prj3grp7/prj3_projekt_dokumentation/Softwaredesign/Demoer/BeerPongTable_LED_Demo/Design01.cydsn/Design01_timing.html

# Static Timing Analysis

Project : | Design01
Build Time : | 10/25/18 20:57:47
Device : | CY8C5888LTI-LP097
Temperature : | -40C - 85/125C
VDDA : | 5.00
VDDABUF : | 5.00
VDDD : | 5.00
VDDIO0 : | 5.00
VDDIO1 : | 5.00
VDDIO2 : | 5.00
VDDIO3 : | 5.00
VUSB : | 5.00
Voltage : | 5.0

Expand All | Collapse All | Show All Paths | Hide All Paths

+ Timing Violation Section

No Timing Violations

+ Clock Summary Section

Clock | Domain | Nominal Frequency | Required Frequency | Maximum Frequency | Violation
ClockBlock/dclk_glb_ff_3 | ClockBlock/dclk_glb_ff_3 | UNKNOWN | UNKNOWN | N/A
CyILO | CyILO | 1.000 kHz | 1.000 kHz | N/A
CyIMO | CyIMO | 3.000 MHz | 3.000 MHz | N/A
CyMASTER_CLK | CyMASTER_CLK | 24.000 MHz | 24.000 MHz | N/A
CyBUS_CLK | CyMASTER_CLK | 24.000 MHz | 24.000 MHz | 60.580 MHz
Clock_SPI | CyMASTER_CLK | 24.000 MHz | 24.000 MHz | 62.089 MHz
Clock_PWM | CyMASTER_CLK | 24.000 MHz | 24.000 MHz | 74.113 MHz
UART_1_IntClock | CyMASTER_CLK | 76.677 kHz | 76.677 kHz | 56.763 MHz
Clock_LedUpdate | CyMASTER_CLK | 366.211 Hz | 366.211 Hz | N/A
CyPLL_OUT | CyPLL_OUT | 24.000 MHz | 24.000 MHz | N/A

+ Register to Register Section

+ Setup Subsection

+ Source Clock : Clock_PWM : Positive edge(Required Frequency 24 MHz)

+ Destination Clock : Clock_PWM : Positive edge(Required Frequency 24 MHz)

Path Delay Requirement : 41.6667ns(24 MHz)

Source | Destination | FMax | Delay (ns) | Slack (ns) | Violation
\PWM_GREEN:PWMUDB:sP8:pwmdp:u0\/z0_comb | \PWM_GREEN:PWMUDB:genblk8:stsreg\/status_2 | 74.113 MHz | 13.493 | 28.174

Type | Location | Fanout | Instance/Net | Source | Dest | Delay (ns)
datapathcell3 | U(0,3) | 1 | \PWM_GREEN:PWMUDB:sP8:pwmdp:u0\ | \PWM_GREEN:PWMUDB:sP8:pwmdp:u0\/clock | \PWM_GREEN:PWMUDB:sP8:pwmdp:u0\/z0_comb | 2.290
Route | | 1 | \PWM_GREEN:PWMUDB:tc_i\ | \PWM_GREEN:PWMUDB:sP8:pwmdp:u0\/z0_comb | \PWM_GREEN:PWMUDB:status_2\/main_1 | 3.672
macrocell3 | U(0,1) | 1 | \PWM_GREEN:PWMUDB:status_2\ | \PWM_GREEN:PWMUDB:status_2\/main_1 | \PWM_GREEN:PWMUDB:status_2\/q | 3.350
Route | | 1 | \PWM_GREEN:PWMUDB:status_2\ | \PWM_GREEN:PWMUDB:status_2\/q | \PWM_GREEN:PWMUDB:genblk8:stsreg\/status_2 | 3.681
statusicell3 | U(0,3) | 1 | \PWM_GREEN:PWMUDB:genblk8:stsreg\ | | SETUP | 0.500
Clock | | | | | Skew | 0.000
\PWM_GREEN:PWMUDB:runmode_enable\/q | \PWM_GREEN:PWMUDB:genblk8:stsreg\/status_2 | 83.084 MHz | 12.036 | 29.631

Type | Location | Fanout | Instance/Net | Source | Dest | Delay (ns)
macrocell25 | U(1,2) | 1 | \PWM_GREEN:PWMUDB:runmode_enable\ | \PWM_GREEN:PWMUDB:runmode_enable\/clock_0 | \PWM_GREEN:PWMUDB:runmode_enable\/q | 1.250
Route | | 1 | \PWM_GREEN:PWMUDB:runmode_enable\ | \PWM_GREEN:PWMUDB:runmode_enable\/q | \PWM_GREEN:PWMUDB:status_2\/main_0 | 3.255
macrocell3 | U(0,1) | 1 | \PWM_GREEN:PWMUDB:status_2\ | \PWM_GREEN:PWMUDB:status_2\/main_0 | \PWM_GREEN:PWMUDB:status_2\/q | 3.350
Route | | 1 | \PWM_GREEN:PWMUDB:status_2\ | \PWM_GREEN:PWMUDB:status_2\/q | \PWM_GREEN:PWMUDB:genblk8:stsreg\/status_2 | 3.681
statusicell3 | U(0,3) | 1 | \PWM_GREEN:PWMUDB:genblk8:stsreg\ | | SETUP | 0.500
Clock | | | | | Skew | 0.000
\PWM_BLUE:PWMUDB:sP8:pwmdp:u0\/z0_comb | \PWM_BLUE:PWMUDB:genblk8:stsreg\/status_2 | 84.324 MHz | 11.859 | 29.808

Type | Location | Fanout | Instance/Net | Source | Dest | Delay (ns)
datapathcell2 | U(1,2) | 1 | \PWM_BLUE:PWMUDB:sP8:pwmdp:u0\ | \PWM_BLUE:PWMUDB:sP8:pwmdp:u0\/clock | \PWM_BLUE:PWMUDB:sP8:pwmdp:u0\/z0_comb | 2.290
Route | | 1 | \PWM_BLUE:PWMUDB:tc_i\ | \PWM_BLUE:PWMUDB:sP8:pwmdp:u0\/z0_comb | \PWM_BLUE:PWMUDB:status_2\/main_1 | 3.404
macrocell2 | U(1,1) | 1 | \PWM_BLUE:PWMUDB:status_2\ | \PWM_BLUE:PWMUDB:status_2\/main_1 | \PWM_BLUE:PWMUDB:status_2\/q | 3.350
Route | | 1 | \PWM_BLUE:PWMUDB:status_2\ | \PWM_BLUE:PWMUDB:status_2\/q | \PWM_BLUE:PWMUDB:genblk8:stsreg\/status_2 | 2.315
statusicell2 | U(1,1) | 1 | \PWM_BLUE:PWMUDB:genblk8:stsreg\ | | SETUP | 0.500
Clock | | | | | Skew | 0.000
\PWM_BLUE:PWMUDB:runmode_enable\/q | \PWM_BLUE:PWMUDB:genblk8:stsreg\/status_2 | 87.642 MHz | 11.410 | 30.257

Type | Location | Fanout | Instance/Net | Source | Dest | Delay (ns)
macrocell21 | U(0,3) | 1 | \PWM_BLUE:PWMUDB:runmode_enable\ | \PWM_BLUE:PWMUDB:runmode_enable\/clock_0 | \PWM_BLUE:PWMUDB:runmode_enable\/q | 1.250
Route | | 1 | \PWM_BLUE:PWMUDB:runmode_enable\ | \PWM_BLUE:PWMUDB:runmode_enable\/q | \PWM_BLUE:PWMUDB:status_2\/main_0 | 3.995
macrocell2 | U(1,1) | 1 | \PWM_BLUE:PWMUDB:status_2\ | \PWM_BLUE:PWMUDB:status_2\/main_0 | \PWM_BLUE:PWMUDB:status_2\/q | 3.350
Route | | 1 | \PWM_BLUE:PWMUDB:status_2\ | \PWM_BLUE:PWMUDB:status_2\/q | \PWM_BLUE:PWMUDB:genblk8:stsreg\/status_2 | 2.315
statusicell2 | U(1,1) | 1 | \PWM_BLUE:PWMUDB:genblk8:stsreg\ | | SETUP | 0.500
Clock | | | | | Skew | 0.000
\PWM_BLUE:PWMUDB:sP8:pwmdp:u0\/z0_comb | \PWM_BLUE:PWMUDB:sP8:pwmdp:u0\/cs_addr_2 | 91.191 MHz | 10.966 | 30.701

Type | Location | Fanout | Instance/Net | Source | Dest | Delay (ns)
datapathcell2 | U(1,2) | 1 | \PWM_BLUE:PWMUDB:sP8:pwmdp:u0\ | \PWM_BLUE:PWMUDB:sP8:pwmdp:u0\/clock | \PWM_BLUE:PWMUDB:sP8:pwmdp:u0\/z0_comb | 2.290
datapathcell2 | U(1,2) | 1 | \PWM_BLUE:PWMUDB:sP8:pwmdp:u0\ | \PWM_BLUE:PWMUDB:sP8:pwmdp:u0\/z0_comb | \PWM_BLUE:PWMUDB:sP8:pwmdp:u0\/cs_addr_2 | 2.616
datapathcell2 | U(1,2) | 1 | \PWM_BLUE:PWMUDB:sP8:pwmdp:u0\ | | SETUP | 6.060
Clock | | | | | Skew | 0.000
\PWM_RED:PWMUDB:sP8:pwmdp:u0\/z0_comb | \PWM_RED:PWMUDB:genblk8:stsreg\/status_2 | 91.500 MHz | 10.929 | 30.738

Type | Location | Fanout | Instance/Net | Source | Dest | Delay (ns)
datapathcell1 | U(1,0) | 1 | \PWM_RED:PWMUDB:sP8:pwmdp:u0\ | \PWM_RED:PWMUDB:sP8:pwmdp:u0\/clock | \PWM_RED:PWMUDB:sP8:pwmdp:u0\/z0_comb | 2.290
Route | | 1 | \PWM_RED:PWMUDB:tc_i\ | \PWM_RED:PWMUDB:sP8:pwmdp:u0\/z0_comb | \PWM_RED:PWMUDB:status_2\/main_1 | 2.538
macrocell1 | U(1,0) | 1 | \PWM_RED:PWMUDB:status_2\ | \PWM_RED:PWMUDB:status_2\/main_1 | \PWM_RED:PWMUDB:status_2\/q | 3.350
Route | | 1 | \PWM_RED:PWMUDB:status_2\ | \PWM_RED:PWMUDB:status_2\/q | \PWM_RED:PWMUDB:genblk8:stsreg\/status_2 | 2.251
statusicell1 | U(1,0) | 1 | \PWM_RED:PWMUDB:genblk8:stsreg\ | | SETUP | 0.500
Clock | | | | | Skew | 0.000
\PWM_RED:PWMUDB:sP8:pwmdp:u0\/z0_comb | \PWM_RED:PWMUDB:sP8:pwmdp:u0\/cs_addr_2 | 91.962 MHz | 10.874 | 30.793

Type | Location | Fanout | Instance/Net | Source | Dest | Delay (ns)
datapathcell1 | U(1,0) | 1 | \PWM_RED:PWMUDB:sP8:pwmdp:u0\ | \PWM_RED:PWMUDB:sP8:pwmdp:u0\/clock | \PWM_RED:PWMUDB:sP8:pwmdp:u0\/z0_comb | 2.290
datapathcell1 | U(1,0) | 1 | \PWM_RED:PWMUDB:sP8:pwmdp:u0\ | \PWM_RED:PWMUDB:sP8:pwmdp:u0\/z0_comb | \PWM_RED:PWMUDB:sP8:pwmdp:u0\/cs_addr_2 | 2.524
datapathcell1 | U(1,0) | 1 | \PWM_RED:PWMUDB:sP8:pwmdp:u0\ | | SETUP | 6.060
Clock | | | | | Skew | 0.000
\PWM_GREEN:PWMUDB:runmode_enable\/q | \PWM_GREEN:PWMUDB:sP8:pwmdp:u0\/cs_addr_1 | 93.197 MHz | 10.730 | 30.937

Type | Location | Fanout | Instance/Net | Source | Dest | Delay (ns)
macrocell25 | U(1,2) | 1 | \PWM_GREEN:PWMUDB:runmode_enable\ | \PWM_GREEN:PWMUDB:runmode_enable\/clock_0 | \PWM_GREEN:PWMUDB:runmode_enable\/q | 1.250
Route | | 1 | \PWM_GREEN:PWMUDB:runmode_enable\ | \PWM_GREEN:PWMUDB:runmode_enable\/q | \PWM_GREEN:PWMUDB:sP8:pwmdp:u0\/cs_addr_1 | 3.420
datapathcell3 | U(0,3) | 1 | \PWM_GREEN:PWMUDB:sP8:pwmdp:u0\ | | SETUP | 6.060
Clock | | | | | Skew | 0.000
\PWM_GREEN:PWMUDB:sP8:pwmdp:u0\/z0_comb | \PWM_GREEN:PWMUDB:sP8:pwmdp:u0\/cs_addr_2 | 94.020 MHz | 10.636 | 31.031

Type | Location | Fanout | Instance/Net | Source | Dest | Delay (ns)
datapathcell3 | U(0,3) | 1 | \PWM_GREEN:PWMUDB:sP8:pwmdp:u0\ | \PWM_GREEN:PWMUDB:sP8:pwmdp:u0\/clock | \PWM_GREEN:PWMUDB:sP8:pwmdp:u0\/z0_comb | 2.290
datapathcell3 | U(0,3) | 1 | \PWM_GREEN:PWMUDB:sP8:pwmdp:u0\ | \PWM_GREEN:PWMUDB:sP8:pwmdp:u0\/z0_comb | \PWM_GREEN:PWMUDB:sP8:pwmdp:u0\/cs_addr_2 | 2.286
datapathcell3 | U(0,3) | 1 | \PWM_GREEN:PWMUDB:sP8:pwmdp:u0\ | | SETUP | 6.060
Clock | | | | | Skew | 0.000
\PWM_BLUE:PWMUDB:runmode_enable\/q | \PWM_BLUE:PWMUDB:sP8:pwmdp:u0\/cs_addr_1 | 94.778 MHz | 10.551 | 31.116

Type | Location | Fanout | Instance/Net | Source | Dest | Delay (ns)
macrocell21 | U(0,3) | 1 | \PWM_BLUE:PWMUDB:runmode_enable\ | \PWM_BLUE:PWMUDB:runmode_enable\/clock_0 | \PWM_BLUE:PWMUDB:runmode_enable\/q | 1.250
Route | | 1 | \PWM_BLUE:PWMUDB:runmode_enable\ | \PWM_BLUE:PWMUDB:runmode_enable\/q | \PWM_BLUE:PWMUDB:sP8:pwmdp:u0\/cs_addr_1 | 3.241
datapathcell2 | U(1,2) | 1 | \PWM_BLUE:PWMUDB:sP8:pwmdp:u0\ | | SETUP | 6.060
Clock | | | | | Skew | 0.000

+ Source Clock : Clock_SPI : Positive edge(Required Frequency 24 MHz)

+ Destination Clock : Clock_SPI : Positive edge(Required Frequency 24 MHz)

Path Delay Requirement : 41.6667ns(24 MHz)

Source | Destination | FMax | Delay (ns) | Slack (ns) | Violation
\SPIM_led_control:BSPIM:sR8:Dp:u0\/f1_blk_stat_comb | \SPIM_led_control:BSPIM:RxStsReg\/status_6 | 62.089 MHz | 16.106 | 25.561

Type | Location | Fanout | Instance/Net | Source | Dest | Delay (ns)
datapathcell7 | U(1,4) | 1 | \SPIM_led_control:BSPIM:sR8:Dp:u0\ | \SPIM_led_control:BSPIM:sR8:Dp:u0\/clock | \SPIM_led_control:BSPIM:sR8:Dp:u0\/f1_blk_stat_comb | 3.580
Route | | 1 | \SPIM_led_control:BSPIM:rx_status_4\ | \SPIM_led_control:BSPIM:sR8:Dp:u0\/f1_blk_stat_comb | \SPIM_led_control:BSPIM:rx_status_6\/main_5 | 5.774
macrocell15 | U(1,3) | 1 | \SPIM_led_control:BSPIM:rx_status_6\ | \SPIM_led_control:BSPIM:rx_status_6\/main_5 | \SPIM_led_control:BSPIM:rx_status_6\/q | 3.350
Route | | 1 | \SPIM_led_control:BSPIM:rx_status_6\ | \SPIM_led_control:BSPIM:rx_status_6\/q | \SPIM_led_control:BSPIM:RxStsReg\/status_6 | 2.902
statusicell7 | U(1,2) | 1 | \SPIM_led_control:BSPIM:RxStsReg\ | | SETUP | 0.500
Clock | | | | | Skew | 0.000
\SPIM_led_control:BSPIM:BitCounter\/count_4 | \SPIM_led_control:BSPIM:sR8:Dp:u0\/f1_load | 66.375 MHz | 15.066 | 26.601

Type | Location | Fanout | Instance/Net | Source | Dest | Delay (ns)
count7cell | U(1,4) | 1 | \SPIM_led_control:BSPIM:BitCounter\ | \SPIM_led_control:BSPIM:BitCounter\/clock | \SPIM_led_control:BSPIM:BitCounter\/count_4 | 1.940
Route | | 1 | \SPIM_led_control:BSPIM:count_4\ | \SPIM_led_control:BSPIM:BitCounter\/count_4 | \SPIM_led_control:BSPIM:load_rx_data\/main_0 | 2.820
macrocell12 | U(1,4) | 1 | \SPIM_led_control:BSPIM:load_rx_data\ | \SPIM_led_control:BSPIM:load_rx_data\/main_0 | \SPIM_led_control:BSPIM:load_rx_data\/q | 3.350
Route | | 1 | \SPIM_led_control:BSPIM:load_rx_data\ | \SPIM_led_control:BSPIM:load_rx_data\/q | \SPIM_led_control:BSPIM:sR8:Dp:u0\/f1_load | 4.106
datapathcell7 | U(1,4) | 1 | \SPIM_led_control:BSPIM:sR8:Dp:u0\ | | SETUP | 2.850
Clock | | | | | Skew | 0.000
\SPIM_led_control:BSPIM:BitCounter\/count_1 | \SPIM_led_control:BSPIM:sR8:Dp:u0\/f1_load | 66.485 MHz | 15.041 | 26.626

Type | Location | Fanout | Instance/Net | Source | Dest | Delay (ns)
count7cell | U(1,4) | 1 | \SPIM_led_control:BSPIM:BitCounter\ | \SPIM_led_control:BSPIM:BitCounter\/clock | \SPIM_led_control:BSPIM:BitCounter\/count_1 | 1.940
Route | | 1 | \SPIM_led_control:BSPIM:count_1\ | \SPIM_led_control:BSPIM:BitCounter\/count_1 | \SPIM_led_control:BSPIM:load_rx_data\/main_3 | 2.795
macrocell12 | U(1,4) | 1 | \SPIM_led_control:BSPIM:load_rx_data\ | \SPIM_led_control:BSPIM:load_rx_data\/main_3 | \SPIM_led_control:BSPIM:load_rx_data\/q | 3.350
Route | | 1 | \SPIM_led_control:BSPIM:load_rx_data\ | \SPIM_led_control:BSPIM:load_rx_data\/q | \SPIM_led_control:BSPIM:sR8:Dp:u0\/f1_load | 4.106
datapathcell7 | U(1,4) | 1 | \SPIM_led_control:BSPIM:sR8:Dp:u0\ | | SETUP | 2.850
Clock | | | | | Skew | 0.000
\SPIM_led_control:BSPIM:BitCounter\/count_2 | \SPIM_led_control:BSPIM:sR8:Dp:u0\/f1_load | 66.498 MHz | 15.038 | 26.629

Type | Location | Fanout | Instance/Net | Source | Dest | Delay (ns)
count7cell | U(1,4) | 1 | \SPIM_led_control:BSPIM:BitCounter\ | \SPIM_led_control:BSPIM:BitCounter\/clock | \SPIM_led_control:BSPIM:BitCounter\/count_2 | 1.940
Route | | 1 | \SPIM_led_control:BSPIM:count_2\ | \SPIM_led_control:BSPIM:BitCounter\/count_2 | \SPIM_led_control:BSPIM:load_rx_data\/main_2 | 2.792
macrocell12 | U(1,4) | 1 | \SPIM_led_control:BSPIM:load_rx_data\ | \SPIM_led_control:BSPIM:load_rx_data\/main_2 | \SPIM_led_control:BSPIM:load_rx_data\/q | 3.350
Route | | 1 | \SPIM_led_control:BSPIM:load_rx_data\ | \SPIM_led_control:BSPIM:load_rx_data\/q | \SPIM_led_control:BSPIM:sR8:Dp:u0\/f1_load | 4.106
datapathcell7 | U(1,4) | 1 | \SPIM_led_control:BSPIM:sR8:Dp:u0\ | | SETUP | 2.850
Clock | | | | | Skew | 0.000
\SPIM_led_control:BSPIM:BitCounter\/count_3 | \SPIM_led_control:BSPIM:sR8:Dp:u0\/f1_load | 67.195 MHz | 14.882 | 26.785

Type | Location | Fanout | Instance/Net | Source | Dest | Delay (ns)
count7cell | U(1,4) | 1 | \SPIM_led_control:BSPIM:BitCounter\ | \SPIM_led_control:BSPIM:BitCounter\/clock | \SPIM_led_control:BSPIM:BitCounter\/count_3 | 1.940
Route | | 1 | \SPIM_led_control:BSPIM:count_3\ | \SPIM_led_control:BSPIM:BitCounter\/count_3 | \SPIM_led_control:BSPIM:load_rx_data\/main_1 | 2.636
macrocell12 | U(1,4) | 1 | \SPIM_led_control:BSPIM:load_rx_data\ | \SPIM_led_control:BSPIM:load_rx_data\/main_1 | \SPIM_led_control:BSPIM:load_rx_data\/q | 3.350
Route | | 1 | \SPIM_led_control:BSPIM:load_rx_data\ | \SPIM_led_control:BSPIM:load_rx_data\/q | \SPIM_led_control:BSPIM:sR8:Dp:u0\/f1_load | 4.106
datapathcell7 | U(1,4) | 1 | \SPIM_led_control:BSPIM:sR8:Dp:u0\ | | SETUP | 2.850
Clock | | | | | Skew | 0.000
\SPIM_led_control:BSPIM:BitCounter\/count_0 | \SPIM_led_control:BSPIM:sR8:Dp:u0\/f1_load | 67.272 MHz | 14.865 | 26.802

Type | Location | Fanout | Instance/Net | Source | Dest | Delay (ns)
count7cell | U(1,4) | 1 | \SPIM_led_control:BSPIM:BitCounter\ | \SPIM_led_control:BSPIM:BitCounter\/clock | \SPIM_led_control:BSPIM:BitCounter\/count_0 | 1.940
Route | | 1 | \SPIM_led_control:BSPIM:count_0\ | \SPIM_led_control:BSPIM:BitCounter\/count_0 | \SPIM_led_control:BSPIM:load_rx_data\/main_4 | 2.619
macrocell12 | U(1,4) | 1 | \SPIM_led_control:BSPIM:load_rx_data\ | \SPIM_led_control:BSPIM:load_rx_data\/main_4 | \SPIM_led_control:BSPIM:load_rx_data\/q | 3.350
Route | | 1 | \SPIM_led_control:BSPIM:load_rx_data\ | \SPIM_led_control:BSPIM:load_rx_data\/q | \SPIM_led_control:BSPIM:sR8:Dp:u0\/f1_load | 4.106
datapathcell7 | U(1,4) | 1 | \SPIM_led_control:BSPIM:sR8:Dp:u0\ | | SETUP | 2.850
Clock | | | | | Skew | 0.000
\SPIM_led_control:BSPIM:BitCounter\/count_4 | \SPIM_led_control:BSPIM:TxStsReg\/status_3 | 67.875 MHz | 14.733 | 26.934

Type | Location | Fanout | Instance/Net | Source | Dest | Delay (ns)
count7cell | U(1,4) | 1 | \SPIM_led_control:BSPIM:BitCounter\ | \SPIM_led_control:BSPIM:BitCounter\/clock | \SPIM_led_control:BSPIM:BitCounter\/count_4 | 1.940
Route | | 1 | \SPIM_led_control:BSPIM:count_4\ | \SPIM_led_control:BSPIM:BitCounter\/count_4 | \SPIM_led_control:BSPIM:load_rx_data\/main_0 | 2.820
macrocell12 | U(1,4) | 1 | \SPIM_led_control:BSPIM:load_rx_data\ | \SPIM_led_control:BSPIM:load_rx_data\/main_0 | \SPIM_led_control:BSPIM:load_rx_data\/q | 3.350
Route | | 1 | \SPIM_led_control:BSPIM:load_rx_data\ | \SPIM_led_control:BSPIM:load_rx_data\/q | \SPIM_led_control:BSPIM:TxStsReg\/status_3 | 6.123
statusicell6 | U(1,3) | 1 | \SPIM_led_control:BSPIM:TxStsReg\ | | SETUP | 0.500
Clock | | | | | Skew | 0.000
\SPIM_led_control:BSPIM:BitCounter\/count_1 | \SPIM_led_control:BSPIM:TxStsReg\/status_3 | 67.990 MHz | 14.708 | 26.959

Type | Location | Fanout | Instance/Net | Source | Dest | Delay (ns)
count7cell | U(1,4) | 1 | \SPIM_led_control:BSPIM:BitCounter\ | \SPIM_led_control:BSPIM:BitCounter\/clock | \SPIM_led_control:BSPIM:BitCounter\/count_1 | 1.940
Route | | 1 | \SPIM_led_control:BSPIM:count_1\ | \SPIM_led_control:BSPIM:BitCounter\/count_1 | \SPIM_led_control:BSPIM:load_rx_data\/main_3 | 2.795
macrocell12 | U(1,4) | 1 | \SPIM_led_control:BSPIM:load_rx_data\ | \SPIM_led_control:BSPIM:load_rx_data\/main_3 | \SPIM_led_control:BSPIM:load_rx_data\/q | 3.350
Route | | 1 | \SPIM_led_control:BSPIM:load_rx_data\ | \SPIM_led_control:BSPIM:load_rx_data\/q | \SPIM_led_control:BSPIM:TxStsReg\/status_3 | 6.123
statusicell6 | U(1,3) | 1 | \SPIM_led_control:BSPIM:TxStsReg\ | | SETUP | 0.500
Clock | | | | | Skew | 0.000
\SPIM_led_control:BSPIM:BitCounter\/count_2 | \SPIM_led_control:BSPIM:TxStsReg\/status_3 | 68.004 MHz | 14.705 | 26.962

Type | Location | Fanout | Instance/Net | Source | Dest | Delay (ns)
count7cell | U(1,4) | 1 | \SPIM_led_control:BSPIM:BitCounter\ | \SPIM_led_control:BSPIM:BitCounter\/clock | \SPIM_led_control:BSPIM:BitCounter\/count_2 | 1.940
Route | | 1 | \SPIM_led_control:BSPIM:count_2\ | \SPIM_led_control:BSPIM:BitCounter\/count_2 | \SPIM_led_control:BSPIM:load_rx_data\/main_2 | 2.792
macrocell12 | U(1,4) | 1 | \SPIM_led_control:BSPIM:load_rx_data\ | \SPIM_led_control:BSPIM:load_rx_data\/main_2 | \SPIM_led_control:BSPIM:load_rx_data\/q | 3.350
Route | | 1 | \SPIM_led_control:BSPIM:load_rx_data\ | \SPIM_led_control:BSPIM:load_rx_data\/q | \SPIM_led_control:BSPIM:TxStsReg\/status_3 | 6.123
statusicell6 | U(1,3) | 1 | \SPIM_led_control:BSPIM:TxStsReg\ | | SETUP | 0.500
Clock | | | | | Skew | 0.000
\SPIM_led_control:BSPIM:BitCounter\/count_3 | \SPIM_led_control:BSPIM:TxStsReg\/status_3 | 68.733 MHz | 14.549 | 27.118

Type | Location | Fanout | Instance/Net | Source | Dest | Delay (ns)
count7cell | U(1,4) | 1 | \SPIM_led_control:BSPIM:BitCounter\ | \SPIM_led_control:BSPIM:BitCounter\/clock | \SPIM_led_control:BSPIM:BitCounter\/count_3 | 1.940
Route | | 1 | \SPIM_led_control:BSPIM:count_3\ | \SPIM_led_control:BSPIM:BitCounter\/count_3 | \SPIM_led_control:BSPIM:load_rx_data\/main_1 | 2.636
macrocell12 | U(1,4) | 1 | \SPIM_led_control:BSPIM:load_rx_data\ | \SPIM_led_control:BSPIM:load_rx_data\/main_1 | \SPIM_led_control:BSPIM:load_rx_data\/q | 3.350
Route | | 1 | \SPIM_led_control:BSPIM:load_rx_data\ | \SPIM_led_control:BSPIM:load_rx_data\/q | \SPIM_led_control:BSPIM:TxStsReg\/status_3 | 6.123
statusicell6 | U(1,3) | 1 | \SPIM_led_control:BSPIM:TxStsReg\ | | SETUP | 0.500
Clock | | | | | Skew | 0.000

+ Source Clock : CyBUS_CLK : Positive edge(Required Frequency 24 MHz)

+ Destination Clock : UART_1_IntClock : Positive edge(Required Frequency 76.6773 kHz)

Path Delay Requirement : 41.6667ns(24 MHz)

Affects clock : CyMASTER_CLK

Source | Destination | FMax | Delay (ns) | Slack (ns) | Violation
Rx_1(0)/fb | \UART_1:BUART:sRX:RxShifter:u0\/route_si | 60.580 MHz | 16.507 | 25.160

Type | Location | Fanout | Instance/Net | Source | Dest | Delay (ns)
iocell4 | P12[6] | 1 | Rx_1(0) | Rx_1(0)/in_clock | Rx_1(0)/fb | 2.009
Route | | 1 | Net_117 | Rx_1(0)/fb | \UART_1:BUART:rx_postpoll\/main_1 | 5.451
macrocell9 | U(0,0) | 1 | \UART_1:BUART:rx_postpoll\ | \UART_1:BUART:rx_postpoll\/main_1 | \UART_1:BUART:rx_postpoll\/q | 3.350
Route | | 1 | \UART_1:BUART:rx_postpoll\ | \UART_1:BUART:rx_postpoll\/q | \UART_1:BUART:sRX:RxShifter:u0\/route_si | 2.227
datapathcell6 | U(0,0) | 1 | \UART_1:BUART:sRX:RxShifter:u0\ | | SETUP | 3.470
Clock | | | | | Skew | 0.000
Rx_1(0)/fb | \UART_1:BUART:rx_state_0\/main_9 | 85.222 MHz | 11.734 | 29.933

Type | Location | Fanout | Instance/Net | Source | Dest | Delay (ns)
iocell4 | P12[6] | 1 | Rx_1(0) | Rx_1(0)/in_clock | Rx_1(0)/fb | 2.009
Route | | 1 | Net_117 | Rx_1(0)/fb | \UART_1:BUART:rx_state_0\/main_9 | 6.215
macrocell35 | U(0,1) | 1 | \UART_1:BUART:rx_state_0\ | | SETUP | 3.510
Clock | | | | | Skew | 0.000
Rx_1(0)/fb | \UART_1:BUART:rx_status_3\/main_6 | 85.222 MHz | 11.734 | 29.933

Type | Location | Fanout | Instance/Net | Source | Dest | Delay (ns)
iocell4 | P12[6] | 1 | Rx_1(0) | Rx_1(0)/in_clock | Rx_1(0)/fb | 2.009
Route | | 1 | Net_117 | Rx_1(0)/fb | \UART_1:BUART:rx_status_3\/main_6 | 6.215
macrocell43 | U(0,1) | 1 | \UART_1:BUART:rx_status_3\ | | SETUP | 3.510
Clock | | | | | Skew | 0.000
Rx_1(0)/fb | \UART_1:BUART:rx_state_2\/main_8 | 90.901 MHz | 11.001 | 30.666

Type | Location | Fanout | Instance/Net | Source | Dest | Delay (ns)
iocell4 | P12[6] | 1 | Rx_1(0) | Rx_1(0)/in_clock | Rx_1(0)/fb | 2.009
Route | | 1 | Net_117 | Rx_1(0)/fb | \UART_1:BUART:rx_state_2\/main_8 | 5.482
macrocell38 | U(0,0) | 1 | \UART_1:BUART:rx_state_2\ | | SETUP | 3.510
Clock | | | | | Skew | 0.000
Rx_1(0)/fb | \UART_1:BUART:pollcount_1\/main_3 | 91.158 MHz | 10.970 | 30.697

Type | Location | Fanout | Instance/Net | Source | Dest | Delay (ns)
iocell4 | P12[6] | 1 | Rx_1(0) | Rx_1(0)/in_clock | Rx_1(0)/fb | 2.009
Route | | 1 | Net_117 | Rx_1(0)/fb | \UART_1:BUART:pollcount_1\/main_3 | 5.451
macrocell41 | U(0,0) | 1 | \UART_1:BUART:pollcount_1\ | | SETUP | 3.510
Clock | | | | | Skew | 0.000
Rx_1(0)/fb | \UART_1:BUART:pollcount_0\/main_2 | 91.158 MHz | 10.970 | 30.697

Type | Location | Fanout | Instance/Net | Source | Dest | Delay (ns)
iocell4 | P12[6] | 1 | Rx_1(0) | Rx_1(0)/in_clock | Rx_1(0)/fb | 2.009
Route | | 1 | Net_117 | Rx_1(0)/fb | \UART_1:BUART:pollcount_0\/main_2 | 5.451
macrocell42 | U(0,0) | 1 | \UART_1:BUART:pollcount_0\ | | SETUP | 3.510
Clock | | | | | Skew | 0.000
Rx_1(0)/fb | \UART_1:BUART:rx_last\/main_0 | 91.158 MHz | 10.970 | 30.697

Type | Location | Fanout | Instance/Net | Source | Dest | Delay (ns)
iocell4 | P12[6] | 1 | Rx_1(0) | Rx_1(0)/in_clock | Rx_1(0)/fb | 2.009
Route | | 1 | Net_117 | Rx_1(0)/fb | \UART_1:BUART:rx_last\/main_0 | 5.451
macrocell44 | U(0,0) | 1 | \UART_1:BUART:rx_last\ | | SETUP | 3.510
Clock | | | | | Skew | 0.000

+ Source Clock : UART_1_IntClock : Positive edge(Required Frequency 76.6773 kHz)

+ Destination Clock : UART_1_IntClock : Positive edge(Required Frequency 76.6773 kHz)

Path Delay Requirement : 13041.7ns(76.6773 kHz)

Source | Destination | FMax | Delay (ns) | Slack (ns) | Violation
\UART_1:BUART:tx_state_0\/q | \UART_1:BUART:sTX:sCLOCK:TxBitClkGen\/cs_addr_0 | 56.763 MHz | 17.617 | 13024.050

Type | Location | Fanout | Instance/Net | Source | Dest | Delay (ns)
macrocell31 | U(0,2) | 1 | \UART_1:BUART:tx_state_0\ | \UART_1:BUART:tx_state_0\/clock_0 | \UART_1:BUART:tx_state_0\/q | 1.250
Route | | 1 | \UART_1:BUART:tx_state_0\ | \UART_1:BUART:tx_state_0\/q | \UART_1:BUART:counter_load_not\/main_1 | 4.518
macrocell5 | U(0,2) | 1 | \UART_1:BUART:counter_load_not\ | \UART_1:BUART:counter_load_not\/main_1 | \UART_1:BUART:counter_load_not\/q | 3.350
Route | | 1 | \UART_1:BUART:counter_load_not\ | \UART_1:BUART:counter_load_not\/q | \UART_1:BUART:sTX:sCLOCK:TxBitClkGen\/cs_addr_0 | 2.309
datapathcell5 | U(0,2) | 1 | \UART_1:BUART:sTX:sCLOCK:TxBitClkGen\ | | SETUP | 6.190
Clock | | | | | Skew | 0.000
\UART_1:BUART:tx_state_1\/q | \UART_1:BUART:sTX:sCLOCK:TxBitClkGen\/cs_addr_0 | 60.562 MHz | 16.512 | 13025.155

Type | Location | Fanout | Instance/Net | Source | Dest | Delay (ns)
macrocell30 | U(0,3) | 1 | \UART_1:BUART:tx_state_1\ | \UART_1:BUART:tx_state_1\/clock_0 | \UART_1:BUART:tx_state_1\/q | 1.250
Route | | 1 | \UART_1:BUART:tx_state_1\ | \UART_1:BUART:tx_state_1\/q | \UART_1:BUART:counter_load_not\/main_0 | 3.413
macrocell5 | U(0,2) | 1 | \UART_1:BUART:counter_load_not\ | \UART_1:BUART:counter_load_not\/main_0 | \UART_1:BUART:counter_load_not\/q | 3.350
Route | | 1 | \UART_1:BUART:counter_load_not\ | \UART_1:BUART:counter_load_not\/q | \UART_1:BUART:sTX:sCLOCK:TxBitClkGen\/cs_addr_0 | 2.309
datapathcell5 | U(0,2) | 1 | \UART_1:BUART:sTX:sCLOCK:TxBitClkGen\ | | SETUP | 6.190
Clock | | | | | Skew | 0.000
\UART_1:BUART:tx_state_2\/q | \UART_1:BUART:sTX:sCLOCK:TxBitClkGen\/cs_addr_0 | 62.937 MHz | 15.889 | 13025.778

Type | Location | Fanout | Instance/Net | Source | Dest | Delay (ns)
macrocell32 | U(0,2) | 1 | \UART_1:BUART:tx_state_2\ | \UART_1:BUART:tx_state_2\/clock_0 | \UART_1:BUART:tx_state_2\/q | 1.250
Route | | 1 | \UART_1:BUART:tx_state_2\ | \UART_1:BUART:tx_state_2\/q | \UART_1:BUART:counter_load_not\/main_3 | 2.790
macrocell5 | U(0,2) | 1 | \UART_1:BUART:counter_load_not\ | \UART_1:BUART:counter_load_not\/main_3 | \UART_1:BUART:counter_load_not\/q | 3.350
Route | | 1 | \UART_1:BUART:counter_load_not\ | \UART_1:BUART:counter_load_not\/q | \UART_1:BUART:sTX:sCLOCK:TxBitClkGen\/cs_addr_0 | 2.309
datapathcell5 | U(0,2) | 1 | \UART_1:BUART:sTX:sCLOCK:TxBitClkGen\ | | SETUP | 6.190
Clock | | | | | Skew | 0.000
\UART_1:BUART:rx_state_2\/q | \UART_1:BUART:sRX:RxBitCounter\/load | 64.181 MHz | 15.581 | 13026.086

Type | Location | Fanout | Instance/Net | Source | Dest | Delay (ns)
macrocell38 | U(0,0) | 1 | \UART_1:BUART:rx_state_2\ | \UART_1:BUART:rx_state_2\/clock_0 | \UART_1:BUART:rx_state_2\/q | 1.250
Route | | 1 | \UART_1:BUART:rx_state_2\ | \UART_1:BUART:rx_state_2\/q | \UART_1:BUART:rx_counter_load\/main_3 | 3.303
macrocell8 | U(0,1) | 1 | \UART_1:BUART:rx_counter_load\ | \UART_1:BUART:rx_counter_load\/main_3 | \UART_1:BUART:rx_counter_load\/q | 3.350
Route | | 1 | \UART_1:BUART:rx_counter_load\ | \UART_1:BUART:rx_counter_load\/q | \UART_1:BUART:sRX:RxBitCounter\/load | 2.318
count7cell | U(0,1) | 1 | \UART_1:BUART:sRX:RxBitCounter\ | | SETUP | 5.360
Clock | | | | | Skew | 0.000
\UART_1:BUART:rx_state_3\/q | \UART_1:BUART:sRX:RxBitCounter\/load | 64.189 MHz | 15.579 | 13026.088

Type | Location | Fanout | Instance/Net | Source | Dest | Delay (ns)
macrocell37 | U(0,0) | 1 | \UART_1:BUART:rx_state_3\ | \UART_1:BUART:rx_state_3\/clock_0 | \UART_1:BUART:rx_state_3\/q | 1.250
Route | | 1 | \UART_1:BUART:rx_state_3\ | \UART_1:BUART:rx_state_3\/q | \UART_1:BUART:rx_counter_load\/main_2 | 3.301
macrocell8 | U(0,1) | 1 | \UART_1:BUART:rx_counter_load\ | \UART_1:BUART:rx_counter_load\/main_2 | \UART_1:BUART:rx_counter_load\/q | 3.350
Route | | 1 | \UART_1:BUART:rx_counter_load\ | \UART_1:BUART:rx_counter_load\/q | \UART_1:BUART:sRX:RxBitCounter\/load | 2.318
count7cell | U(0,1) | 1 | \UART_1:BUART:sRX:RxBitCounter\ | | SETUP | 5.360
Clock | | | | | Skew | 0.000
\UART_1:BUART:tx_ctrl_mark_last\/q | \UART_1:BUART:sRX:RxBitCounter\/load | 64.700 MHz | 15.456 | 13026.211

Type | Location | Fanout | Instance/Net | Source | Dest | Delay (ns)
macrocell34 | U(0,1) | 1 | \UART_1:BUART:tx_ctrl_mark_last\ | \UART_1:BUART:tx_ctrl_mark_last\/clock_0 | \UART_1:BUART:tx_ctrl_mark_last\/q | 1.250
Route | | 1 | \UART_1:BUART:tx_ctrl_mark_last\ | \UART_1:BUART:tx_ctrl_mark_last\/q | \UART_1:BUART:rx_counter_load\/main_0 | 3.178
macrocell8 | U(0,1) | 1 | \UART_1:BUART:rx_counter_load\ | \UART_1:BUART:rx_counter_load\/main_0 | \UART_1:BUART:rx_counter_load\/q | 3.350
Route | | 1 | \UART_1:BUART:rx_counter_load\ | \UART_1:BUART:rx_counter_load\/q | \UART_1:BUART:sRX:RxBitCounter\/load | 2.318
count7cell | U(0,1) | 1 | \UART_1:BUART:sRX:RxBitCounter\ | | SETUP | 5.360
Clock | | | | | Skew | 0.000
\UART_1:BUART:sTX:sCLOCK:TxBitClkGen\/ce0_reg | \UART_1:BUART:sTX:sCLOCK:TxBitClkGen\/cs_addr_0 | 65.595 MHz | 15.245 | 13026.422

Type | Location | Fanout | Instance/Net | Source | Dest | Delay (ns)
datapathcell5 | U(0,2) | 1 | \UART_1:BUART:sTX:sCLOCK:TxBitClkGen\ | \UART_1:BUART:sTX:sCLOCK:TxBitClkGen\/clock | \UART_1:BUART:sTX:sCLOCK:TxBitClkGen\/ce0_reg | 0.190
Route | | 1 | \UART_1:BUART:tx_bitclk_enable_pre\ | \UART_1:BUART:sTX:sCLOCK:TxBitClkGen\/ce0_reg | \UART_1:BUART:counter_load_not\/main_2 | 3.206
macrocell5 | U(0,2) | 1 | \UART_1:BUART:counter_load_not\ | \UART_1:BUART:counter_load_not\/main_2 | \UART_1:BUART:counter_load_not\/q | 3.350
Route | | 1 | \UART_1:BUART:counter_load_not\ | \UART_1:BUART:counter_load_not\/q | \UART_1:BUART:sTX:sCLOCK:TxBitClkGen\/cs_addr_0 | 2.309
datapathcell5 | U(0,2) | 1 | \UART_1:BUART:sTX:sCLOCK:TxBitClkGen\ | | SETUP | 6.190
Clock | | | | | Skew | 0.000
\UART_1:BUART:rx_state_0\/q | \UART_1:BUART:sRX:RxBitCounter\/load | 68.597 MHz | 14.578 | 13027.089

Type | Location | Fanout | Instance/Net | Source | Dest | Delay (ns)
macrocell35 | U(0,1) | 1 | \UART_1:BUART:rx_state_0\ | \UART_1:BUART:rx_state_0\/clock_0 | \UART_1:BUART:rx_state_0\/q | 1.250
Route | | 1 | \UART_1:BUART:rx_state_0\ | \UART_1:BUART:rx_state_0\/q | \UART_1:BUART:rx_counter_load\/main_1 | 2.300
macrocell8 | U(0,1) | 1 | \UART_1:BUART:rx_counter_load\ | \UART_1:BUART:rx_counter_load\/main_1 | \UART_1:BUART:rx_counter_load\/q | 3.350
Route | | 1 | \UART_1:BUART:rx_counter_load\ | \UART_1:BUART:rx_counter_load\/q | \UART_1:BUART:sRX:RxBitCounter\/load | 2.318
count7cell | U(0,1) | 1 | \UART_1:BUART:sRX:RxBitCounter\ | | SETUP | 5.360
Clock | | | | | Skew | 0.000
\UART_1:BUART:sTX:TxShifter:u0\/f0_blk_stat_comb | \UART_1:BUART:sTX:TxSts\/status_0 | 74.929 MHz | 13.346 | 13028.321

Type | Location | Fanout | Instance/Net | Source | Dest | Delay (ns)
datapathcell4 | U(0,1) | 1 | \UART_1:BUART:sTX:TxShifter:u0\ | \UART_1:BUART:sTX:TxShifter:u0\/clock | \UART_1:BUART:sTX:TxShifter:u0\/f0_blk_stat_comb | 3.580
Route | | 1 | \UART_1:BUART:tx_fifo_empty\ | \UART_1:BUART:sTX:TxShifter:u0\/f0_blk_stat_comb | \UART_1:BUART:tx_status_0\/main_3 | 3.593
macrocell6 | U(0,2) | 1 | \UART_1:BUART:tx_status_0\ | \UART_1:BUART:tx_status_0\/main_3 | \UART_1:BUART:tx_status_0\/q | 3.350
Route | | 1 | \UART_1:BUART:tx_status_0\ | \UART_1:BUART:tx_status_0\/q | \UART_1:BUART:sTX:TxSts\/status_0 | 2.323
statusicell4 | U(0,2) | 1 | \UART_1:BUART:sTX:TxSts\ | | SETUP | 0.500
Clock | | | | | Skew | 0.000
\UART_1:BUART:sRX:RxShifter:u0\/f0_blk_stat_comb | \UART_1:BUART:sRX:RxSts\/status_4 | 76.150 MHz | 13.132 | 13028.535

Type | Location | Fanout | Instance/Net | Source | Dest | Delay (ns)
datapathcell6 | U(0,0) | 1 | \UART_1:BUART:sRX:RxShifter:u0\ | \UART_1:BUART:sRX:RxShifter:u0\/clock | \UART_1:BUART:sRX:RxShifter:u0\/f0_blk_stat_comb | 3.580
Route | | 1 | \UART_1:BUART:rx_fifofull\ | \UART_1:BUART:sRX:RxShifter:u0\/f0_blk_stat_comb | \UART_1:BUART:rx_status_4\/main_1 | 2.831
macrocell10 | U(0,1) | 1 | \UART_1:BUART:rx_status_4\ | \UART_1:BUART:rx_status_4\/main_1 | \UART_1:BUART:rx_status_4\/q | 3.350
Route | | 1 | \UART_1:BUART:rx_status_4\ | \UART_1:BUART:rx_status_4\/q | \UART_1:BUART:sRX:RxSts\/status_4 | 2.871
statusicell5 | U(0,0) | 1 | \UART_1:BUART:sRX:RxSts\ | | SETUP | 0.500
Clock | | | | | Skew | 0.000

+ Hold Subsection

+ Source Clock : Clock_PWM : Positive edge

+ Destination Clock : Clock_PWM : Positive edge

Source | Destination | Slack (ns) | Violation
\PWM_GREEN:PWMUDB:status_0\/q | \PWM_GREEN:PWMUDB:genblk8:stsreg\/status_0 | 1.580

Type | Location | Fanout | Instance/Net | Source | Dest | Delay (ns)
macrocell27 | U(0,3) | 1 | \PWM_GREEN:PWMUDB:status_0\ | \PWM_GREEN:PWMUDB:status_0\/clock_0 | \PWM_GREEN:PWMUDB:status_0\/q | 1.250
Route | | 1 | \PWM_GREEN:PWMUDB:status_0\ | \PWM_GREEN:PWMUDB:status_0\/q | \PWM_GREEN:PWMUDB:genblk8:stsreg\/status_0 | 2.330
statusicell3 | U(0,3) | 1 | \PWM_GREEN:PWMUDB:genblk8:stsreg\ | | HOLD | -2.000
Clock | | | | | Skew | 0.000
\PWM_RED:PWMUDB:genblk1:ctrlreg\/control_7 | \PWM_RED:PWMUDB:runmode_enable\/main_0 | 2.623

Type | Location | Fanout | Instance/Net | Source | Dest | Delay (ns)
controlcell1 | U(1,0) | 1 | \PWM_RED:PWMUDB:genblk1:ctrlreg\ | \PWM_RED:PWMUDB:genblk1:ctrlreg\/clock | \PWM_RED:PWMUDB:genblk1:ctrlreg\/control_7 | 0.360
Route | | 1 | \PWM_RED:PWMUDB:control_7\ | \PWM_RED:PWMUDB:genblk1:ctrlreg\/control_7 | \PWM_RED:PWMUDB:runmode_enable\/main_0 | 2.263
macrocell17 | U(1,0) | 1 | \PWM_RED:PWMUDB:runmode_enable\ | | HOLD | 0.000
Clock | | | | | Skew | 0.000
\PWM_RED:PWMUDB:status_0\/q | \PWM_RED:PWMUDB:genblk8:stsreg\/status_0 | 2.873

Type | Location | Fanout | Instance/Net | Source | Dest | Delay (ns)
macrocell19 | U(1,2) | 1 | \PWM_RED:PWMUDB:status_0\ | \PWM_RED:PWMUDB:status_0\/clock_0 | \PWM_RED:PWMUDB:status_0\/q | 1.250
Route | | 1 | \PWM_RED:PWMUDB:status_0\ | \PWM_RED:PWMUDB:status_0\/q | \PWM_RED:PWMUDB:genblk8:stsreg\/status_0 | 3.623
statusicell1 | U(1,0) | 1 | \PWM_RED:PWMUDB:genblk8:stsreg\ | | HOLD | -2.000
Clock | | | | | Skew | 0.000
\PWM_RED:PWMUDB:sP8:pwmdp:u0\/cl0_comb | Net_29/main_1 | 3.030

Type | Location | Fanout | Instance/Net | Source | Dest | Delay (ns)
datapathcell1 | U(1,0) | 1 | \PWM_RED:PWMUDB:sP8:pwmdp:u0\ | \PWM_RED:PWMUDB:sP8:pwmdp:u0\/clock | \PWM_RED:PWMUDB:sP8:pwmdp:u0\/cl0_comb | 0.780
Route | | 1 | \PWM_RED:PWMUDB:cmp1_less\ | \PWM_RED:PWMUDB:sP8:pwmdp:u0\/cl0_comb | Net_29/main_1 | 2.250
macrocell20 | U(1,0) | 1 | Net_29 | | HOLD | 0.000
Clock | | | | | Skew | 0.000
\PWM_GREEN:PWMUDB:sP8:pwmdp:u0\/cl0_comb | \PWM_GREEN:PWMUDB:prevCompare1\/main_0 | 3.072

Type | Location | Fanout | Instance/Net | Source | Dest | Delay (ns)
datapathcell3 | U(0,3) | 1 | \PWM_GREEN:PWMUDB:sP8:pwmdp:u0\ | \PWM_GREEN:PWMUDB:sP8:pwmdp:u0\/clock | \PWM_GREEN:PWMUDB:sP8:pwmdp:u0\/cl0_comb | 0.780
Route | | 1 | \PWM_GREEN:PWMUDB:cmp1_less\ | \PWM_GREEN:PWMUDB:sP8:pwmdp:u0\/cl0_comb | \PWM_GREEN:PWMUDB:prevCompare1\/main_0 | 2.292
macrocell26 | U(0,3) | 1 | \PWM_GREEN:PWMUDB:prevCompare1\ | | HOLD | 0.000
Clock | | | | | Skew | 0.000
\PWM_GREEN:PWMUDB:sP8:pwmdp:u0\/cl0_comb | \PWM_GREEN:PWMUDB:status_0\/main_1 | 3.072

Type | Location | Fanout | Instance/Net | Source | Dest | Delay (ns)
datapathcell3 | U(0,3) | 1 | \PWM_GREEN:PWMUDB:sP8:pwmdp:u0\ | \PWM_GREEN:PWMUDB:sP8:pwmdp:u0\/clock | \PWM_GREEN:PWMUDB:sP8:pwmdp:u0\/cl0_comb | 0.780
Route | | 1 | \PWM_GREEN:PWMUDB:cmp1_less\ | \PWM_GREEN:PWMUDB:sP8:pwmdp:u0\/cl0_comb | \PWM_GREEN:PWMUDB:status_0\/main_1 | 2.292
macrocell27 | U(0,3) | 1 | \PWM_GREEN:PWMUDB:status_0\ | | HOLD | 0.000
Clock | | | | | Skew | 0.000
\PWM_GREEN:PWMUDB:sP8:pwmdp:u0\/cl0_comb | Net_785/main_1 | 3.072

Type | Location | Fanout | Instance/Net | Source | Dest | Delay (ns)
datapathcell3 | U(0,3) | 1 | \PWM_GREEN:PWMUDB:sP8:pwmdp:u0\ | \PWM_GREEN:PWMUDB:sP8:pwmdp:u0\/clock | \PWM_GREEN:PWMUDB:sP8:pwmdp:u0\/cl0_comb | 0.780
Route | | 1 | \PWM_GREEN:PWMUDB:cmp1_less\ | \PWM_GREEN:PWMUDB:sP8:pwmdp:u0\/cl0_comb | Net_785/main_1 | 2.292
macrocell28 | U(0,3) | 1 | Net_785 | | HOLD | 0.000
Clock | | | | | Skew | 0.000
\PWM_GREEN:PWMUDB:genblk1:ctrlreg\/control_7 | \PWM_GREEN:PWMUDB:runmode_enable\/main_0 | 3.256

Type | Location | Fanout | Instance/Net | Source | Dest | Delay (ns)
controlcell3 | U(1,1) | 1 | \PWM_GREEN:PWMUDB:genblk1:ctrlreg\ | \PWM_GREEN:PWMUDB:genblk1:ctrlreg\/clock | \PWM_GREEN:PWMUDB:genblk1:ctrlreg\/control_7 | 0.360
Route | | 1 | \PWM_GREEN:PWMUDB:control_7\ | \PWM_GREEN:PWMUDB:genblk1:ctrlreg\/control_7 | \PWM_GREEN:PWMUDB:runmode_enable\/main_0 | 2.896
macrocell25 | U(1,2) | 1 | \PWM_GREEN:PWMUDB:runmode_enable\ | | HOLD | 0.000
Clock | | | | | Skew | 0.000
\PWM_BLUE:PWMUDB:genblk1:ctrlreg\/control_7 | \PWM_BLUE:PWMUDB:runmode_enable\/main_0 | 3.303

Type | Location | Fanout | Instance/Net | Source | Dest | Delay (ns)
controlcell2 | U(0,4) | 1 | \PWM_BLUE:PWMUDB:genblk1:ctrlreg\ | \PWM_BLUE:PWMUDB:genblk1:ctrlreg\/clock | \PWM_BLUE:PWMUDB:genblk1:ctrlreg\/control_7 | 0.360
Route | | 1 | \PWM_BLUE:PWMUDB:control_7\ | \PWM_BLUE:PWMUDB:genblk1:ctrlreg\/control_7 | \PWM_BLUE:PWMUDB:runmode_enable\/main_0 | 2.943
macrocell21 | U(0,3) | 1 | \PWM_BLUE:PWMUDB:runmode_enable\ | | HOLD | 0.000
Clock | | | | | Skew | 0.000
\PWM_RED:PWMUDB:prevCompare1\/q | \PWM_RED:PWMUDB:status_0\/main_0 | 3.536

Type | Location | Fanout | Instance/Net | Source | Dest | Delay (ns)
macrocell18 | U(1,2) | 1 | \PWM_RED:PWMUDB:prevCompare1\ | \PWM_RED:PWMUDB:prevCompare1\/clock_0 | \PWM_RED:PWMUDB:prevCompare1\/q | 1.250
Route | | 1 | \PWM_RED:PWMUDB:prevCompare1\ | \PWM_RED:PWMUDB:prevCompare1\/q | \PWM_RED:PWMUDB:status_0\/main_0 | 2.286
macrocell19 | U(1,2) | 1 | \PWM_RED:PWMUDB:status_0\ | | HOLD | 0.000
Clock | | | | | Skew | 0.000

+ Source Clock : Clock_SPI : Positive edge

+ Destination Clock : Clock_SPI : Positive edge

Source | Destination | Slack (ns) | Violation
\SPIM_led_control:BSPIM:BitCounter\/count_0 | \SPIM_led_control:BSPIM:state_2\/main_7 | 3.228

Type | Location | Fanout | Instance/Net | Source | Dest | Delay (ns)
count7cell | U(1,4) | 1 | \SPIM_led_control:BSPIM:BitCounter\ | \SPIM_led_control:BSPIM:BitCounter\/clock | \SPIM_led_control:BSPIM:BitCounter\/count_0 | 0.620
Route | | 1 | \SPIM_led_control:BSPIM:count_0\ | \SPIM_led_control:BSPIM:BitCounter\/count_0 | \SPIM_led_control:BSPIM:state_2\/main_7 | 2.608
macrocell46 | U(1,4) | 1 | \SPIM_led_control:BSPIM:state_2\ | | HOLD | 0.000
Clock | | | | | Skew | 0.000
\SPIM_led_control:BSPIM:BitCounter\/count_0 | \SPIM_led_control:BSPIM:state_1\/main_7 | 3.228

Type | Location | Fanout | Instance/Net | Source | Dest | Delay (ns)
count7cell | U(1,4) | 1 | \SPIM_led_control:BSPIM:BitCounter\ | \SPIM_led_control:BSPIM:BitCounter\/clock | \SPIM_led_control:BSPIM:BitCounter\/count_0 | 0.620
Route | | 1 | \SPIM_led_control:BSPIM:count_0\ | \SPIM_led_control:BSPIM:BitCounter\/count_0 | \SPIM_led_control:BSPIM:state_1\/main_7 | 2.608
macrocell47 | U(1,4) | 1 | \SPIM_led_control:BSPIM:state_1\ | | HOLD | 0.000
Clock | | | | | Skew | 0.000
\SPIM_led_control:BSPIM:BitCounter\/count_0 | \SPIM_led_control:BSPIM:ld_ident\/main_7 | 3.228

Type | Location | Fanout | Instance/Net | Source | Dest | Delay (ns)
count7cell | U(1,4) | 1 | \SPIM_led_control:BSPIM:BitCounter\ | \SPIM_led_control:BSPIM:BitCounter\/clock | \SPIM_led_control:BSPIM:BitCounter\/count_0 | 0.620
Route | | 1 | \SPIM_led_control:BSPIM:count_0\ | \SPIM_led_control:BSPIM:BitCounter\/count_0 | \SPIM_led_control:BSPIM:ld_ident\/main_7 | 2.608
macrocell51 | U(1,4) | 1 | \SPIM_led_control:BSPIM:ld_ident\ | | HOLD | 0.000
Clock | | | | | Skew | 0.000
\SPIM_led_control:BSPIM:BitCounter\/count_0 | Net_1225/main_9 | 3.239

Type | Location | Fanout | Instance/Net | Source | Dest | Delay (ns)
count7cell | U(1,4) | 1 | \SPIM_led_control:BSPIM:BitCounter\ | \SPIM_led_control:BSPIM:BitCounter\/clock | \SPIM_led_control:BSPIM:BitCounter\/count_0 | 0.620
Route | | 1 | \SPIM_led_control:BSPIM:count_0\ | \SPIM_led_control:BSPIM:BitCounter\/count_0 | Net_1225/main_9 | 2.619
macrocell45 | U(1,4) | 1 | Net_1225 | | HOLD | 0.000
Clock | | | | | Skew | 0.000
\SPIM_led_control:BSPIM:BitCounter\/count_3 | \SPIM_led_control:BSPIM:state_2\/main_4 | 3.247

Type | Location | Fanout | Instance/Net | Source | Dest | Delay (ns)
count7cell | U(1,4) | 1 | \SPIM_led_control:BSPIM:BitCounter\ | \SPIM_led_control:BSPIM:BitCounter\/clock | \SPIM_led_control:BSPIM:BitCounter\/count_3 | 0.620
Route | | 1 | \SPIM_led_control:BSPIM:count_3\ | \SPIM_led_control:BSPIM:BitCounter\/count_3 | \SPIM_led_control:BSPIM:state_2\/main_4 | 2.627
macrocell46 | U(1,4) | 1 | \SPIM_led_control:BSPIM:state_2\ | | HOLD | 0.000
Clock | | | | | Skew | 0.000
\SPIM_led_control:BSPIM:BitCounter\/count_3 | \SPIM_led_control:BSPIM:state_1\/main_4 | 3.247

Type | Location | Fanout | Instance/Net | Source | Dest | Delay (ns)
count7cell | U(1,4) | 1 | \SPIM_led_control:BSPIM:BitCounter\ | \SPIM_led_control:BSPIM:BitCounter\/clock | \SPIM_led_control:BSPIM:BitCounter\/count_3 | 0.620
Route | | 1 | \SPIM_led_control:BSPIM:count_3\ | \SPIM_led_control:BSPIM:BitCounter\/count_3 | \SPIM_led_control:BSPIM:state_1\/main_4 | 2.627
macrocell47 | U(1,4) | 1 | \SPIM_led_control:BSPIM:state_1\ | | HOLD | 0.000
Clock | | | | | Skew | 0.000
\SPIM_led_control:BSPIM:BitCounter\/count_3 | \SPIM_led_control:BSPIM:ld_ident\/main_4 | 3.247

Type | Location | Fanout | Instance/Net | Source | Dest | Delay (ns)
count7cell | U(1,4) | 1 | \SPIM_led_control:BSPIM:BitCounter\ | \SPIM_led_control:BSPIM:BitCounter\/clock | \SPIM_led_control:BSPIM:BitCounter\/count_3 | 0.620
Route | | 1 | \SPIM_led_control:BSPIM:count_3\ | \SPIM_led_control:BSPIM:BitCounter\/count_3 | \SPIM_led_control:BSPIM:ld_ident\/main_4 | 2.627
macrocell51 | U(1,4) | 1 | \SPIM_led_control:BSPIM:ld_ident\ | | HOLD | 0.000
Clock | | | | | Skew | 0.000
\SPIM_led_control:BSPIM:BitCounter\/count_3 | Net_1225/main_6 | 3.256

Type | Location | Fanout | Instance/Net | Source | Dest | Delay (ns)
count7cell | U(1,4) | 1 | \SPIM_led_control:BSPIM:BitCounter\ | \SPIM_led_control:BSPIM:BitCounter\/clock | \SPIM_led_control:BSPIM:BitCounter\/count_3 | 0.620
Route | | 1 | \SPIM_led_control:BSPIM:count_3\ | \SPIM_led_control:BSPIM:BitCounter\/count_3 | Net_1225/main_6 | 2.636
macrocell45 | U(1,4) | 1 | Net_1225 | | HOLD | 0.000
Clock | | | | | Skew | 0.000
\SPIM_led_control:BSPIM:BitCounter\/count_1 | \SPIM_led_control:BSPIM:state_2\/main_6 | 3.411

Type | Location | Fanout | Instance/Net | Source | Dest | Delay (ns)
count7cell | U(1,4) | 1 | \SPIM_led_control:BSPIM:BitCounter\ | \SPIM_led_control:BSPIM:BitCounter\/clock | \SPIM_led_control:BSPIM:BitCounter\/count_1 | 0.620
Route | | 1 | \SPIM_led_control:BSPIM:count_1\ | \SPIM_led_control:BSPIM:BitCounter\/count_1 | \SPIM_led_control:BSPIM:state_2\/main_6 | 2.791
macrocell46 | U(1,4) | 1 | \SPIM_led_control:BSPIM:state_2\ | | HOLD | 0.000
Clock | | | | | Skew | 0.000
\SPIM_led_control:BSPIM:BitCounter\/count_1 | \SPIM_led_control:BSPIM:state_1\/main_6 | 3.411

Type | Location | Fanout | Instance/Net | Source | Dest | Delay (ns)
count7cell | U(1,4) | 1 | \SPIM_led_control:BSPIM:BitCounter\ | \SPIM_led_control:BSPIM:BitCounter\/clock | \SPIM_led_control:BSPIM:BitCounter\/count_1 | 0.620
Route | | 1 | \SPIM_led_control:BSPIM:count_1\ | \SPIM_led_control:BSPIM:BitCounter\/count_1 | \SPIM_led_control:BSPIM:state_1\/main_6 | 2.791
macrocell47 | U(1,4) | 1 | \SPIM_led_control:BSPIM:state_1\ | | HOLD | 0.000
Clock | | | | | Skew | 0.000

+ Source Clock : CyBUS_CLK : Positive edge

+ Destination Clock : UART_1_IntClock : Positive edge

Source | Destination | Slack (ns) | Violation
Rx_1(0)/fb | \UART_1:BUART:pollcount_1\/main_3 | 7.460

Type | Location | Fanout | Instance/Net | Source | Dest | Delay (ns)
iocell4 | P12[6] | 1 | Rx_1(0) | Rx_1(0)/in_clock | Rx_1(0)/fb | 2.009
Route | | 1 | Net_117 | Rx_1(0)/fb | \UART_1:BUART:pollcount_1\/main_3 | 5.451
macrocell41 | U(0,0) | 1 | \UART_1:BUART:pollcount_1\ | | HOLD | 0.000
Clock | | | | | Skew | 0.000
Rx_1(0)/fb | \UART_1:BUART:pollcount_0\/main_2 | 7.460

Type | Location | Fanout | Instance/Net | Source | Dest | Delay (ns)
iocell4 | P12[6] | 1 | Rx_1(0) | Rx_1(0)/in_clock | Rx_1(0)/fb | 2.009
Route | | 1 | Net_117 | Rx_1(0)/fb | \UART_1:BUART:pollcount_0\/main_2 | 5.451
macrocell42 | U(0,0) | 1 | \UART_1:BUART:pollcount_0\ | | HOLD | 0.000
Clock | | | | | Skew | 0.000
Rx_1(0)/fb | \UART_1:BUART:rx_last\/main_0 | 7.460

Type | Location | Fanout | Instance/Net | Source | Dest | Delay (ns)
iocell4 | P12[6] | 1 | Rx_1(0) | Rx_1(0)/in_clock | Rx_1(0)/fb | 2.009
Route | | 1 | Net_117 | Rx_1(0)/fb | \UART_1:BUART:rx_last\/main_0 | 5.451
macrocell44 | U(0,0) | 1 | \UART_1:BUART:rx_last\ | | HOLD | 0.000
Clock | | | | | Skew | 0.000
Rx_1(0)/fb | \UART_1:BUART:rx_state_2\/main_8 | 7.491

Type | Location | Fanout | Instance/Net | Source | Dest | Delay (ns)
iocell4 | P12[6] | 1 | Rx_1(0) | Rx_1(0)/in_clock | Rx_1(0)/fb | 2.009
Route | | 1 | Net_117 | Rx_1(0)/fb | \UART_1:BUART:rx_state_2\/main_8 | 5.482
macrocell38 | U(0,0) | 1 | \UART_1:BUART:rx_state_2\ | | HOLD | 0.000
Clock | | | | | Skew | 0.000
Rx_1(0)/fb | \UART_1:BUART:rx_state_0\/main_9 | 8.224

Type | Location | Fanout | Instance/Net | Source | Dest | Delay (ns)
iocell4 | P12[6] | 1 | Rx_1(0) | Rx_1(0)/in_clock | Rx_1(0)/fb | 2.009
Route | | 1 | Net_117 | Rx_1(0)/fb | \UART_1:BUART:rx_state_0\/main_9 | 6.215
macrocell35 | U(0,1) | 1 | \UART_1:BUART:rx_state_0\ | | HOLD | 0.000
Clock | | | | | Skew | 0.000
Rx_1(0)/fb | \UART_1:BUART:rx_status_3\/main_6 | 8.224

Type | Location | Fanout | Instance/Net | Source | Dest | Delay (ns)
iocell4 | P12[6] | 1 | Rx_1(0) | Rx_1(0)/in_clock | Rx_1(0)/fb | 2.009
Route | | 1 | Net_117 | Rx_1(0)/fb | \UART_1:BUART:rx_status_3\/main_6 | 6.215
macrocell43 | U(0,1) | 1 | \UART_1:BUART:rx_status_3\ | | HOLD | 0.000
Clock | | | | | Skew | 0.000
Rx_1(0)/fb | \UART_1:BUART:sRX:RxShifter:u0\/route_si | 13.037

Type | Location | Fanout | Instance/Net | Source | Dest | Delay (ns)
iocell4 | P12[6] | 1 | Rx_1(0) | Rx_1(0)/in_clock | Rx_1(0)/fb | 2.009
Route | | 1 | Net_117 | Rx_1(0)/fb | \UART_1:BUART:rx_postpoll\/main_1 | 5.451
macrocell9 | U(0,0) | 1 | \UART_1:BUART:rx_postpoll\ | \UART_1:BUART:rx_postpoll\/main_1 | \UART_1:BUART:rx_postpoll\/q | 3.350
Route | | 1 | \UART_1:BUART:rx_postpoll\ | \UART_1:BUART:rx_postpoll\/q | \UART_1:BUART:sRX:RxShifter:u0\/route_si | 2.227
datapathcell6 | U(0,0) | 1 | \UART_1:BUART:sRX:RxShifter:u0\ | | HOLD | 0.000
Clock | | | | | Skew | 0.000

+ Source Clock : UART_1_IntClock : Positive edge

+ Destination Clock : UART_1_IntClock : Positive edge

Source | Destination | Slack (ns) | Violation
\UART_1:BUART:rx_status_3\/q | \UART_1:BUART:sRX:RxSts\/status_3 | 2.123

Type | Location | Fanout | Instance/Net | Source | Dest | Delay (ns)
macrocell43 | U(0,1) | 1 | \UART_1:BUART:rx_status_3\ | \UART_1:BUART:rx_status_3\/clock_0 | \UART_1:BUART:rx_status_3\/q | 1.250
Route | | 1 | \UART_1:BUART:rx_status_3\ | \UART_1:BUART:rx_status_3\/q | \UART_1:BUART:sRX:RxSts\/status_3 | 2.873
statusicell5 | U(0,0) | 1 | \UART_1:BUART:sRX:RxSts\ | | HOLD | -2.000
Clock | | | | | Skew | 0.000
\UART_1:BUART:sTX:sCLOCK:TxBitClkGen\/ce1_reg | \UART_1:BUART:tx_state_2\/main_4 | 2.518

Type | Location | Fanout | Instance/Net | Source | Dest | Delay (ns)
datapathcell5 | U(0,2) | 1 | \UART_1:BUART:sTX:sCLOCK:TxBitClkGen\ | \UART_1:BUART:sTX:sCLOCK:TxBitClkGen\/clock | \UART_1:BUART:sTX:sCLOCK:TxBitClkGen\/ce1_reg | 0.190
Route | | 1 | \UART_1:BUART:tx_counter_dp\ | \UART_1:BUART:sTX:sCLOCK:TxBitClkGen\/ce1_reg | \UART_1:BUART:tx_state_2\/main_4 | 2.328
macrocell32 | U(0,2) | 1 | \UART_1:BUART:tx_state_2\ | | HOLD | 0.000
Clock | | | | | Skew | 0.000
\UART_1:BUART:sRX:RxBitCounter\/count_4 | \UART_1:BUART:rx_state_0\/main_7 | 2.931

Type | Location | Fanout | Instance/Net | Source | Dest | Delay (ns)
count7cell | U(0,1) | 1 | \UART_1:BUART:sRX:RxBitCounter\ | \UART_1:BUART:sRX:RxBitCounter\/clock | \UART_1:BUART:sRX:RxBitCounter\/count_4 | 0.620
Route | | 1 | \UART_1:BUART:rx_count_4\ | \UART_1:BUART:sRX:RxBitCounter\/count_4 | \UART_1:BUART:rx_state_0\/main_7 | 2.311
macrocell35 | U(0,1) | 1 | \UART_1:BUART:rx_state_0\ | | HOLD | 0.000
Clock | | | | | Skew | 0.000
\UART_1:BUART:sRX:RxBitCounter\/count_2 | \UART_1:BUART:rx_bitclk_enable\/main_0 | 2.940

Type | Location | Fanout | Instance/Net | Source | Dest | Delay (ns)
count7cell | U(0,1) | 1 | \UART_1:BUART:sRX:RxBitCounter\ | \UART_1:BUART:sRX:RxBitCounter\/clock | \UART_1:BUART:sRX:RxBitCounter\/count_2 | 0.620
Route | | 1 | \UART_1:BUART:rx_count_2\ | \UART_1:BUART:sRX:RxBitCounter\/count_2 | \UART_1:BUART:rx_bitclk_enable\/main_0 | 2.320
macrocell39 | U(0,1) | 1 | \UART_1:BUART:rx_bitclk_enable\ | | HOLD | 0.000
Clock | | | | | Skew | 0.000
\UART_1:BUART:sRX:RxBitCounter\/count_1 | \UART_1:BUART:rx_bitclk_enable\/main_1 | 2.941

Type | Location | Fanout | Instance/Net | Source | Dest | Delay (ns)
count7cell | U(0,1) | 1 | \UART_1:BUART:sRX:RxBitCounter\ | \UART_1:BUART:sRX:RxBitCounter\/clock | \UART_1:BUART:sRX:RxBitCounter\/count_1 | 0.620
Route | | 1 | \UART_1:BUART:rx_count_1\ | \UART_1:BUART:sRX:RxBitCounter\/count_1 | \UART_1:BUART:rx_bitclk_enable\/main_1 | 2.321
macrocell39 | U(0,1) | 1 | \UART_1:BUART:rx_bitclk_enable\ | | HOLD | 0.000
Clock | | | | | Skew | 0.000
\UART_1:BUART:sRX:RxBitCounter\/count_0 | \UART_1:BUART:rx_bitclk_enable\/main_2 | 2.957

Type | Location | Fanout | Instance/Net | Source | Dest | Delay (ns)
count7cell | U(0,1) | 1 | \UART_1:BUART:sRX:RxBitCounter\ | \UART_1:BUART:sRX:RxBitCounter\/clock | \UART_1:BUART:sRX:RxBitCounter\/count_0 | 0.620
Route | | 1 | \UART_1:BUART:rx_count_0\ | \UART_1:BUART:sRX:RxBitCounter\/count_0 | \UART_1:BUART:rx_bitclk_enable\/main_2 | 2.337
macrocell39 | U(0,1) | 1 | \UART_1:BUART:rx_bitclk_enable\ | | HOLD | 0.000
Clock | | | | | Skew | 0.000
\UART_1:BUART:sRX:RxBitCounter\/count_6 | \UART_1:BUART:rx_state_0\/main_5 | 3.244

Type | Location | Fanout | Instance/Net | Source | Dest | Delay (ns)
count7cell | U(0,1) | 1 | \UART_1:BUART:sRX:RxBitCounter\ | \UART_1:BUART:sRX:RxBitCounter\/clock | \UART_1:BUART:sRX:RxBitCounter\/count_6 | 0.620
Route | | 1 | \UART_1:BUART:rx_count_6\ | \UART_1:BUART:sRX:RxBitCounter\/count_6 | \UART_1:BUART:rx_state_0\/main_5 | 2.624
macrocell35 | U(0,1) | 1 | \UART_1:BUART:rx_state_0\ | | HOLD | 0.000
Clock | | | | | Skew | 0.000
\UART_1:BUART:sRX:RxBitCounter\/count_5 | \UART_1:BUART:rx_state_0\/main_6 | 3.248

Type | Location | Fanout | Instance/Net | Source | Dest | Delay (ns)
count7cell | U(0,1) | 1 | \UART_1:BUART:sRX:RxBitCounter\ | \UART_1:BUART:sRX:RxBitCounter\/clock | \UART_1:BUART:sRX:RxBitCounter\/count_5 | 0.620
Route | | 1 | \UART_1:BUART:rx_count_5\ | \UART_1:BUART:sRX:RxBitCounter\/count_5 | \UART_1:BUART:rx_state_0\/main_6 | 2.628
macrocell35 | U(0,1) | 1 | \UART_1:BUART:rx_state_0\ | | HOLD | 0.000
Clock | | | | | Skew | 0.000
\UART_1:BUART:sTX:sCLOCK:TxBitClkGen\/ce1_reg | \UART_1:BUART:txn\/main_5 | 3.391

Type | Location | Fanout | Instance/Net | Source | Dest | Delay (ns)
datapathcell5 | U(0,2) | 1 | \UART_1:BUART:sTX:sCLOCK:TxBitClkGen\ | \UART_1:BUART:sTX:sCLOCK:TxBitClkGen\/clock | \UART_1:BUART:sTX:sCLOCK:TxBitClkGen\/ce1_reg | 0.190
Route | | 1 | \UART_1:BUART:tx_counter_dp\ | \UART_1:BUART:sTX:sCLOCK:TxBitClkGen\/ce1_reg | \UART_1:BUART:txn\/main_5 | 3.201
macrocell29 | U(0,3) | 1 | \UART_1:BUART:txn\ | | HOLD | 0.000
Clock | | | | | Skew | 0.000
\UART_1:BUART:sTX:sCLOCK:TxBitClkGen\/ce1_reg | \UART_1:BUART:tx_state_1\/main_4 | 3.391

Type | Location | Fanout | Instance/Net | Source | Dest | Delay (ns)
datapathcell5 | U(0,2) | 1 | \UART_1:BUART:sTX:sCLOCK:TxBitClkGen\ | \UART_1:BUART:sTX:sCLOCK:TxBitClkGen\/clock | \UART_1:BUART:sTX:sCLOCK:TxBitClkGen\/ce1_reg | 0.190
Route | | 1 | \UART_1:BUART:tx_counter_dp\ | \UART_1:BUART:sTX:sCLOCK:TxBitClkGen\/ce1_reg | \UART_1:BUART:tx_state_1\/main_4 | 3.201
macrocell30 | U(0,3) | 1 | \UART_1:BUART:tx_state_1\ | | HOLD | 0.000
Clock | | | | | Skew | 0.000

+ Input To Clock Section

+ Clock_SPI

Source | Destination | Delay (ns)
Pin_miso(0)_PAD | \SPIM_led_control:BSPIM:sR8:Dp:u0\/route_si | 17.463

Type | Location | Fanout | Instance/Net | Source | Dest | Delay (ns)
Route | | 1 | Pin_miso(0)_PAD | Pin_miso(0)_PAD | Pin_miso(0)/pad_in | 0.000
iocell9 | P0[0] | 1 | Pin_miso(0) | Pin_miso(0)/pad_in | Pin_miso(0)/fb | 7.922
Route | | 1 | Net_1228 | Pin_miso(0)/fb | \SPIM_led_control:BSPIM:sR8:Dp:u0\/route_si | 6.041
datapathcell7 | U(1,4) | 1 | \SPIM_led_control:BSPIM:sR8:Dp:u0\ | | SETUP | 3.500
Clock | | | | | Clock path delay | 0.000

+ Clock To Output Section

+ Clock_PWM

Source | Destination | Delay (ns)
Net_29/q | Pin_RED(0)_PAD | 22.705

Type | Location | Fanout | Instance/Net | Source | Dest | Delay (ns)
macrocell20 | U(1,0) | 1 | Net_29 | Net_29/clock_0 | Net_29/q | 1.250
Route | | 1 | Net_29 | Net_29/q | Pin_RED(0)/pin_input | 5.777
iocell2 | P1[4] | 1 | Pin_RED(0) | Pin_RED(0)/pin_input | Pin_RED(0)/pad_out | 15.678
Route | | 1 | Pin_RED(0)_PAD | Pin_RED(0)/pad_out | Pin_RED(0)_PAD | 0.000
Clock | | | | | Clock path delay | 0.000
Net_785/q | Pin_GREEN(0)_PAD | 22.627

Type | Location | Fanout | Instance/Net | Source | Dest | Delay (ns)
macrocell28 | U(0,3) | 1 | Net_785 | Net_785/clock_0 | Net_785/q | 1.250
Route | | 1 | Net_785 | Net_785/q | Pin_GREEN(0)/pin_input | 6.035
iocell3 | P1[5] | 1 | Pin_GREEN(0) | Pin_GREEN(0)/pin_input | Pin_GREEN(0)/pad_out | 15.342
Route | | 1 | Pin_GREEN(0)_PAD | Pin_GREEN(0)/pad_out | Pin_GREEN(0)_PAD | 0.000
Clock | | | | | Clock path delay | 0.000
Net_813/q | Pin_BLUE(0)_PAD | 21.797

Type | Location | Fanout | Instance/Net | Source | Dest | Delay (ns)
macrocell24 | U(1,1) | 1 | Net_813 | Net_813/clock_0 | Net_813/q | 1.250
Route | | 1 | Net_813 | Net_813/q | Pin_BLUE(0)/pin_input | 5.476
iocell1 | P1[6] | 1 | Pin_BLUE(0) | Pin_BLUE(0)/pin_input | Pin_BLUE(0)/pad_out | 15.071
Route | | 1 | Pin_BLUE(0)_PAD | Pin_BLUE(0)/pad_out | Pin_BLUE(0)_PAD | 0.000
Clock | | | | | Clock path delay | 0.000

+ Clock_SPI

Source | Destination | Delay (ns)
Net_1225/q | Pin_mosi(0)_PAD | 23.709

Type | Location | Fanout | Instance/Net | Source | Dest | Delay (ns)
macrocell45 | U(1,4) | 1 | Net_1225 | Net_1225/clock_0 | Net_1225/q | 1.250
Route | | 1 | Net_1225 | Net_1225/q | Pin_mosi(0)/pin_input | 6.672
iocell6 | P2[2] | 1 | Pin_mosi(0) | Pin_mosi(0)/pin_input | Pin_mosi(0)/pad_out | 15.787
Route | | 1 | Pin_mosi(0)_PAD | Pin_mosi(0)/pad_out | Pin_mosi(0)_PAD | 0.000
Clock | | | | | Clock path delay | 0.000
Net_1226/q | Pin_sclk(0)_PAD | 22.702

Type | Location | Fanout | Instance/Net | Source | Dest | Delay (ns)
macrocell53 | U(0,4) | 1 | Net_1226 | Net_1226/clock_0 | Net_1226/q | 1.250
Route | | 1 | Net_1226 | Net_1226/q | Pin_sclk(0)/pin_input | 5.785
iocell7 | P2[0] | 1 | Pin_sclk(0) | Pin_sclk(0)/pin_input | Pin_sclk(0)/pad_out | 15.667
Route | | 1 | Pin_sclk(0)_PAD | Pin_sclk(0)/pad_out | Pin_sclk(0)_PAD | 0.000
Clock | | | | | Clock path delay | 0.000

+ UART_1_IntClock

Source | Destination | Delay (ns)
\UART_1:BUART:txn\/q | Tx_1(0)_PAD | 31.574

Type | Location | Fanout | Instance/Net | Source | Dest | Delay (ns)
macrocell29 | U(0,3) | 1 | \UART_1:BUART:txn\ | \UART_1:BUART:txn\/clock_0 | \UART_1:BUART:txn\/q | 1.250
Route | | 1 | \UART_1:BUART:txn\ | \UART_1:BUART:txn\/q | Net_112/main_0 | 3.415
macrocell4 | U(1,2) | 1 | Net_112 | Net_112/main_0 | Net_112/q | 3.350
Route | | 1 | Net_112 | Net_112/q | Tx_1(0)/pin_input | 6.592
iocell5 | P12[7] | 1 | Tx_1(0) | Tx_1(0)/pin_input | Tx_1(0)/pad_out | 16.967
Route | | 1 | Tx_1(0)_PAD | Tx_1(0)/pad_out | Tx_1(0)_PAD | 0.000
Clock | | | | | Clock path delay | 0.000
