prj3grp7/prj3_projekt_dokumentation/Arkitektur/Systembeskrivelse.pdf

# Systembeskrivelse

Martin Lundberg

October 2018

## 1 Systembeskrivelse

I dette projekt skal der laves et ”Beer pong” bord. Form˚alet med projekt er at tage det populære drukspil ”Beer pong”; som er en kombination af ordene: ”beer” og ”ping pong”. Og lave et bord som gør spillet: mere tilgængeligt, sjovere og mere moderne; Dette gøres ved at gøre spillet mere arkade ligende. For eksempel hvis man g˚ar ind i en arkade nu om dage, kan man normalt bare have nogle mønter/poletter med. S˚a kan man vælge at spille: airhockey, bordfodbold og s˚a videre.
Dette betyder at man ikke selv skal finde et bord, som normalt ikke er den rigtige størrelse. Man skal ikke selv have en ping pong bold med, eller finde en. Og siden det er et drukspil, s˚a har man sandsynligvis allerede øl og kopper selv. Systemet kommer til at best˚a følgende dele: Et bord; som best˚ar af plade, ben og kop omr˚ade i plade; sensorer, tre Psocs, en raspeberry Pi Zero, et display ,en bold-dispenser,betalings omr˚ade, og wifi forbindelse. Forbindelse mellem disse enheder kan ses p˚a figur 1.
Her skal bordet ses som et slags ”center” for det hele, da det er der spillet kommer til at foreg˚a: Alt det andet er bare baggrund for at styre maskineriet. Det ses ogs˚a at b˚ade bordet, boldene og betalingsomr˚adet er tilsluttet en sensor del. Dette er ikke fordi der kun er en sensor, men fordi de alle bruger et antal sensorer til at registrer deres funktions omr˚ader. For eksempel registre bordet n˚ar der løftes en kop, betalings omr˚adet registrere hvorn˚ar der er betalt osv. De sensorer fortæller s˚a til de psoc’s der bruges hvad der sker. Ud fra det sender de information til en raspberry pi, som styre information, hjemmeside og et display.

1

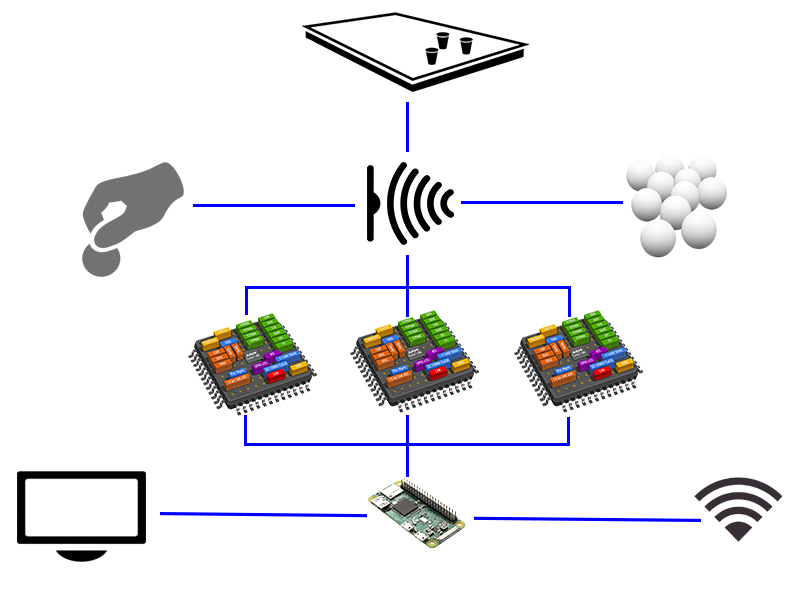
[picture p1: figure]

Figure 1: Systemet

2
