prj3grp7/prj3_projekt_dokumentation/Kravspecifikation/Definitionsliste.pdf

## 1 Definitionsliste

Definitionslisten er lavet som et ’look up’ værktøj, der kan bruges gennem hele rapporten, hvis man er i tvivl om hvad der menes med forskellige implicitte begreber.

Begreb | Definition
Start op | System rutine: Systemet går fra et slukket tilstand hvor displayskærm, lys og bolddispenser er slukket, til et tændt tilstand hvor nævnte moduler tænder. Det defineres, at systemet er færdig med sit start up rutine, når displayskærmen viser en "klar til spil"besked, og bolddispenserens grøn eller rød LED er tændt.
Slukke | System rutine: Systemet går fra et tændt tilstand hvor displayskærm, lys og bolddispenser er tændt, til et slukket tilstand hvor nævnte moduler slukker. Det defineres, at systemet er færdig med sit shutdown rutine, når displayskærmen er slukket og begge LED’er fra borddispenser er slukket
Spilstart | System-Bruger interaktion: Et nyt spil er startet, når både systemet og brugerne er klar til at interagere med hinanden. Det vil sige, et hold har skrevet deres navn ind via mobil telefon, betalt for bolde, stillet kopper på bordet og trykket på start knappen.
Spil status | System definition: Oplysninger om bordets tilstand. Dvs. hvor mange kopper der er tilbage og holdenes navn.
Spiller oplysninger | System definition: Oplysninger om spillerne og holdenes navne.
Score | System-Bruger interaktion: At kaste en bold og ramme i en af kopperne på bordet. At score medfører fjernelsen af den ramte kop. Det hold hvis kop blev ramt fjerner koppen.
Turen | Bruger definition: Et hold har retten til at kaste bolde når de er i besiddelse af to bolde, retten overdrages frem og tilbage mellem holdene ved at kaste de to bolde.

1

Aktiv Spiller | Bruger definition: Den spiller hvis hold har bolden og turen.
Modstander | Bruger definition: Den spiller hvis hold ikke har turen og som eventuelt skal drikke og fjerne sine kopper hvis de bliver ramt.
Spilslut | System-Bruger interaktion: Et spil er slut når et af holdene er tvunget til at fjerne deres sidste kop fra bordet.
UI | System definition: Alle de elementer fra systemet som benyttes til at kommunikere med brugeren; lys under og rundt om kopholderne, skærmdisplay på bordet, webpage og bolddispenserens LED’er.

2
