prj3grp7/prj3_projekt_dokumentation/Undervisningsmateriale/MSE EX 4 20161011 ver 5.pdf

E3-MSE

# Båndbredde i Op-Amp

# Øvelsesvejledning

Øvelsen er den fjerde i en serie på 6 øvelser, der når rundt om en række praktiske problemstillinger i anvendelsen af operationsforstærkere. Øvelsen har fokus på analyse, simulering og realisering af Båndbredde og stabilitet i forstærkerkredsløb med operationsforstærkere.

### Indhold

### Indledning

Denne øvelse har 3 hoveddele:

- Kredsløbsanalyse af båndbredde og stabilitet
- Simulering af båndbredde og stabilitet
- Realisering og måling

Resultaterne samles i Tabel 1 under resultater.

Evalueringen af øvelserne sker ved en mundtlig eksamen, hvor øvelserne udgør 6 spørgsmål suppleret med 6 teorispørgsmål. Ved de 6 teorispørgsmål vil dele af en relevant øvelse blive inddraget i evalueringen.

Vejledningen indeholder appendiks med eksempler på analyse, simulering og realisering for dele af øvelsens kredsløb. Det forudsættes at der er lavet tilsvarende analyse, simulering og realisering for øvelsens øvrige kredsløb.

### Kredsløb til øvelse 4

Øvelsen undersøger kredsløbene vist nedenfor. Hvert kredsløb analyseres, simuleres og realiseres.

- Kredsløb #1 og #2 undersøges for sammenhængen mellem forstærkning (gain) og båndbredde.
- Kredsløb #3 undersøges for stabilitet når belastningen CL på udgangen er kapacitiv.
- Kredsløb #4 undersøges for stabilitet når indgangsstrømkilden har en parasitkapacitet Cp og kondensator Cf i tilbagekoblingen anvendes til stabilisering af kredsløbet.

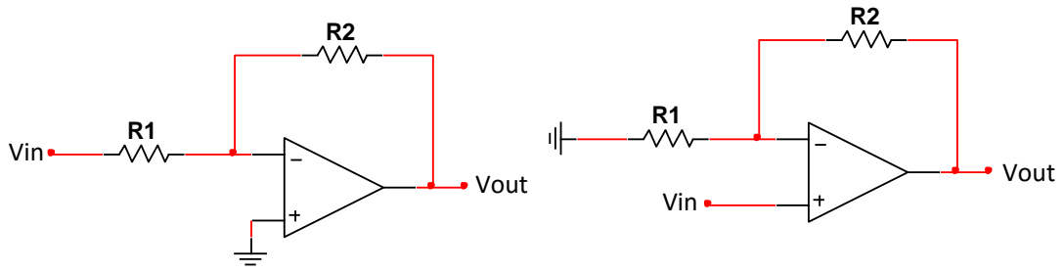
[picture p3: figure]
Vout; Vin

Figur 1 Kredsløb #1 Inverterende forstærker | Figur 2 Kredsløb #2 Non-inverterende forstærker

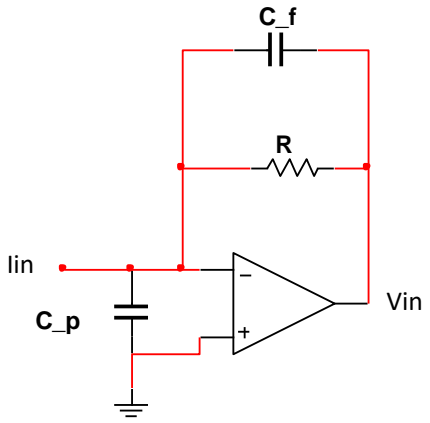
[picture p4: figure]
Vin; Iin

I analysen anvendes en approksimation AOL_apprx for open loop gain AOL.. Det letter overblikket over analyseresultaterne uden at påvirke konklusionerne. Forskellen mellem de to vises i Figur 5.

I simuleringen anvendes AOL der giver grundlag for en vurdering af analysens approksimation.

AOL

A
s

ωG

A

+ 1

AOL_apprx

1

s

ωG

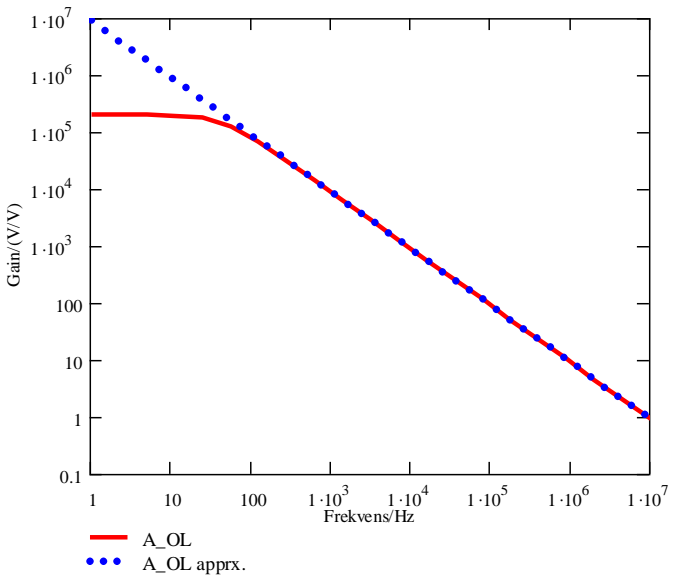
[picture p5: figure]
A_OL A_OL apprx.; Frekvens/Hz; Gain/(V/V)

Figur 5 A_OL og A_OL_apprx

Her er ωG vinkelfrekvensen ved en forstærkning på 1 og den kan beregnes ud fra databladets oplysning af operationsforstærkerens unity-gain frequency, der også kaldes gain-bandwidth product (GBP), som:

ωG = 2πGBP

Vout

Vin

Figur 3 Kredsløb #3 spændingsfølger | Figur 4 Kredsløb #4 Transimpedansforstærker

C_L

### Analyse

Kredsløbene #1 - #4 analyseres som vist i eksemplet i appendiks A, B og C.

- I analysen antages det at GBP = 9 MHz svarende til ωG = 2∙π∙9*10⁶ Hz.

Appendiks A behandler sammenhængen mellem forstærkning og båndbredde i kredsløb #1 og #2.

Der skal findes en sammenhæng mellem forstærkerens 3 dB båndbredde fc og unity-gain fG (eller 3 dB vinkelfrekvens ωC og unity-gain vinkelfrekvens ωG). I kredsløb #1 er forstærkningen (gain) indstillet til -49. Det forventes at der udføres en tilsvarende analyse for kredsløb #2 hvor forstærkningen er 50 og at resultatet sammenlignes med kredsløb #1.

Appendiks B behandler stabilitet i spændingsfølgeren kredsløb #3 med kapacitiv belastning af udgangen med CL. I analysen beskrives AOL som vist Figur 5. Operationsforstærkerens indre modstand i udgangen kaldes RO og den maksimalt tilladelige belastningskapacitet CL findes i forhold til den valgte fG. Grænsen for stabilitet defineres her som kritisk dæmpning.

Appendiks C behandler stabilitet i transimpedansforstærkeren kredsløb #4 når indgangsstrømkilden har en parallelkapacitet. Stabiliteten sikres ved en feedback kondensator mellem udgangen og den negative indgang på operationsforstærkeren. I analysen findes den største kapacitetsværdi for CP hvor kredsløbet er stabilt. Kredsløbets feedback modstand er R = 1 MΩ og feedback kondensator Cf = 4.6 pF. Grænsen for stabilitet defineres her som kritisk dæmpning.

Beregningerne fra analysen medtages i øvelsesjournalen i Tabel 1

Forklar i journalen hvordan Ligningerne i appendiks A, B og C fremkommer og kommenter på hvordan fG og RO påvirker resultatet.

### Simulering

Kredsløbene #1 - #4 simuleres og resultaterne fra analysen efterprøves. 3 dB båndbredden fc kan valgfrit findes ved frekvens sweep eller transient respons.

- I kredsløb #1 og 2 er R1 = 10 kΩ og R2 = 490 kΩ.
- I kredsløb #4 er R1 = 1 MΩ og Cf = 4.6 pF.
- I simuleringen antages det at GBP = 9 MHz så ωG = 2∙π∙9 MHz. Forstærkningen er A = 200 kV/V.

Appendiks D viser et eksempel på simuleringen af kredsløb #1.

Appendiks E viser et eksempel på simulering af kredsløb #4.

Udskrifter af grafer fra simuleringen medtages i journalen og resultaterne vises i Tabel 1.

Ved kredsløb #3 og #4 findes kondensatorværdier hvor kredsløbet er kritisk dæmpet. Der simuleres også med kondensatorværdier der er 10 gange større for at vise at kredsløbet bliver underdæmpet.

### Realisering

Kredsløbene #1 - #4 fra analyse og simulering realiseres ved de uploadede filer til Campus. PSOC realiseringen af kredsløb #4 er vist i appendiks F.

For kredsløb #1 og #2 bestemmes 3 dB båndbredden fC. Ud fra de målte fC ved effektniveauet HIGHPOWER bestemmes unity gain båndbredde GBP frekvensen (vinkelfrekvensen ωG). Der er ikke en fil for kredsløb #2, så den inverterende forstærker fjernes fra #1 og der indsætte i dens sted en ikke-inverterende PGA.

Kredsløb #2 undersøges med tre forskellige effektniveauer: LOWPOWER, MEDPOWER og HIGHPOWER. Den fundne værdier af GBP (eller ωG) anvendes ved beregning af CL for kredsløb #3 og Cp for kredsløb #4. Ved kredsløb #3 og #4 måles også med kondensatorværdier der er 10 gange større end de fundne værdier for at vise at kredsløbet bliver underdæmpet.

Alle målinger skal laves som eksterne målinger med signalgenerator og oscilloskop.

Resultaterne indføres i Tabel 1 og suppleres af udskrifter fra oscilloskopet (USB, foto eller håndskitse).

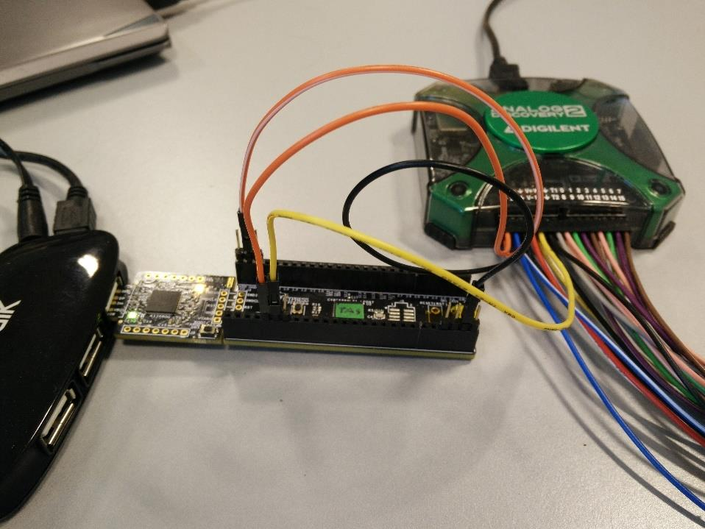
[picture p6: figure]

Øvelsen er et eksempel på hvordan operationsforstærkeren kan analyseres og måles. Det er vigtigt at bemærke vanskelighederne når indgang eller udgang er kapacitivt belastet og hvordan disse problemer kan løses. Det beskriver de arbejdsforhold som en operationsforstærker vil møde i praksis.

Forstærkerne i PSOC rummer foruden variabel feedback kondensator også variabel Miller kompensering. I standardopsætningerne er valgt fornuftige Miller kompenseringer og det ligger ud over rammerne for dette kursus at ændre på disse. Særligt interesserede henvises til Technical Reference Manual kapitel 30.

Der opfordres til at eksperimentere med de viste kredsløb og medtag gerne billeder fra oscilloskop eller mobiltelefonens kamera som uddybende dokumentation.

### Resultater

Kredsløb | Analyse | Simulering | Realisering | Kommentar
1 | 3 dB BW, fC | | 3 dB BW, fC | GBP
| | High Power
2 | 3 dB BW, fC | | 3 dB BW, fC | GBP
| | Low Power
| | Medium Power
| | High Power
3 | CL | CL | 10∙CL | High Power | CL | 10∙CL

4

CP | CP | 10 CP
High Power
CP | 10∙CP

Tabel 1 Sammenligning af resultater

Realiseringsmålingerne skal suppleres med udskrift fra oscilloskop (USB, foto eller håndskitse).

### Konklusion

### Appendiks A

Analyse af kredsløb #1. Operationsforstærkerens indre modstand i udgangen kaldes RO.

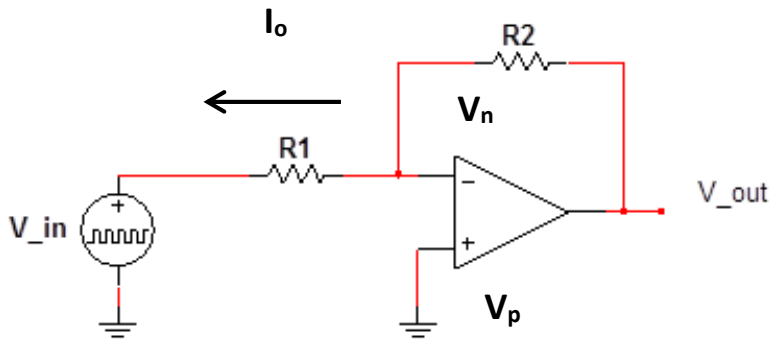
[picture p7: figure]

Figur 6 Analyse af kredsløb #1

Følgende ligninger kan opstilles fra Figur 6:

Løses ligningerne fås (vis at det er korrekt):

Vo

Vin -

R2

ωG

- Ro
- ·s

R2

R1

+ | Ro ( | + | )·s | ωG
R1

+ ·

·

Vi antager at Ro = 0 Ω er rimelig for analysen (begrund dette) og får:

Vo

R2

ωG

R2

R1 ( + | )·s | ωG
R1

+ ·

- Vin ·

Vo

AOL Vp

Vn

·( - ) Ro
I
o
- ·

Vo

I
o

R2

- Vn

+

Vn

I
o

R1

- Vin +

Vp

0

AOL

1

s

ωG

Io

Nu kan sammenhængen mellem 3 dB båndbredde fC og unity gain båndbredde GBP eller ωG = 2π GBP findes (hvordan?):

ωc

R1

R1

R2

+

ωG

·

Kredsløbets parametre indsættes i løsningen og fC (eller ωC) findes:

Dette resultat indføres i Tabel 1

ωG

2·π·9 106
:= | · | R1
:= 10kΩ | R2
:= 490kΩ

### Appendiks B

Analyse af kredsløb #3 hvor operationsforstærkeren er belastet kapacitivt på udgangen med CL og den indre modstand i operationsforstærkeren kaldes RO. Derved indskydes en pol i tilbagekoblingen som kan påvirke operationsforstærkerens stabilitet.

Figur 7 Analyse af kredsløb #3

Følgende ligninger kan opstilles fra Figur 6:

Løses ligningerne fås (vis at det er korrekt):

Vo

ωG

Ro

CL

- s

2
- | + s | ωG

+

Vin ·

Dette er en 2. ordens overføringsfunktion og betingelsen for kritisk dæmpning kan beregnes. Lav beregningen og vis at kredsløbet er kritisk dæmpet når CL er:

CL

1
4 Ro

ωG

- ·

Beregn CL når Kredsløbets parametre er:

Resultatet indføres i Tabel 1

Vo

AOL Vp

Vn

·( - ) I o
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
s CL

·

·

Vin | Vp
AOL | ωG

s

ωG

:= 2·π·9·MHz Ro

:= 10Ω

C_L

V_in

Io
Vp

Vn

### Appendiks C

Analyse af kredsløb #4, hvor operationsforstærkeren er belastet kapacitivt med CP på indgangen. Den vil indskyde en pol i tilbagekoblingen ved komponenterne R og CP.

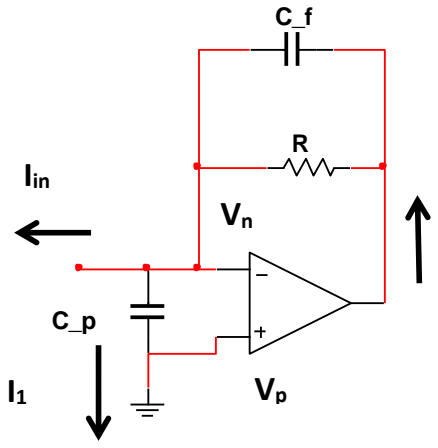
[picture p8: figure]
Iin

Figur 8 Analyse af kredsløb #4

Følgende ligninger kan opstilles fra Figur 6:

Vo

I
o

1
R

1

1

s Cf

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
- Vn

+

Ro er udgangsmodstanden af operationsforstærkeren.

Vo

AOL Vp

Vn

·( - ) I o
Ro
- ·

Vn

I
1

1
s Cp

·

- Vp

+

Vp

0

I

in | I
| 1
+ | I o
AOL | ωG

s

Io

Løses ligningerne fås (vis at det er korrekt):

Vo

Cf

·R Ro

- s

2
- Ro
- | ·s | R ωG + ·

Cf

·R Ro

- Cp
- s

3
- R Cp
- Ro

Cp

+ | · | Cf ( | + | ·R) s

2
+ | · | ωG

Cf

+ ( · ·R + 1)·s ωG
+

I

in ·

Dette er en 3. ordens overføringsfunktion der er vanskelig at analysere. Vi kan igen uden tab af det væsentlige sætte Ro = 0 Ω (begrund dette) og nu fås løsningen:

Vo

R

ωG

Cf

Cp ( + )·R s

2
- ωG

Cf

+ ( · ·R + 1)·s ωG
+
- I

in ·

Dette er en 2. ordens overføringsfunktion og betingelsen for kritisk dæmpning kan beregnes. Lav beregningen og vis at kredsløbet er kritisk dæmpet når Cp er:

Cp

1
4 ωG
- ·R

1
2

1

1
2

ωG

- ·R Cf
- ·

æ
ç
è

ö
÷
ø
- Cf
- ·

Beregn Cp når Kredsløbets parametre er:

Resultatet indføres i Tabel 1

ωG

:= 2·π·9MHz | R | 106
:= | Ω | Cf
:= 4.6pF

### Appendiks D

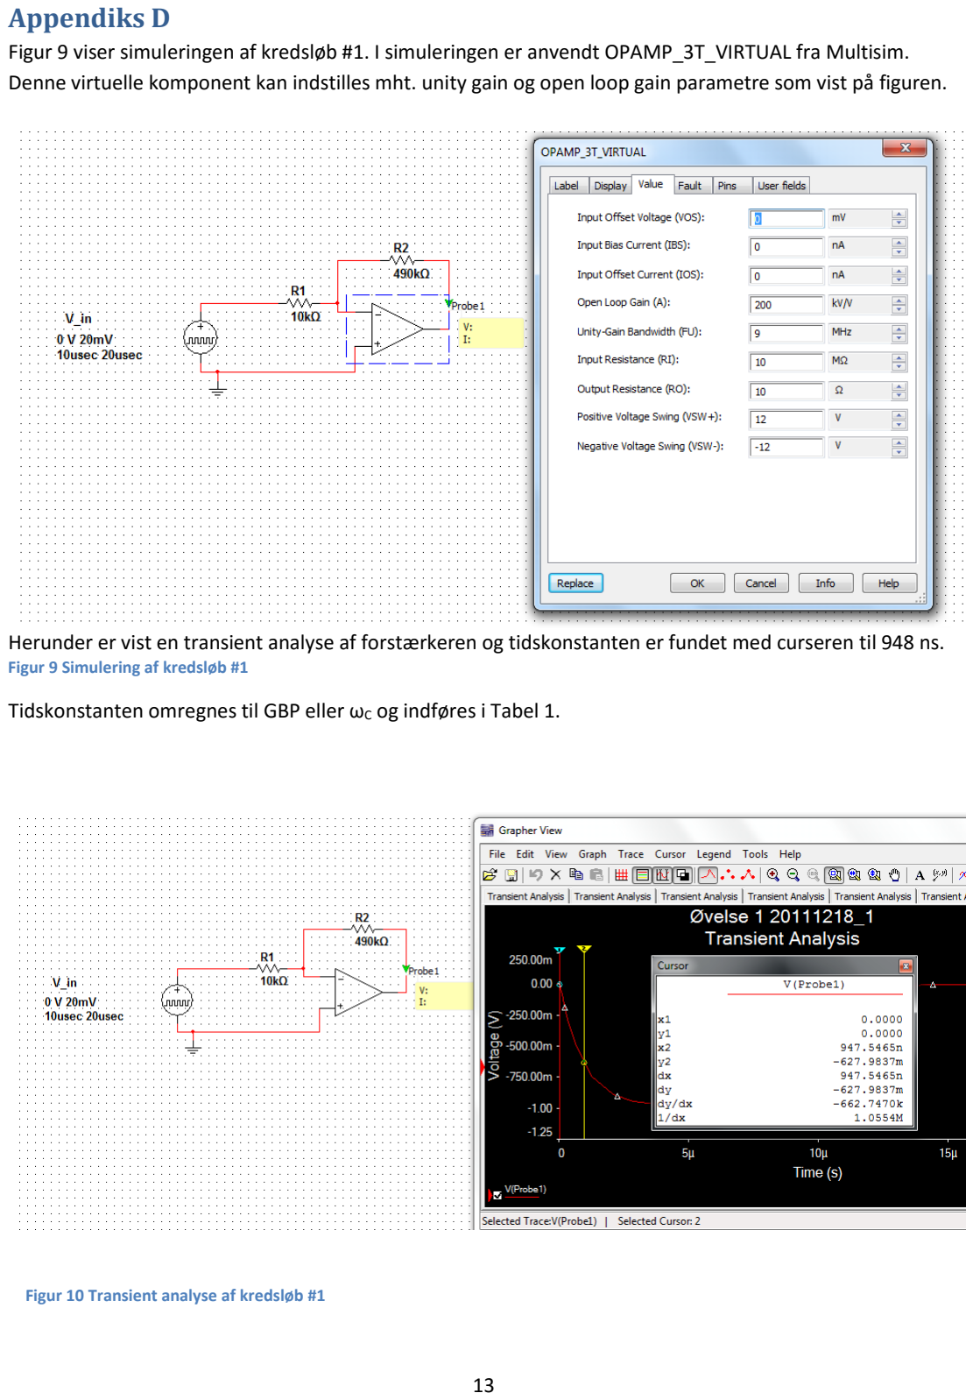
[picture p9: page 14]

Figur 9 viser simuleringen af kredsløb #1. I simuleringen er anvendt OPAMP_3T_VIRTUAL fra Multisim. Denne virtuelle komponent kan indstilles mht. unity gain og open loop gain parametre som vist på figuren.

Herunder er vist en transient analyse af forstærkeren og tidskonstanten er fundet med curseren til 948 ns.

Tidskonstanten omregnes til GBP eller ωC og indføres i Tabel 1.

Figur 9 Simulering af kredsløb #1

Figur 10 Transient analyse af kredsløb #1

### Appendiks E

Figur 11 viser simuleringen af kredsløb #4. I simuleringen er anvendt OPAMP_3T_VIRTUAL fra Multisim. Strømkilden til forstærkeren er erstattet med en Thevenin generator. Den skal også anvendes ved målingerne.

Ved simulering: V_T = -1 V og R_T = 1MΩ.

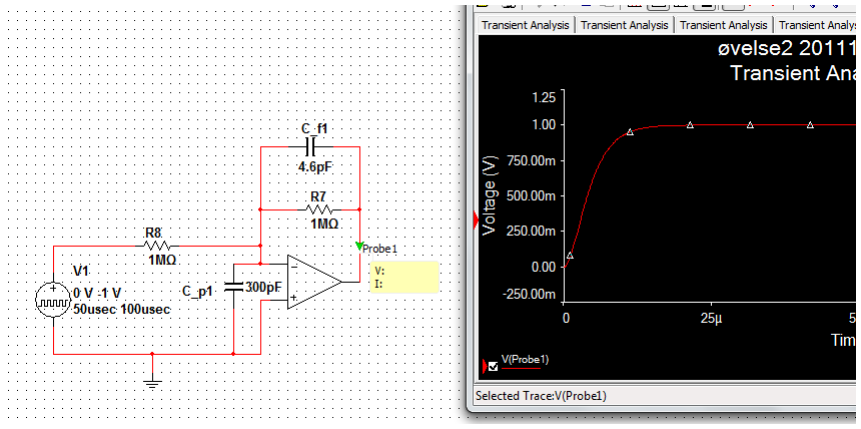
[picture p10: figure]

Figur 11 Simulering af kredsløb #4

### Appendiks F

Figuren herunder viser realisering af kredsløb #4 implementeret på PSOC. Transientrespons måles med signalgenerator på indgang I_in på P1[2] og oscilloskop på udgangen V_out på P0[0]. Strømgeneratoren erstattes med en Thevenin generator med V_T = 2,5 V og R_T = 1 MΩ som vist herunder. For at indkoble feedback-kondensatoren dobbelt-klikkes på TIA symbolet og menuen rettes til 4,6 pF. Der opfordres til at ændre på ”Power” indstillingen eller ”Resistive_Feedback” for at studere resultatet af ændringen.

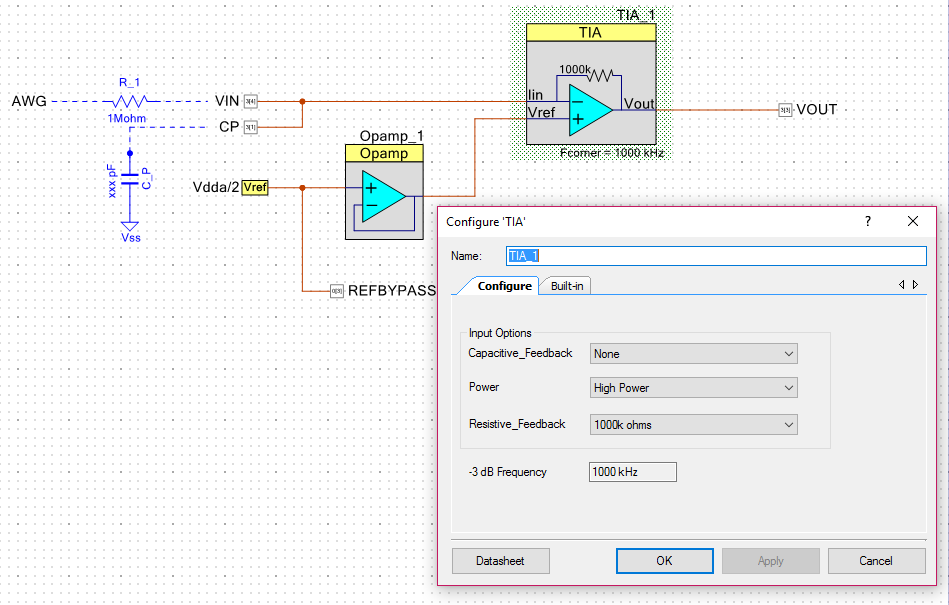
[picture p11: figure]

Opamp_1 er inkluderet som buffer af den interne reference på halvdelen af effektforsyningen. Det er nødvendigt ved kredsløb #2 og er inkluderet for alle kredsløb som et eksempel på god designpraksis.
