prj3grp7/prj3_projekt_dokumentation/Arkitektur/Sekvensdiagrammer/sd_UC2.png

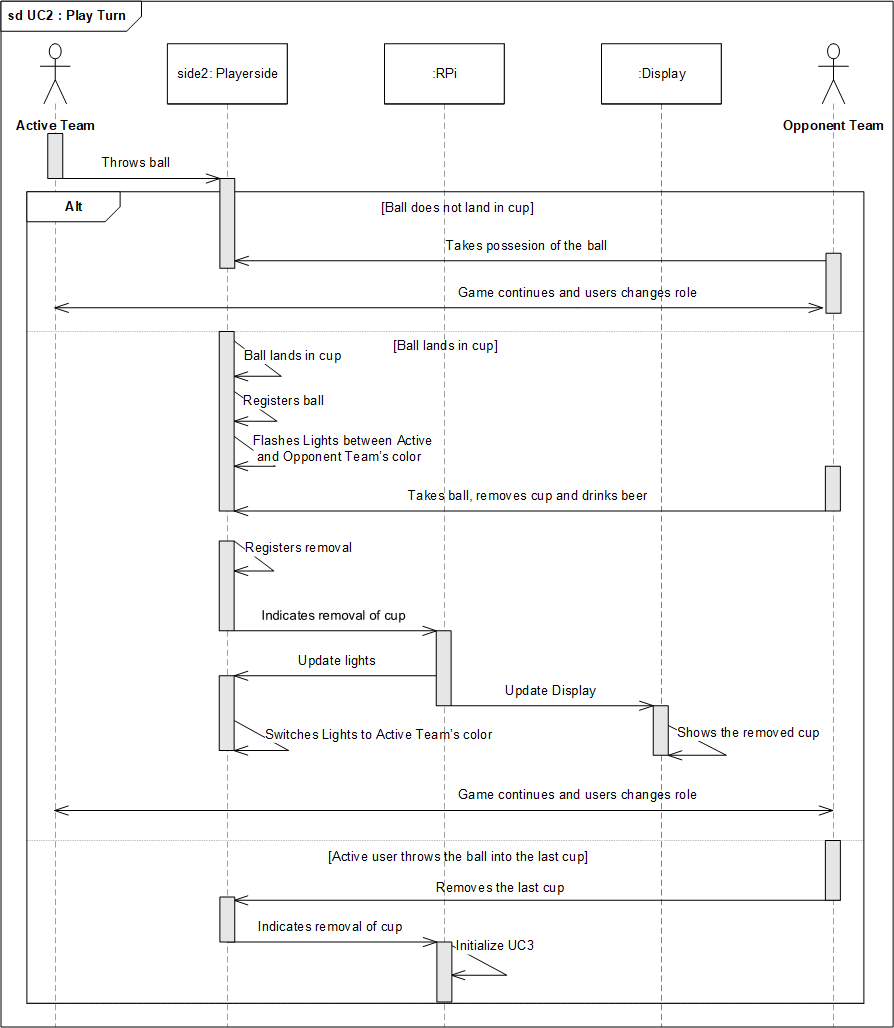
Arkitektur/Sekvensdiagrammer/sd_UC2.png
