prj3grp7/prj3_projekt_dokumentation/Arkitektur/Skitser af systemet/Vinkel2eng.png

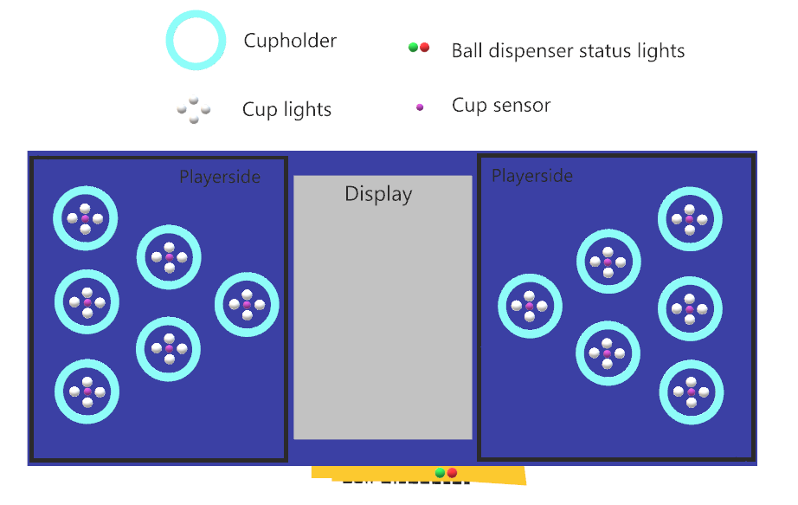
Arkitektur/Skitser af systemet/Vinkel2eng.png
