prj3grp7/prj3_projekt_dokumentation/Arkitektur/SM System.png

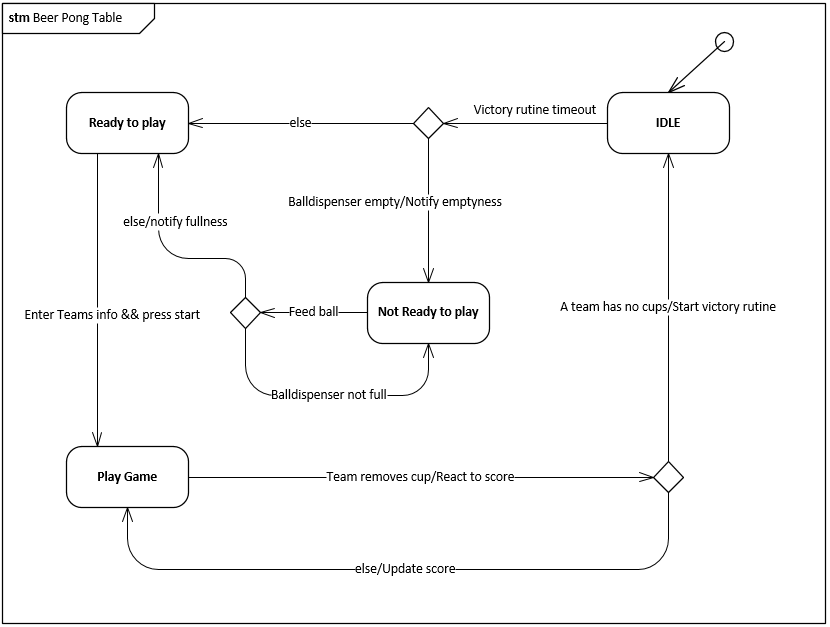
Arkitektur/SM System.png
