prj3grp7/prj3_projekt_dokumentation/Arkitektur/Softwarearkitektur/BallDispenser/Applikationsmodel Bolddispenser seq uc4.png

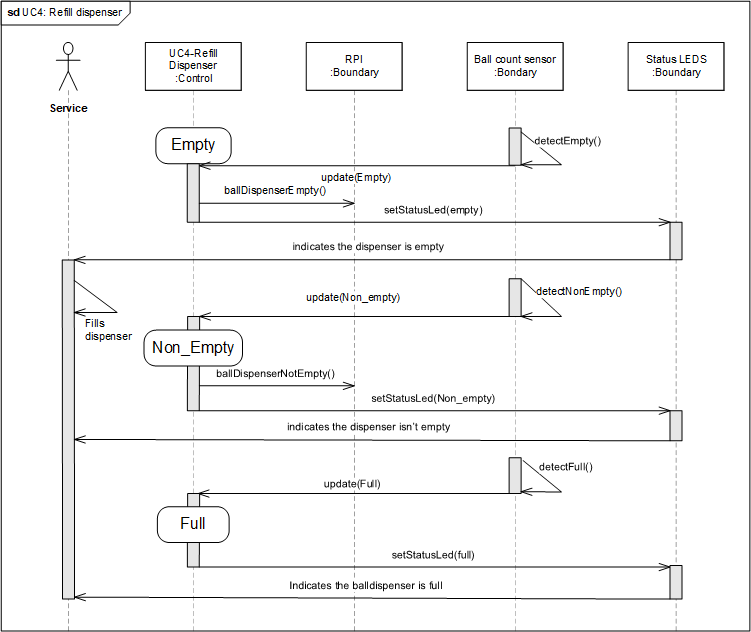
Arkitektur/Softwarearkitektur/BallDispenser/Applikationsmodel Bolddispenser seq uc4.png
