prj3grp7/prj3_projekt_dokumentation/Arkitektur/Softwarearkitektur/BallDispenser/Applikationsmodel Bolddispenser stm.png

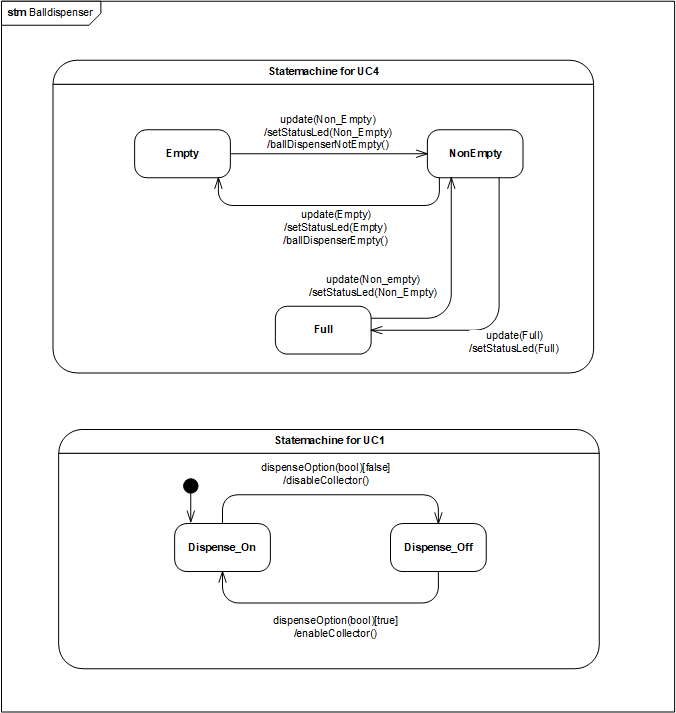
Arkitektur/Softwarearkitektur/BallDispenser/Applikationsmodel Bolddispenser stm.png
