prj3grp7/prj3_projekt_dokumentation/Arkitektur/Softwarearkitektur/domain beer pong.png

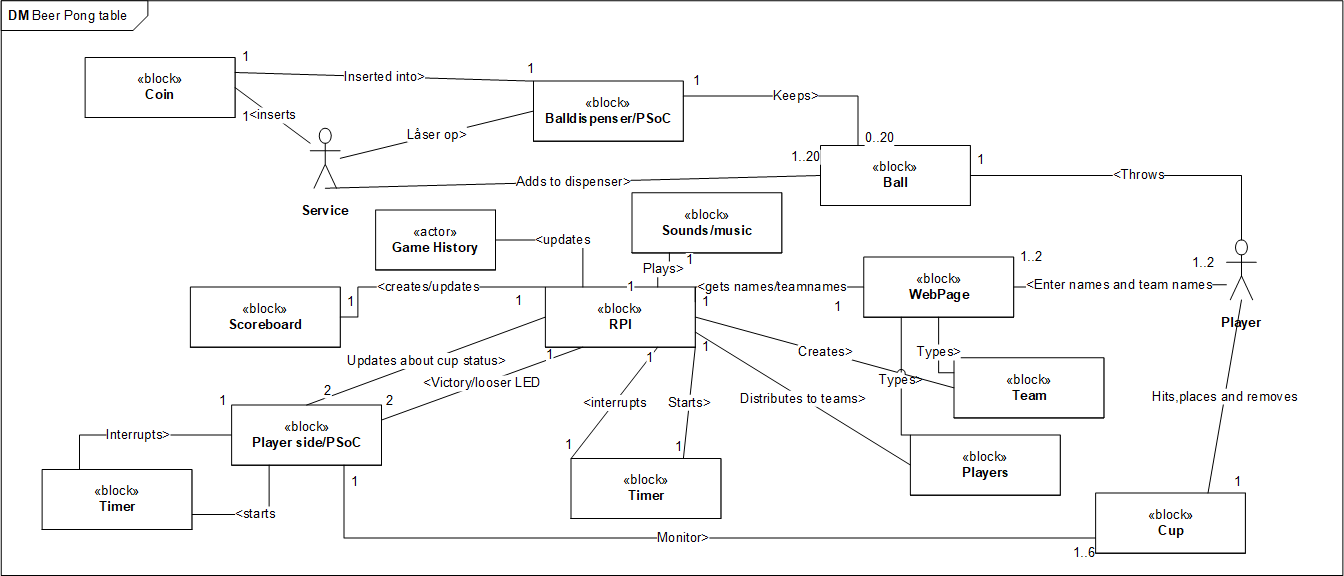
Arkitektur/Softwarearkitektur/domain beer pong.png
