prj3grp7/prj3_projekt_dokumentation/Arkitektur/Softwarearkitektur/PlayerSide/classDiagram.png

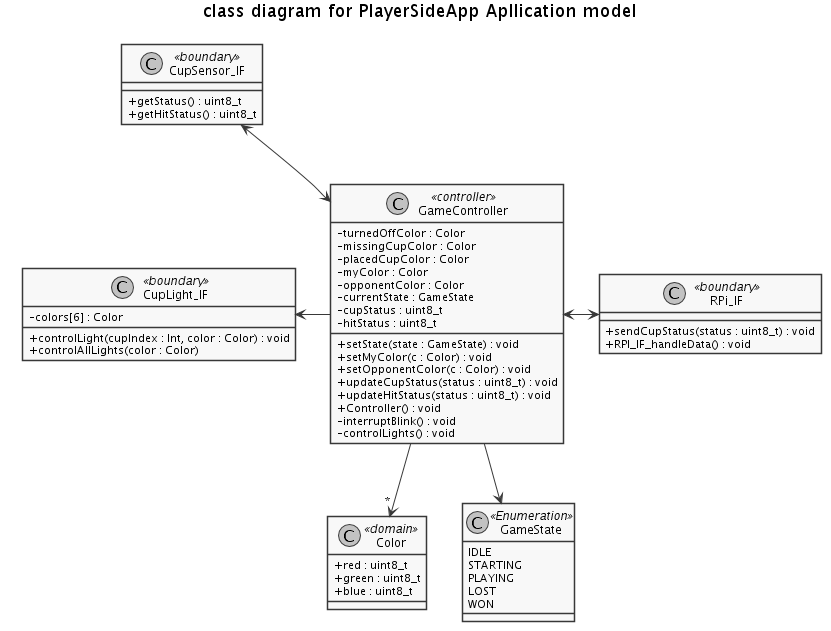
Arkitektur/Softwarearkitektur/PlayerSide/classDiagram.png
