prj3grp7/prj3_projekt_dokumentation/Arkitektur/Softwarearkitektur/PlayerSide/controlLights_sequence.png

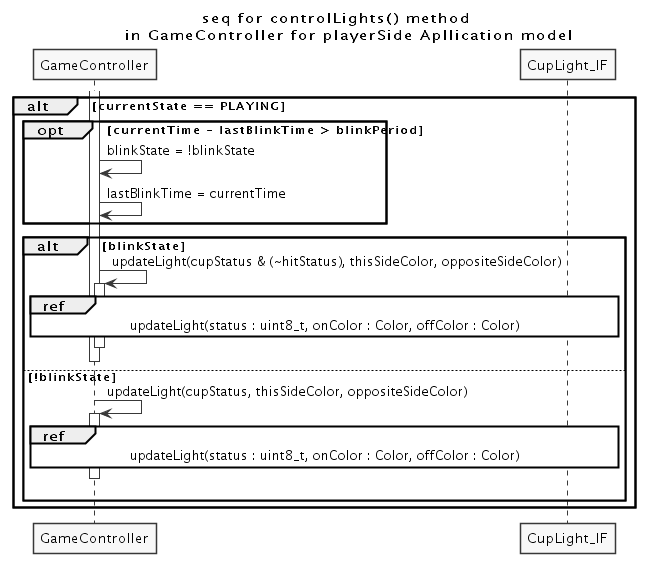
Arkitektur/Softwarearkitektur/PlayerSide/controlLights_sequence.png
