prj3grp7/prj3_projekt_dokumentation/Arkitektur/Softwarearkitektur/PlayerSide/state.png

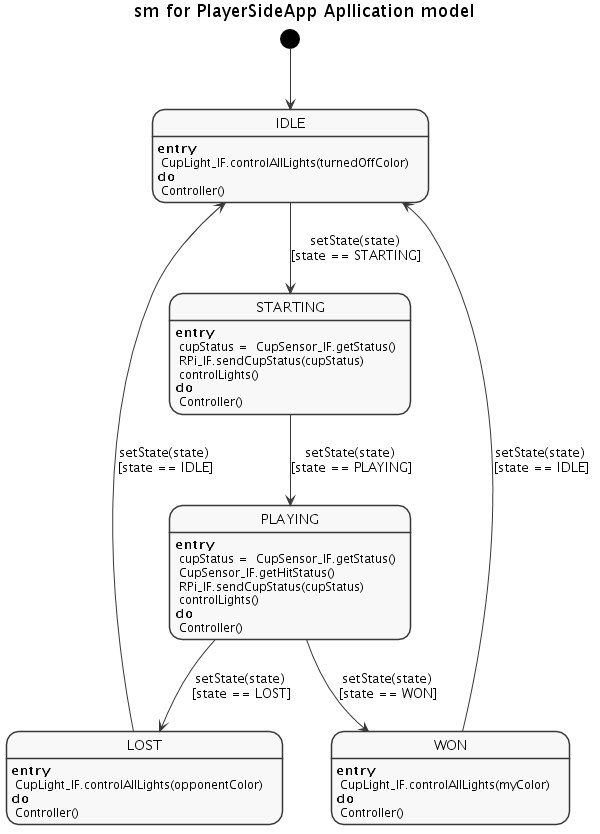
Arkitektur/Softwarearkitektur/PlayerSide/state.png
