prj3grp7/prj3_projekt_dokumentation/Arkitektur/Softwarearkitektur/PlayerSide/UC1_sequence.png

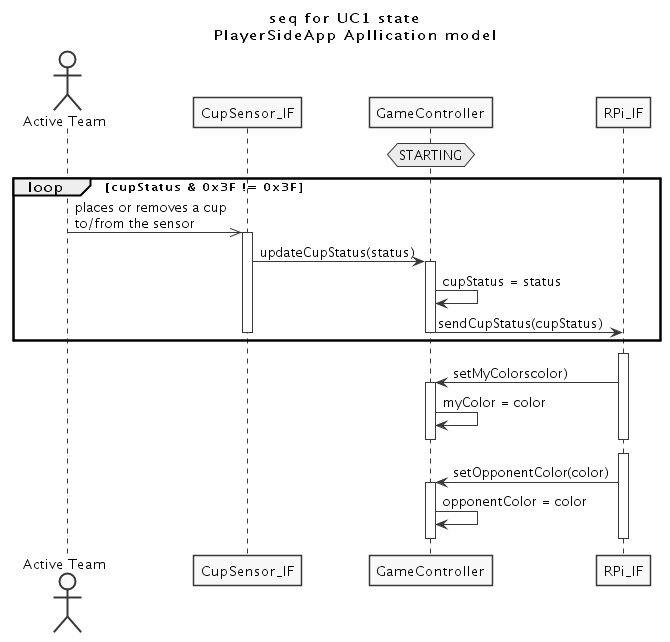
Arkitektur/Softwarearkitektur/PlayerSide/UC1_sequence.png
