prj3grp7/prj3_projekt_dokumentation/Arkitektur/Softwarearkitektur/PlayerSide/updateLight_sequence.png

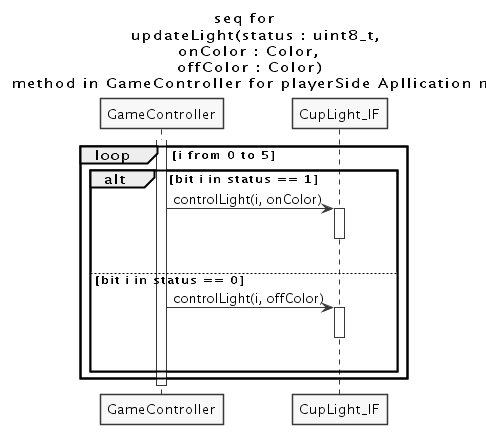
Arkitektur/Softwarearkitektur/PlayerSide/updateLight_sequence.png
