prj3grp7/prj3_projekt_dokumentation/Arkitektur/Softwarearkitektur/teamColor.PNG

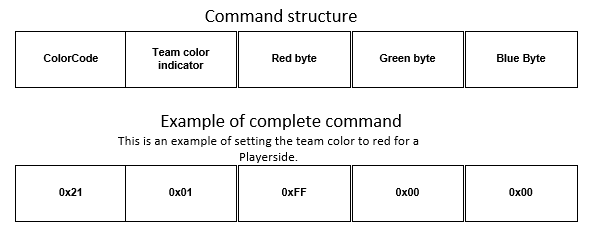
Arkitektur/Softwarearkitektur/teamColor.PNG
