prj3grp7/prj3_projekt_dokumentation/Hardwaredesign/CupSensor/Endelig design/Final_PSoC_Design_Input_part.PNG

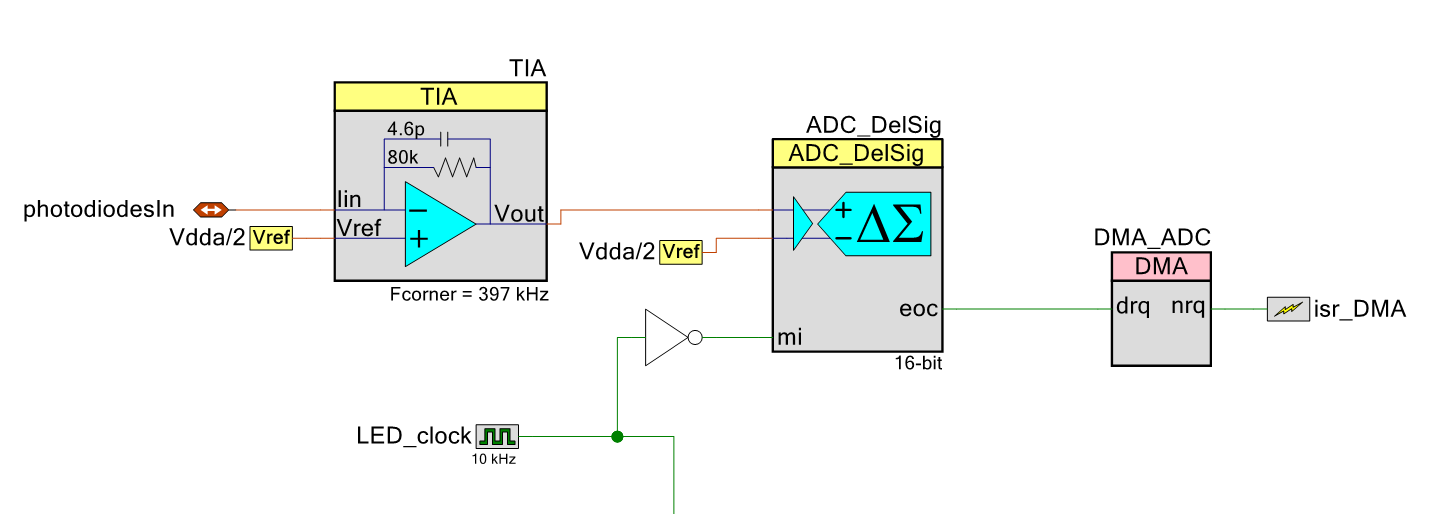
Hardwaredesign/CupSensor/Endelig design/Final_PSoC_Design_Input_part.PNG
