prj3grp7/prj3_projekt_dokumentation/Hardwaredesign/CupSensor/Forskellige metoder til flere sensorer/Multiplexing_en_udgang.PNG

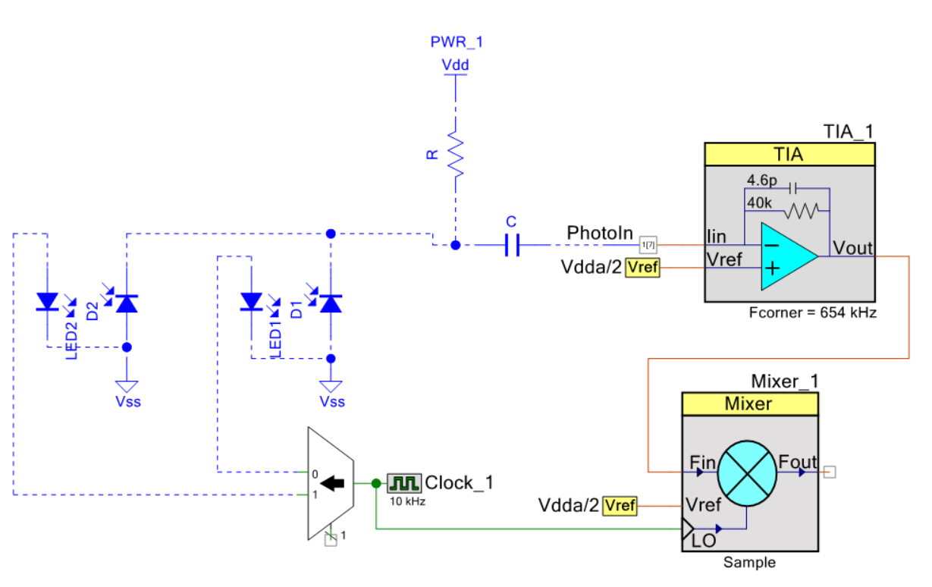
Hardwaredesign/CupSensor/Forskellige metoder til flere sensorer/Multiplexing_en_udgang.PNG
