prj3grp7/prj3_projekt_dokumentation/Hardwaredesign/CupSensor/Skitser/lightPath.png

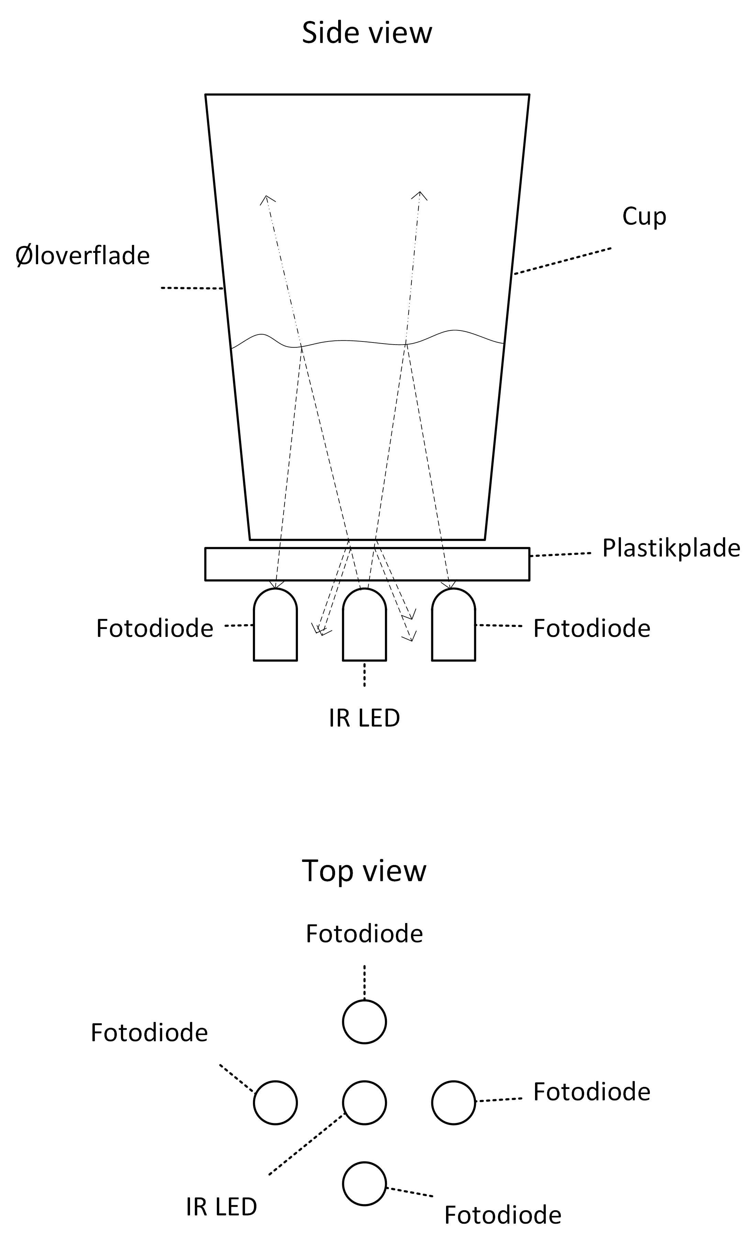
Hardwaredesign/CupSensor/Skitser/lightPath.png
