prj3grp7/prj3_projekt_dokumentation/Softwaredesign/CupSensor_IF/classDiagram.png

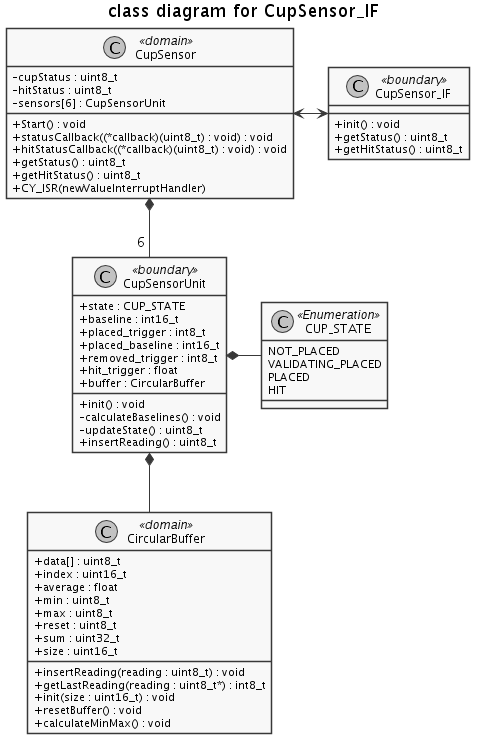
Softwaredesign/CupSensor_IF/classDiagram.png
