prj3grp7/prj3_projekt_dokumentation/Softwaredesign/CupSensor_IF/getting_reading.png

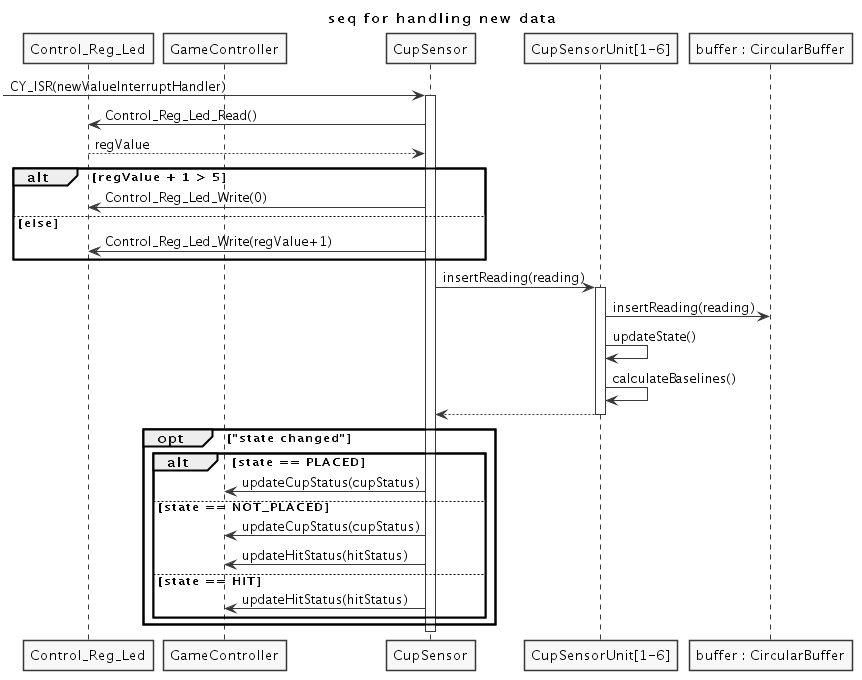
Softwaredesign/CupSensor_IF/getting_reading.png
