prj3grp7/prj3_projekt_dokumentation/Softwaredesign/CupSensor_IF/state.png

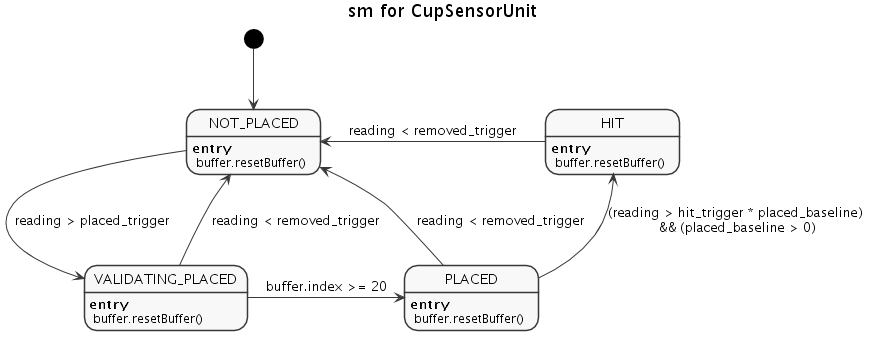
Softwaredesign/CupSensor_IF/state.png
