prj3grp7/prj3_projekt_dokumentation/Hardwaredesign/CupHolder/Rev2/BOM.xlsx

VALUE | # | 12 printplader | REFDES | Person
91 Ohm | 10 | 120 | R1,R6,R7,R8,R9,R10,R11,R12,R13,R16 | Tristan
160 Ohm | 5 | 60 | R5,R14,R15,R17,R18 | Marcus
RGB LED | 5 | 60 | U1,U2,U3,U4,U5 | Nikolaj
SFH 203 FA | 4 | 48 | D1,D2,D3,D4 | Tristan
BC557BG | 3 | 36 | Q2,Q3,Q4 | Marcus
750 Ohm | 3 | 36 | R19,R20,R21 | Nikolaj
16 Ohm | 2 | 24 | R3,R4 | Tristan
BC547BP | 1 | 12 | Q1 | Marcus
SFH485 | 1 | 12 | LED1 | Marcus
820 Ohm | 1 | 12 | R2 | Nikolaj
HDR2X3 | 1 | 12 | J2 | Nikolaj
PJ-102A | 1 | 12 | J1 | Nikolaj
JUMPER | 1 | 12 | J3 | Tristan
