prj3grp7/prj3_projekt_dokumentation/Hardwaredesign/CupSensor/Endelig design/ComponentInTopDesign.PNG

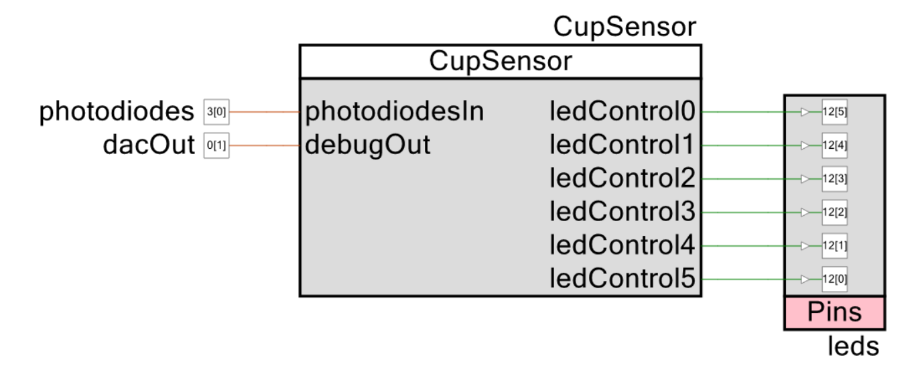
Hardwaredesign/CupSensor/Endelig design/ComponentInTopDesign.PNG
