prj3grp7/prj3_projekt_dokumentation/Hardwaredesign/Bordoverflade/playerside.SLDASM

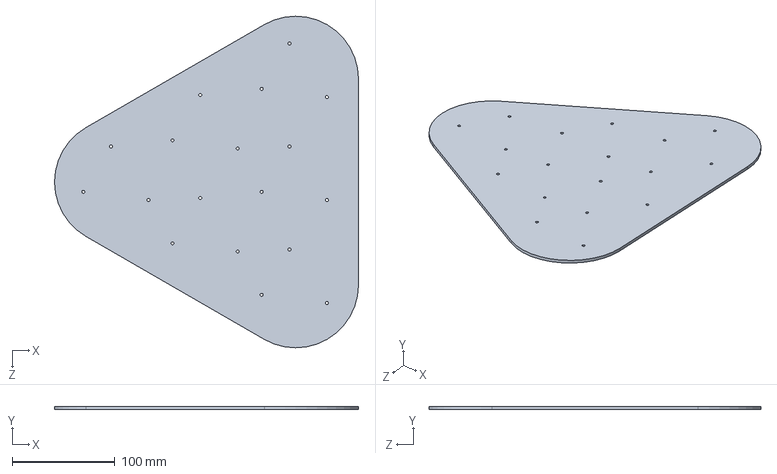
[picture p42: CAD file, 2019-03-05]
Hardwaredesign/Bordoverflade/playerside.SLDASM
295.2 x 3.00 x 322.0 mm
