prj3grp7/prj3_projekt_dokumentation/(list of files, cad)

Other CAD files:
Hardwaredesign/Bordoverflade/Bordoverflade.SLDPRT
Hardwaredesign/Bordoverflade/CupHolder.SLDPRT
Hardwaredesign/Bordoverflade/Bordoverflade.DXF
