prj3grp7/prj3_projekt_dokumentation/Hardwaredesign/CupSensor/Test med printplade/Målinger.xlsx

Sheet: Signal conditioning
Måleobjekt | TIA feedback modstand (kOhm) | positiv peak-værdi (mV) | negativ peak-værdi (mV)
Tom kop | 80 | 1174 | 1004
Kop med bold (uden væske) | 40 | 1124 | 966
kop med 110ml vand | 80 | 814 | 757
kop med bold i 110ml vand | 80 | 1264 | 1058
kop med 220ml vand | 80 | 763 | 720
kop med bold i 220ml vand | 80 | 801 | 751
Kop med 110ml øl med skum | 40 | 663 | 613
Kop med bold i 110ml øl med skum | 40 | 663 | 613 | ingen synlig ændring
Kop med 110ml øl med skum | 80 | 1054 | 936
Kop med 110ml øl med skum | 80 | 1054 | 936 | ingen synlig ændring
Kop med 110ml øl uden skum | 80 | 826 | 813
Kop med bold i 110ml øl uden skum | 80 | 1183 | 989 | går næsten i mætning | 2172
kop med 220ml øl med skum | 40 | 457 | 476 | muligvis for lille forstærkning
kop med 220ml øl med skum | 80 | 919 | 832
kop med bold i 220ml øl med skum | 80 | 919 | 832 | ingen synlig ændring
kop med 220ml øl uden skum | 80 | 707 | 688
kop med bold i 220ml øl uden skum | 80 | 882 | 770

Sheet: Baseline
måling nr | VDAC average spænding ved V_sample[0]>>7 | VDAC p-p | VDAC AC RMS | counts
 | mV | mV | mV |  | countsize | 16 | mV
1 | 482 | 41 | 8 | 30
2 | 460 | 44 | 10 | 29 |  | spænding | counts
3 | 463 | 43 | 10 | 29 | Middelværdi | 466.8 | 29
4 | 464 | 44 | 10 | 29 | Varians | 34.4 | 3
5 | 464 | 43 | 10 | 29 | Standardafvigelse | 5.865151319 | 2
6 | 467 | 43 | 10 | 29 | Maks
7 | 467 | 44 | 10 | 29 | Maks (maks af middel plus havldelen af maks af p-p) | 504 | 32
8 | 467 | 43 | 10 | 29 | min (min af middel minus havldelen af maks af p-p) | 419 | 27
9 | 468 | 44 | 10 | 29
10 | 466 | 42 | 10 | 29

Sheet: 90ml øl
måling nr | VDAC average spænding ved V_sample[0]>>7 | VDAC p-p | VDAC AC RMS | counts
 | mV | mV | mV |  | countsize | 16 | mV
1 | 895 | 71 | 11 | 27
2 | 935 | 28 | 6 | 29 |  | spænding | counts | relative to baseline
3 | 901 | 29 | 7 | 27 | Middelværdi | 917.7 | 57 | 28
4 | 924 | 44 | 10 | 29 | Varians | 166.6777778 | 11
5 | 909 | 45 | 11 | 28 | Standardafvigelse | 12.91037481 | 4
6 | 922 | 60 | 9 | 29 | Maks (maks af middel plus havldelen af maks af p-p) | 970.5 | 61 | 32
7 | 934 | 59 | 10 | 29 | min (min af middel minus havldelen af maks af p-p) | 867 | 55 | 26
8 | 918 | 45 | 8 | 28
9 | 919 | 28 | 6 | 28 | præcision (95% konfidensniveau) | 25.30433463 | 8
10 | 920 | 44 | 7 | 29 | lower threshold | 892.3956654 | 49 | 20
 |  |  |  |  | upper limit | 943.0043346 | 65 | 36

Sheet: 90ml øl - placering og fjernels
måling nr | VDAC peak ved V_sample[0]>>7 | fjernelse peak | counts place | counts removing
 | mV | mV |  |  | countsize | 16 | mV
1 | 1057 | 1045 | 37 | 36 | Placering af kop |  |  |  |  | Fjernelse af kop
2 | 1288 | 1038 | 52 | 36 |  | spænding | counts | relative to baseline | relative change |  | spænding | counts | relative to placed mean | relative change
3 | 1201 | 1239 | 46 | 48 | Middelværdi | 1197.8 | 75 | 46 | 1.642857143 | Middelværdi | 1077.9 | 67 | 38 | 1.357142857
4 | 1276 | 1070 | 51 | 38 | Varians | 6041.288889 | 378 |  |  | Varians | 3566.766667 | 223
5 | 1320 | 1038 | 54 | 36 | Standardafvigelse | 77.72572862 | 20 |  |  | Standardafvigelse | 59.72241344 | 15
6 | 1151 | 1051 | 43 | 37 | Maks (maks af middel plus havldelen af maks af p-p) | 1320 | 83 | 54 | 1.928571429 | Maks (maks af middel plus havldelen af maks af p-p) | 1239 | 77 | 48 | 1.714285714
7 | 1170 | 1082 | 44 | 39 | min (min af middel minus havldelen af maks af p-p) | 1057 | 67 | 38 | 1.357142857 | min (min af middel minus havldelen af maks af p-p) | 1038 | 65 | 36 | 1.285714286
8 | 1182 | 1070 | 45 | 38
9 | 1157 | 1051 | 43 | 37 | præcision (95% konfidensniveau) | 152.3424281 | 40 |  |  | præcision (95% konfidensniveau) | 117.0559303 | 30
10 | 1176 | 1095 | 45 | 39 | lower threshold | 1045.457572 | 35 | 6 |  | lower threshold | 960.8440697 | 37 | 8
 |  |  |  |  | upper limit | 1350.142428 | 115 | 86 |  | upper limit | 1194.95593 | 97 | 68 | 2.428571429

Sheet: 90ml øl fjernes
måling nr | VDAC peak ved V_sample[0]>>7
 | mV
1 | 1045
2 | 1038
3 | 1239
4 | 1070
5 | 1038
6 | 1051
7 | 1082
8 | 1070
9 | 1051
10 | 1095

Sheet: 90ml øl - bold drop
måling nr | VDAC peak ved V_sample[0]>>7 | VDAC negativ peak efter drop ved V_sample[0]>>7 | counts peak
 | mV | mV |  | countsize | 16 | mV
1 | 1846 | 1320 | 86
2 | 1814 | 1195 | 84 |  | spænding | counts | relative to baseline | relative change
3 | 2428 | 988 | 123 | Middelværdi | 2090.4 | 131 | 102 | 3.642857143
4 | 2152 | 1276 | 106 | Varians | 50161.37778 | 3136
5 | 1927 | 1270 | 91 | Standardafvigelse | 223.9673587 | 56
6 | 2190 | 995 | 108 | Maks | 2428 | 152 | 123 | 4.392857143
7 | 2378 | 907 | 120 | min | 1814 | 114 | 85 | 3.035714286
8 | 2271 | 1132 | 113
9 | 2002 | 1370 | 96 | præcision (95% konfidensniveau) | 438.9760231 | 110
10 | 1896 | 1132 | 90 | lower threshold | 1651.423977 | 21 | -8 | -0.2857142857
 |  |  |  | upper limit | 2529.376023 | 241 | 212

Sheet: 90ml øl - ball drop 2
måling nr | VDAC peak ved V_sample[0]>>7 | slut værdi | VDAC negativ peak efter drop ved V_sample[0]>>7
 | mV | mV | mV | countsize | 16 | mV
1 | 1940 | 1251 | 1107
2 | 1558 | 1201 | 1151 |  | spænding | counts | relative to baseline | relative change
3 | 1915 | 1289 | 1201 | Middelværdi | 1919.6 | 120 | 91 | 3.25
4 | 1821 | 1301 | 1201 | Varians | 86492.93333 | 5406
5 | 2378 | 1376 | 925 | Standardafvigelse | 294.0968095 | 74
6 | 1601 | 1151 | 1095 | Maks | 2378 | 149 | 120 | 4.285714286
7 | 2071 | 1414 | 1314 | min | 1533 | 96 | 67 | 2.392857143
8 | 2252 | 1308 | 1082
9 | 1533 | 1076 | 982
10 | 2127 | 1217 | 1114

Sheet: 110ml øl
måling nr | VDAC average spænding ved V_sample[0]>>7 | VDAC p-p | VDAC AC RMS | counts
 | mV | mV | mV |  | countsize | 16 | mV
1 | 863 | 45 | 9 | 25
2 | 877 | 31 | 7 | 26 |  | spænding | counts | relative to baseline
3 | 860 | 46 | 9 | 25 | Middelværdi | 850.2 | 53 | 24
4 | 853 | 46 | 10 | 24 | Varians | 253.0666667 | 16
5 | 847 | 46 | 8 | 24 | Standardafvigelse | 15.90806923 | 4
6 | 846 | 43 | 8 | 24 | Maks (maks af middel plus havldelen af maks af p-p) | 900 | 57 | 28
7 | 861 | 32 | 7 | 25 | min (min af middel minus havldelen af maks af p-p) | 794 | 49 | 20
8 | 830 | 44 | 8 | 23
9 | 825 | 46 | 10 | 23 | præcision (95% konfidensniveau) | 31.17981569 | 8
10 | 840 | 46 | 10 | 24 | lower threshold | 819.0201843 | 45 | 16
 |  |  |  |  | upper limit | 881.3798157 | 61 | 32

Sheet: 110ml øl - placering og fjernel
måling nr | placering VDAC peak ved V_sample[0]>>7 | fjernelse peak | counts | counts removing
 | mV | mV |  |  | countsize | 16 | mV
1 | 1001 | 945 | 34 | 30 | Placering af kop |  |  |  |  | Fjernelse af kop
2 | 1164 | 982 | 44 | 32 |  | spænding | counts | relative to baseline | relative change |  | spænding | counts | relative to placed mean | relative change
3 | 1120 | 1032 | 41 | 36 | Middelværdi | 1128.5 | 71 | 42 | 1.75 | Middelværdi | 1052.1 | 66 | 37 | 1.541666667
4 | 1189 | 1082 | 45 | 39 | Varians | 7615.611111 | 476 |  |  | Varians | 3670.322222 | 230
5 | 1045 | 1038 | 36 | 36 | Standardafvigelse | 87.2674688 | 22 |  |  | Standardafvigelse | 60.58318432 | 16
6 | 1051 | 1051 | 37 | 37 | Maks (maks af middel plus havldelen af maks af p-p) | 1301 | 82 | 53 | 2.208333333 | Maks (maks af middel plus havldelen af maks af p-p) | 1164 | 73 | 44 | 1.833333333
7 | 1301 | 1063 | 52 | 37 | min (min af middel minus havldelen af maks af p-p) | 1001 | 63 | 34 | 1.416666667 | min (min af middel minus havldelen af maks af p-p) | 945 | 60 | 31 | 1.291666667
8 | 1095 | 1164 | 39 | 44
9 | 1132 | 1101 | 42 | 40 | præcision (95% konfidensniveau) | 171.0442389 | 44
10 | 1187 | 1063 | 45 | 37 | lower threshold | 957.4557611 | 27 | -2
 |  |  |  |  | upper limit | 1299.544239 | 115 | 86

Sheet: 110ml øl - drop
måling nr | VDAC peak ved V_sample[0]>>7 | slut værdi | VDAC negativ peak efter drop ved V_sample[0]>>7 | counts peak
 | mV | mV | mV |  | countsize | 16 | mV
1 | 1721 | 995 | 970 | 79
2 | 1940 | 1114 | 945 | 92 |  | spænding | counts | relative to baseline | relative change
3 | 1708 | 1101 | 1063 | 78 | Middelværdi | 1813 | 113 | 84 | 3.5
4 | 2096 | 901 | 1076 | 102 | Varians | 78604.44444 | 4913
5 | 1420 | 1057 | 988 | 60 | Standardafvigelse | 280.3648417 | 71
6 | 1664 | 1038 | 932 | 75 | Maks | 2157 | 135 | 106 | 4.416666667
7 | 2052 | 1201 | 1051 | 99 | min | 1364 | 86 | 57 | 2.375
8 | 1364 | 1020 | 932 | 56
9 | 2008 | 1264 | 1201 | 97
10 | 2157 | 1126 | 938 | 106

Sheet: 110ml øl - kast (rammer kant)
måling nr | VDAC peak ved V_sample[0]>>7 | slut værdi | VDAC negativ peak efter drop ved V_sample[0]>>7
 | mV | mV | mV | countsize | 16 | mV
1 | 1195 | 1187 | 963
2 | 1333 | 1214 | 1176 |  | spænding | counts | relative to baseline | relative change
3 | 2008 | 1257 | 1176 | Middelværdi | 1460.2 | 92 | 63 | 2.625
4 | 1226 | 1157 | 1057 | Varians | 111913.7 | 6995
5 | 1539 | 1038 | 920 | Standardafvigelse | 334.5350505 | 84
 |  |  |  | Maks | 2008 | 126 | 97 | 4.041666667
 |  |  |  | min | 1195 | 75 | 46 | 1.916666667

Sheet: 130ml øl
måling nr | VDAC average spænding ved V_sample[0]>>7 | VDAC p-p | VDAC AC RMS | counts
 | mV | mV | mV |  | countsize | 16 | mV
1 | 778 | 58 | 9 | 20
2 | 807 | 31 | 6 | 21 |  | spænding | counts | relative to baseline
3 | 794 | 44 | 7 | 21 | Middelværdi | 812 | 51 | 22
4 | 799 | 73 | 11 | 21 | Varians | 425.7777778 | 27
5 | 811 | 44 | 9 | 22 | Standardafvigelse | 20.63438339 | 6
6 | 816 | 58 | 10 | 22 | Maks (maks af middel plus havldelen af maks af p-p) | 884.5 | 56 | 27
7 | 814 | 45 | 10 | 22 | min (min af middel minus havldelen af maks af p-p) | 747 | 47 | 18
8 | 812 | 45 | 9 | 22
9 | 841 | 45 | 10 | 24 | præcision (95% konfidensniveau) | 40.44339144 | 12
10 | 848 | 45 | 10 | 24 | lower threshold | 771.5566086 | 39 | 10
 |  |  |  |  | upper limit | 852.4433914 | 63 | 34

Sheet: 130ml øl - placering og fjernel
måling nr | placering VDAC peak ved V_sample[0]>>7 | fjernelse peak | counts | counts removing
 | mV | mV |  |  | countsize | 16 | mV
1 | 1063 | 995 | 37 | 33 | Placering af kop |  |  |  |  | Fjernelse af kop
2 | 1095 | 982 | 39 | 32 |  | spænding | counts | relative to baseline | relative change |  | spænding | counts | relative to placed mean | relative change
3 | 970 | 1007 | 32 | 34 | Middelværdi | 1007.8 | 63 | 34 | 1.545454545 | Middelværdi | 993.2 | 63 | 34 | 1.545454545
4 | 1020 | 1007 | 35 | 34 | Varians | 1718.4 | 108 |  |  | Varians | 943.0666667 | 59
5 | 1007 | 925 | 34 | 29 | Standardafvigelse | 41.45358851 | 11 |  |  | Standardafvigelse | 30.70939053 | 8
6 | 969 | 1032 | 32 | 36 | Maks | 1095 | 69 | 40 | 1.818181818 | Maks | 1032 | 65 | 36 | 1.636363636
7 | 988 | 1020 | 33 | 35 | min | 969 | 61 | 32 | 1.454545455 | min | 925 | 58 | 29 | 1.318181818
8 | 995 | 963 | 33 | 31
9 | 995 | 1007 | 33 | 34 | præcision (95% konfidensniveau) | 81.24903347 | 22
10 | 976 | 994 | 32 | 33 | lower threshold | 926.5509665 | 41 | 12
 |  |  |  |  | upper limit | 1089.049033 | 85 | 56

Sheet: 130ml øl - ball drop
måling nr | VDAC peak ved V_sample[0]>>7 | slut værdi | VDAC negativ peak efter drop ved V_sample[0]>>7 | counts peak
 | mV | mV | mV |  | countsize | 16 | mV
1 | 1821 | 1089 | 907 | 85
2 | 2065 | 1107 | 799 | 100 |  | spænding | counts | relative to placed mean | relative change
3 | 1483 | 1145 | 1095 | 64 | Middelværdi | 1712.5 | 107 | 78 | 3.545454545
4 | 2002 | 1120 | 957 | 96 | Varians | 82417.83333 | 5152
5 | 2027 | 1114 | 913 | 98 | Standardafvigelse | 287.0850629 | 72
6 | 1320 | 1051 | 1013 | 54 | Maks | 2065 | 130 | 101 | 4.590909091
7 | 1771 | 1095 | 982 | 82 | min | 1301 | 82 | 53 | 2.409090909
8 | 1808 | 1132 | 1082 | 84
9 | 1527 | 1120 | 1026 | 66
10 | 1301 | 1082 | 1013 | 52
