prj3grp7/prj3_projekt_dokumentation/Hardwaredesign/CupSensor/Test med printplade/90ml_beer_ball_drop_2.png

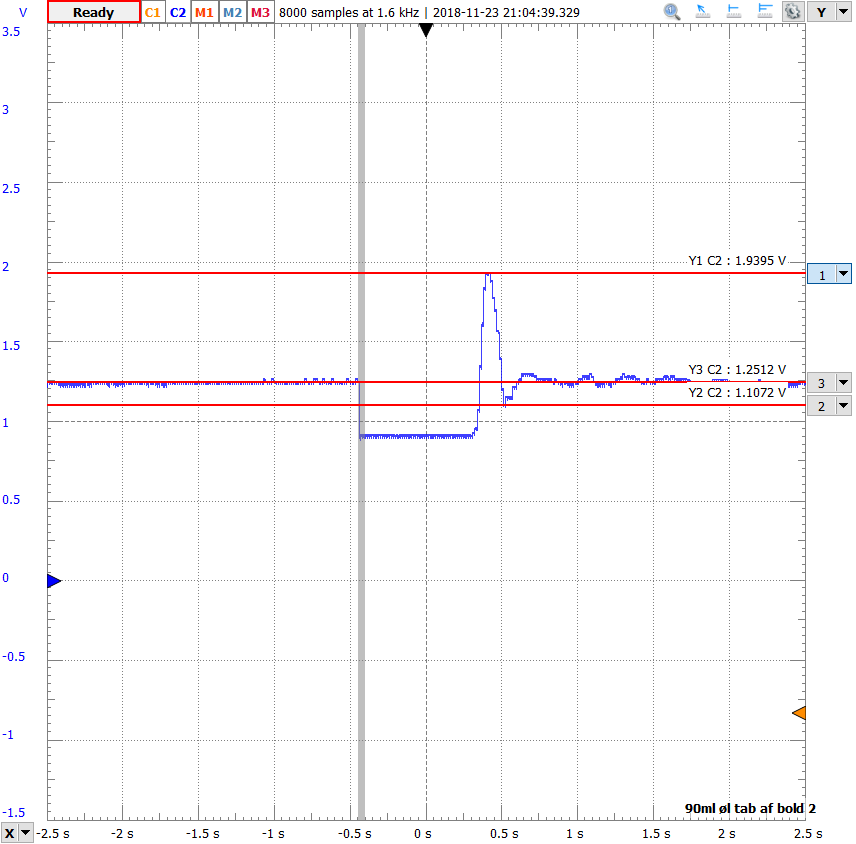
Hardwaredesign/CupSensor/Test med printplade/90ml_beer_ball_drop_2.png
