prj3grp7/prj3_projekt_dokumentation/Hardwaredesign/CupSensor/Test med printplade/110ml_beer_with_skum_80k.png

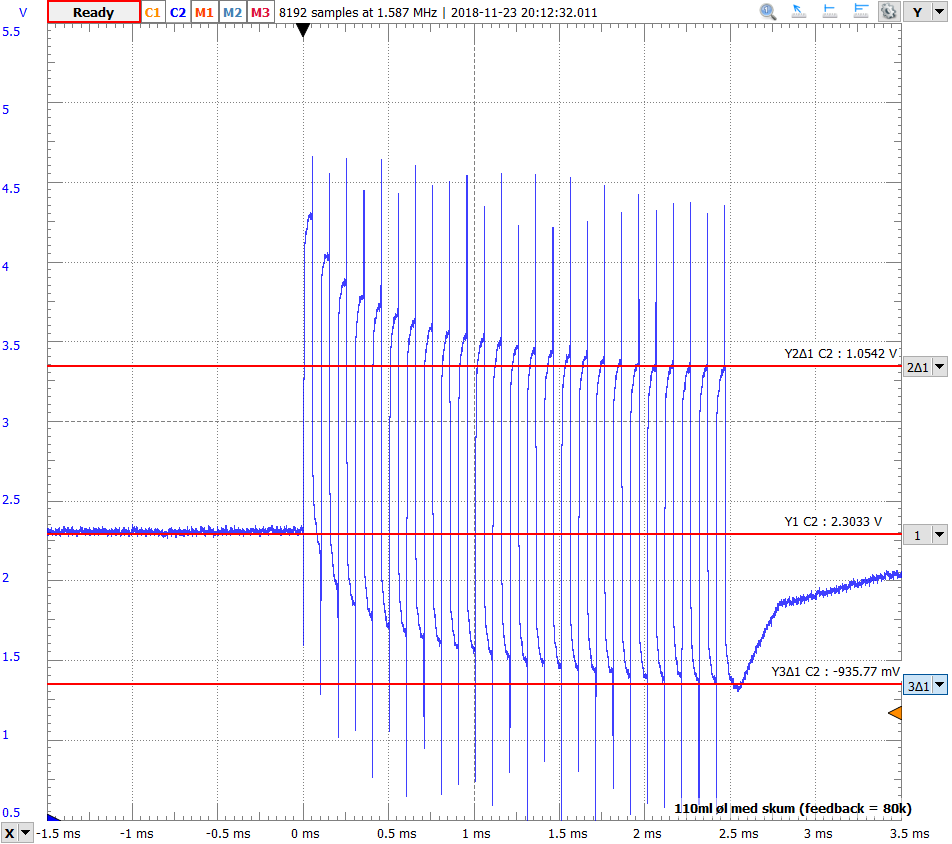
Hardwaredesign/CupSensor/Test med printplade/110ml_beer_with_skum_80k.png
