prj3grp7/prj3_projekt_dokumentation/Hardwaredesign/CupSensor/Test med printplade/TIA_saturation.png

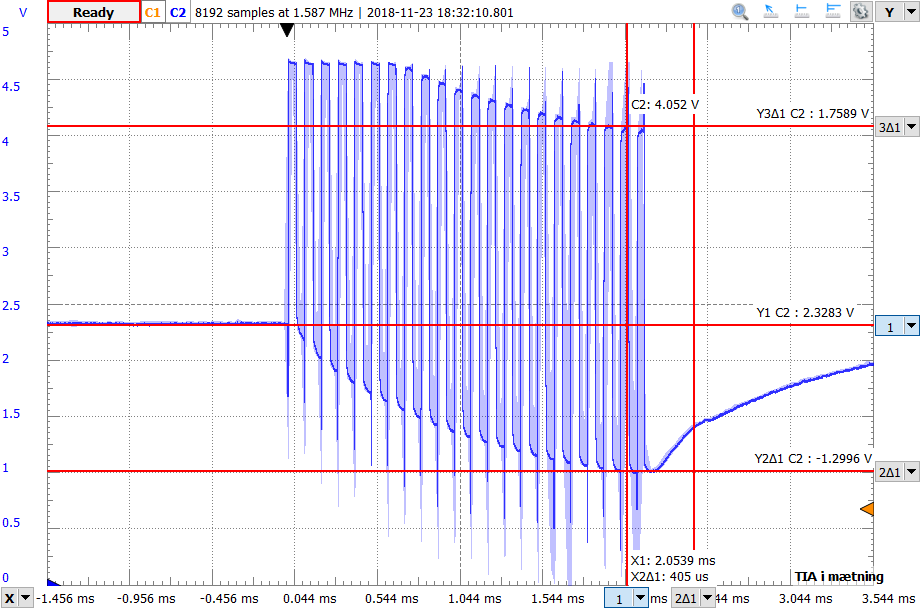
Hardwaredesign/CupSensor/Test med printplade/TIA_saturation.png
