prj3grp7/prj3_projekt_dokumentation/Hardwaredesign/CupSensor/Test af kapacitiv sensor/placingCup1.csv

Index | Time-stamp | Button0__BTN_Raw | Button0__BTN_Baseline | Button0__BTN_Signal | Button0__BTN_Status
0 | 17:10:21.5025 | 2785 | 2572 | 213 | 1
