prj3grp7/prj3_projekt_dokumentation/Hardwaredesign/CupSensor/Test af optisk sensor/Testresultater.xlsx

Sheet: Vref = 0V
Antal fumlebræt hullers afstand | R_f (kOhm) | R_led (Ohm) | frekvens (kHz) | V_led (pk-pk) (V) | uden kop (avg) (mV) | med kop (avg)(mV) | med bold i kanten (avg) (mV) | med bold i centrum (avg)(mV) | mængde væske (ml) | materiale | vinkel (i forhold til lodret)
11 | 250 | 75/2 | 5 | 3.33 | -92 | -75 | -25 | -44 | 110 | vand | 0
10 | 250 | 75/2 | 5 | 3.33 | -90 | -71 | -9 | 4 | 110 | vand | 0
9 | 250 | 75/2 | 5 | 3.33 | -85 | -57 | 26 | 30 | 110 | vand | 0
8 | 250 | 75/2 | 5 | 3.33 | -75 | -22 | 83 | 115 | 110 | vand | 0
7 | 250 | 75/2 | 5 | 3.33 | -70 | 0 | 110 | 181 | 110 | vand | 0
6 | 250 | 75/2 | 5 | 3.33
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
