prj3grp7/prj3_projekt_dokumentation/Hardwaredesign/CupSensor/Modultest/Time-test-start.PNG

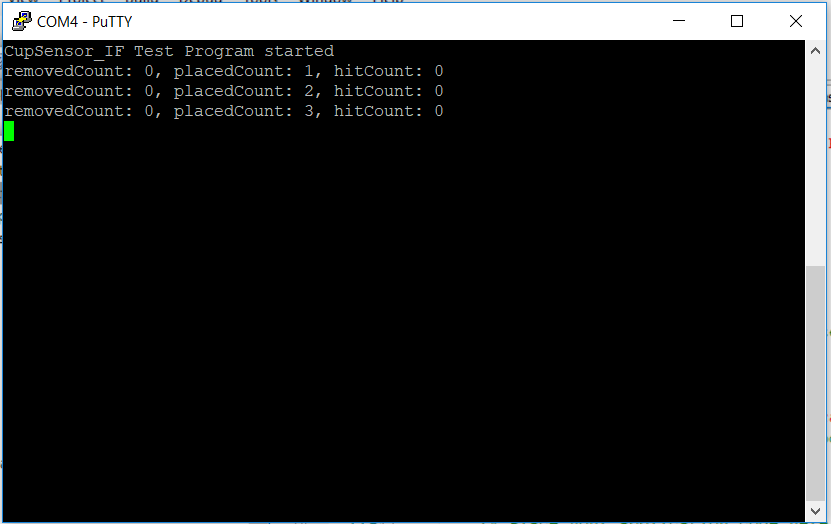
Hardwaredesign/CupSensor/Modultest/Time-test-start.PNG
