prj3grp7/prj3_projekt_dokumentation/Hardwaredesign/CupSensor/Test af kapacitiv sensor/placingAndRemovingCup1(beer).jpg

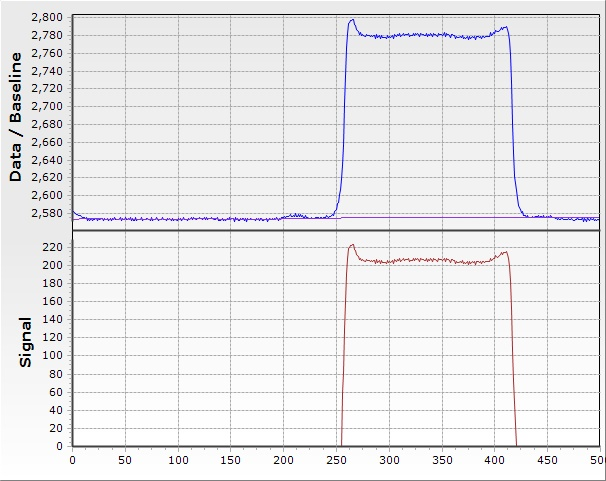
Hardwaredesign/CupSensor/Test af kapacitiv sensor/placingAndRemovingCup1(beer).jpg
