prj3grp7/prj3_projekt_dokumentation/Hardwaredesign/CupSensor/Test af kapacitiv sensor/placingAndRemovingCup2(beer-220ml).jpg

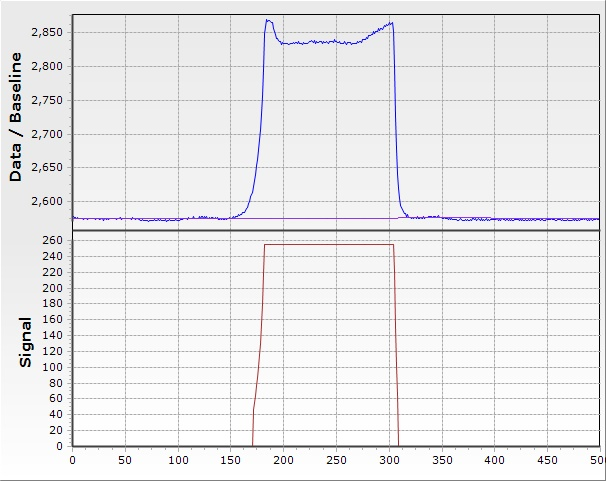
Hardwaredesign/CupSensor/Test af kapacitiv sensor/placingAndRemovingCup2(beer-220ml).jpg
