prj3grp7/prj3_projekt_dokumentation/Hardwaredesign/CupSensor/Test af kapacitiv sensor/placingCup1.jpg

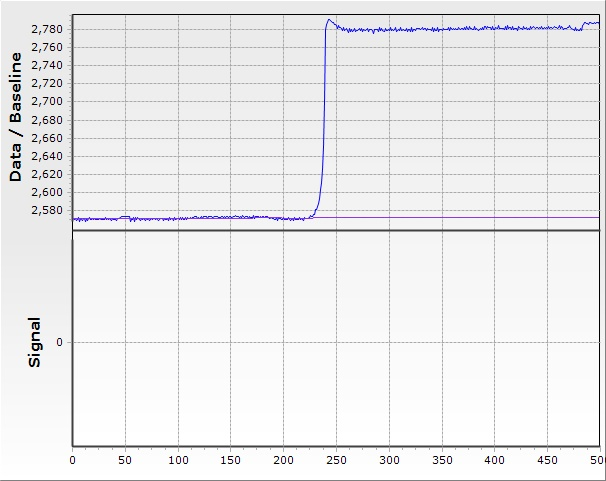
Hardwaredesign/CupSensor/Test af kapacitiv sensor/placingCup1.jpg
