prj3grp7/prj3_projekt_dokumentation/Hardwaredesign/CupSensor/Test af kapacitiv sensor/placingCupAndGoingAway(vand).jpg

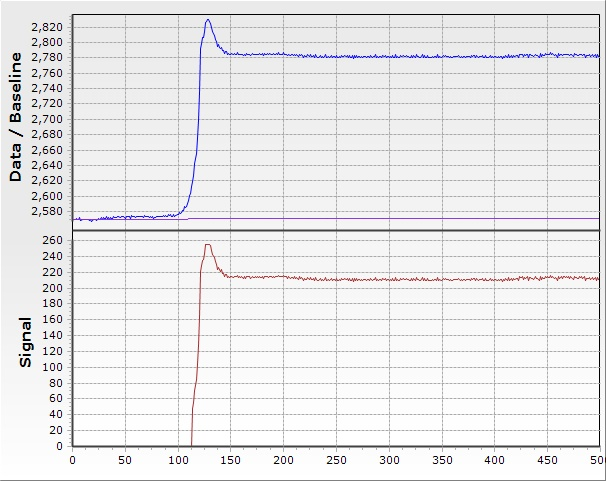
Hardwaredesign/CupSensor/Test af kapacitiv sensor/placingCupAndGoingAway(vand).jpg
