prj3grp7/prj3_projekt_dokumentation/Hardwaredesign/CupSensor/Test af optisk sensor/beer_afstand.PNG

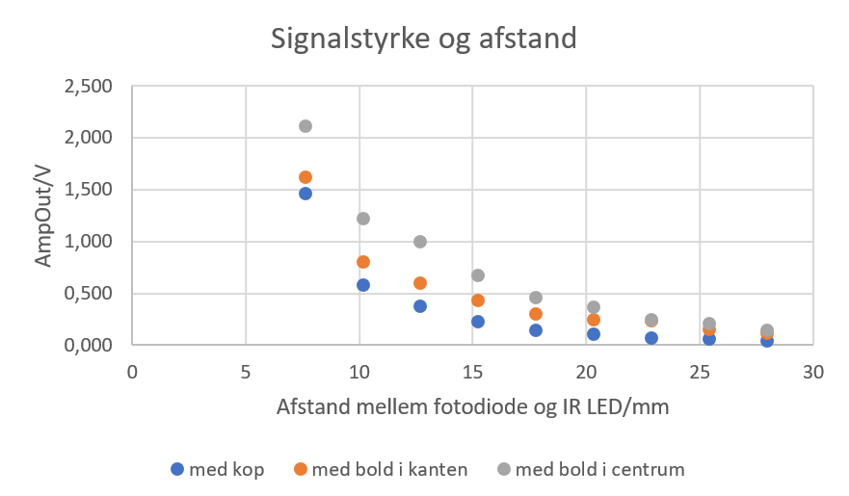
Hardwaredesign/CupSensor/Test af optisk sensor/beer_afstand.PNG
