prj3grp7/prj3_projekt_dokumentation/Hardwaredesign/CupSensor/Test af optisk sensor/diagram.PNG

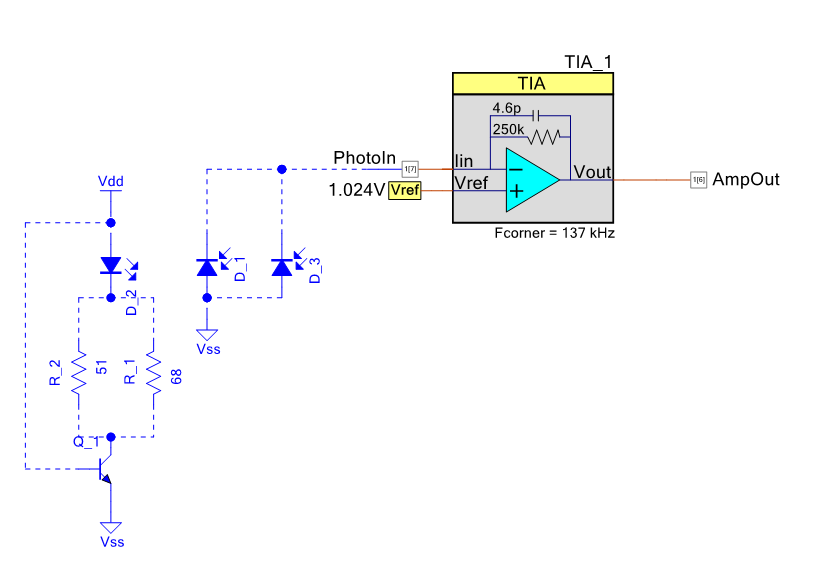
Hardwaredesign/CupSensor/Test af optisk sensor/diagram.PNG
