prj3grp7/prj3_projekt_dokumentation/Hardwaredesign/CupSensor/Test af optisk sensor/Drop af bold i øl - 4.png

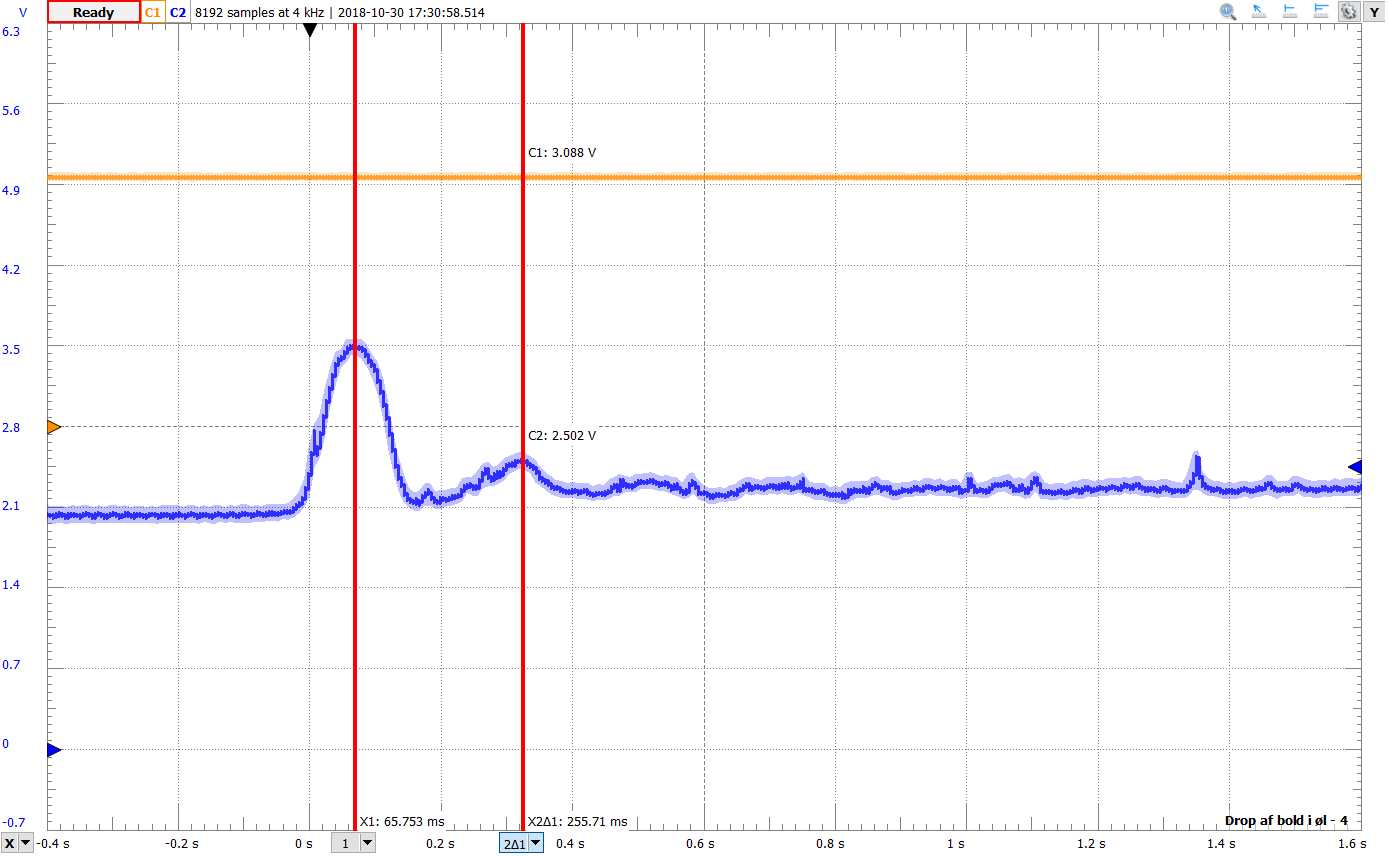
Hardwaredesign/CupSensor/Test af optisk sensor/Drop af bold i øl - 4.png
