prj3grp7/prj3_projekt_dokumentation/Hardwaredesign/CupSensor/Test af optisk sensor/placingCupAndDroppingBall(110ml-beer).png

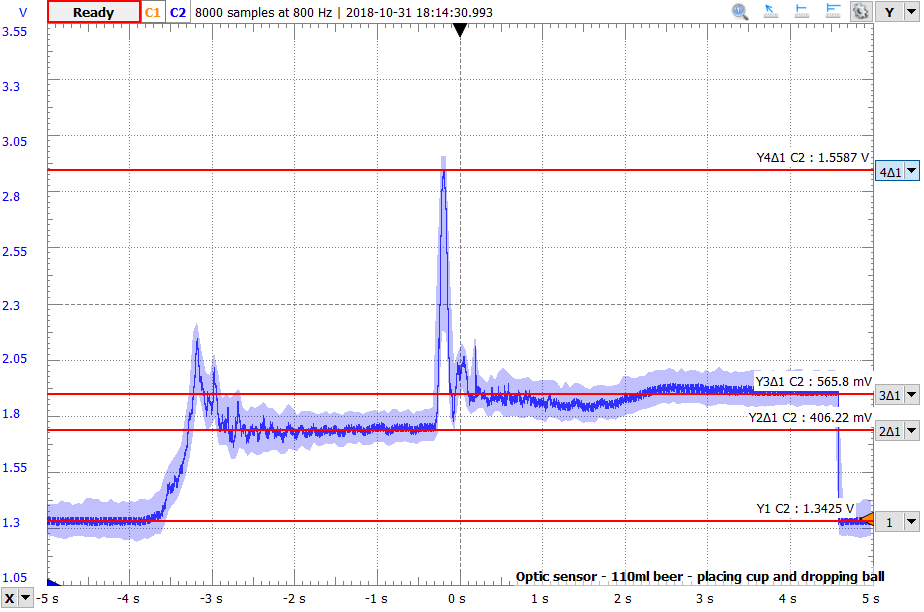
Hardwaredesign/CupSensor/Test af optisk sensor/placingCupAndDroppingBall(110ml-beer).png
