prj3grp7/prj3_projekt_dokumentation/Hardwaredesign/CupSensor/Test med flere sensorer/DC_current_10k_4_diodes_outdoor_cloudy.png

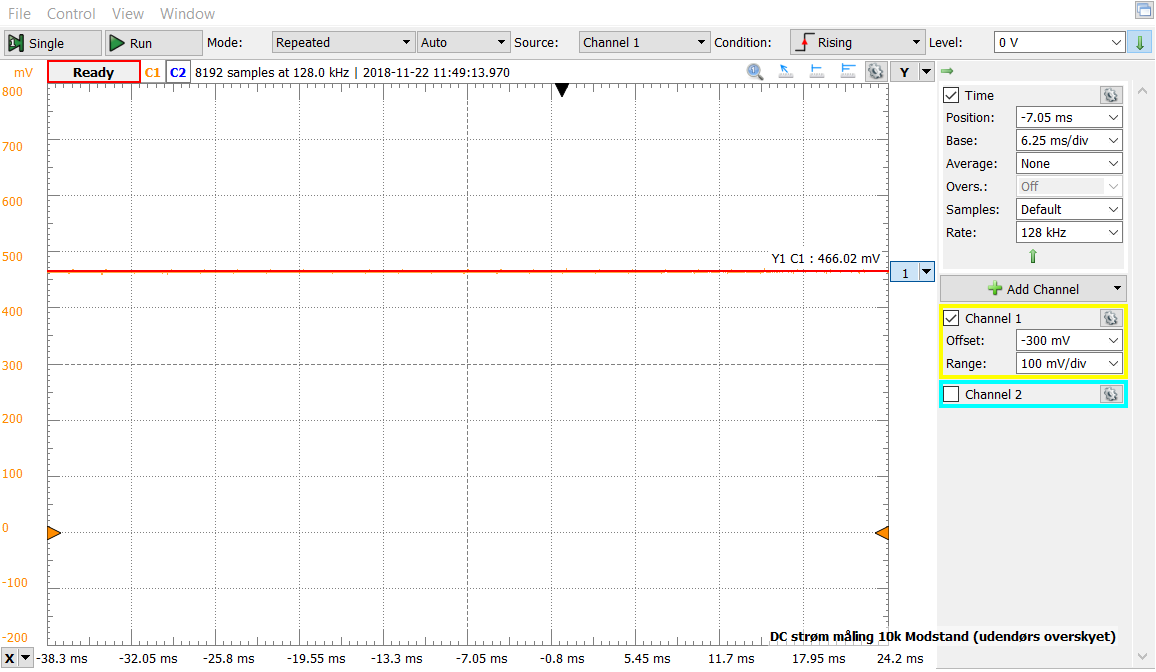
Hardwaredesign/CupSensor/Test med flere sensorer/DC_current_10k_4_diodes_outdoor_cloudy.png
