prj3grp7/prj3_projekt_dokumentation/Hardwaredesign/CupSensor/Test med flere sensorer/DC_current_100k_4_diodes.png

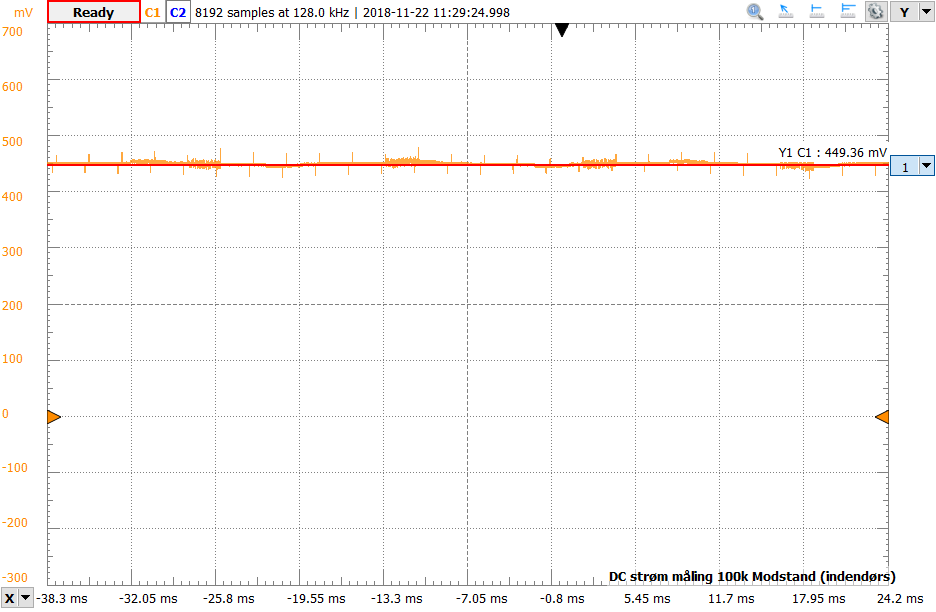
Hardwaredesign/CupSensor/Test med flere sensorer/DC_current_100k_4_diodes.png
