prj3grp7/prj3_projekt_dokumentation/Hardwaredesign/CupSensor/Test med flere sensorer/Mixer_tia_stigetid.png

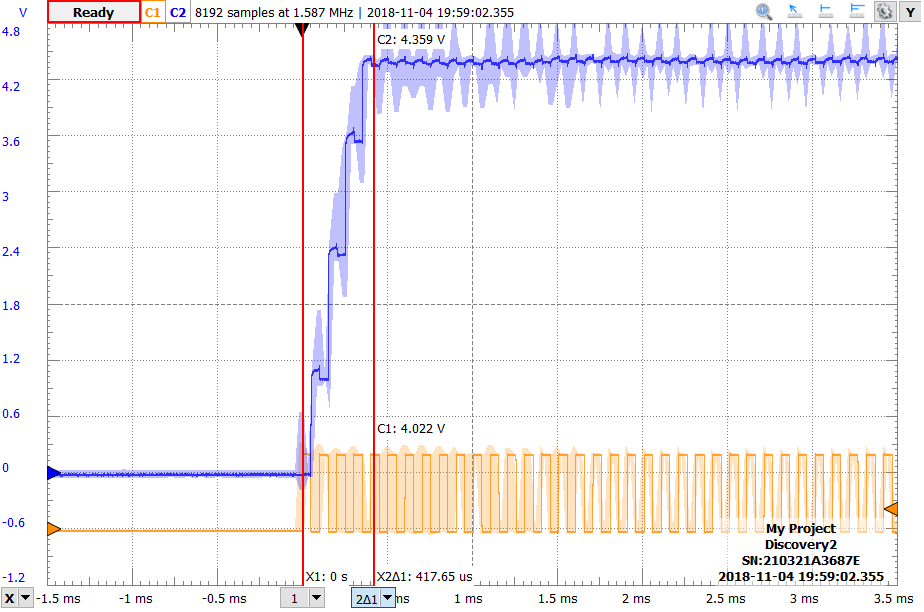
Hardwaredesign/CupSensor/Test med flere sensorer/Mixer_tia_stigetid.png
