prj3grp7/prj3_projekt_dokumentation/Softwaredesign/Demoer/BeerPongTable_LED_Demo/Design01.cydsn/CortexM3/ARM_GCC_541/Debug/LINK_options.txt

-Wl,--start-group -o "C:\\Users\\Marcus\ Gasberg\\Documents\\GitHub\\i3prj_projekt\\Softwaredesign\\Demoer\\BeerPongTable_LED_Demo\\Design01.cydsn\\CortexM3\\ARM_GCC_541\\Debug\\Design01.elf" ".\\CortexM3\\ARM_GCC_541\\Debug\\main.o" ".\\CortexM3\\ARM_GCC_541\\Debug\\rgb_led.o" ".\\CortexM3\\ARM_GCC_541\\Debug\\light_control.o" ".\\CortexM3\\ARM_GCC_541\\Debug\\cyfitter_cfg.o" ".\\CortexM3\\ARM_GCC_541\\Debug\\cymetadata.o" ".\\CortexM3\\ARM_GCC_541\\Debug\\Cm3Start.o" ".\\CortexM3\\ARM_GCC_541\\Debug\\Design01.a" "F:\\Marcus\\software\\PSoC\ Creator\\4.2\\PSoC\ Creator\\psoc\\content\\cycomponentlibrary\\CyComponentLibrary.cylib\\CortexM3\\ARM_GCC_541\\Debug\\CyComponentLibrary.a" -mcpu=cortex-m3 -mthumb -L "Generated_Source\\PSoC5" "-Wl,-Map,.\\CortexM3\\ARM_GCC_541\\Debug/Design01.map" -T "Generated_Source\\PSoC5\\cm3gcc.ld" -specs=nano.specs -Wl,--gc-sections -g -ffunction-sections -Og -ffat-lto-objects -Wl,--end-group
