prj3grp7/prj3_projekt_dokumentation/Hardwaredesign/CupHolder/Rev2/CupHolder.pdf

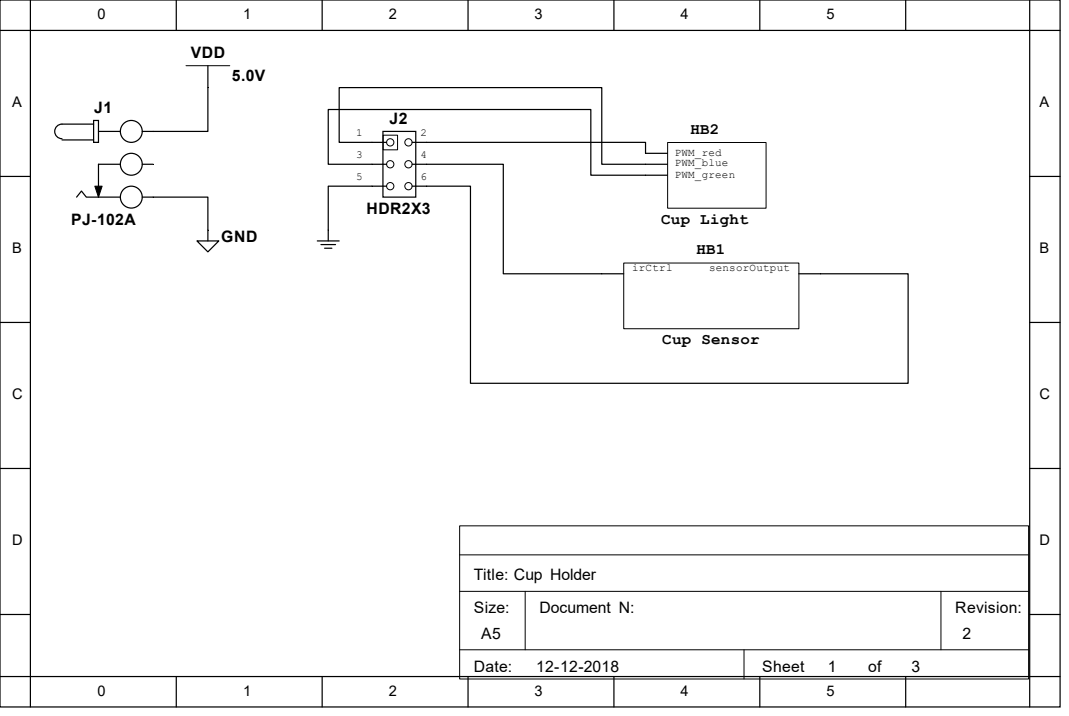
[picture p77: page 1]
VDD; Cup Sensor; irCtrl; sensorOutput; Cup Light; PWM_red PWM_blue PWM_green; HDR2X3; GND; Title:; Document N:; Date:; Sheet; Size:; Revision:; Cup Holder
