prj3grp7/prj3_projekt_dokumentation/Arkitektur/BDD_og_IBD.pdf

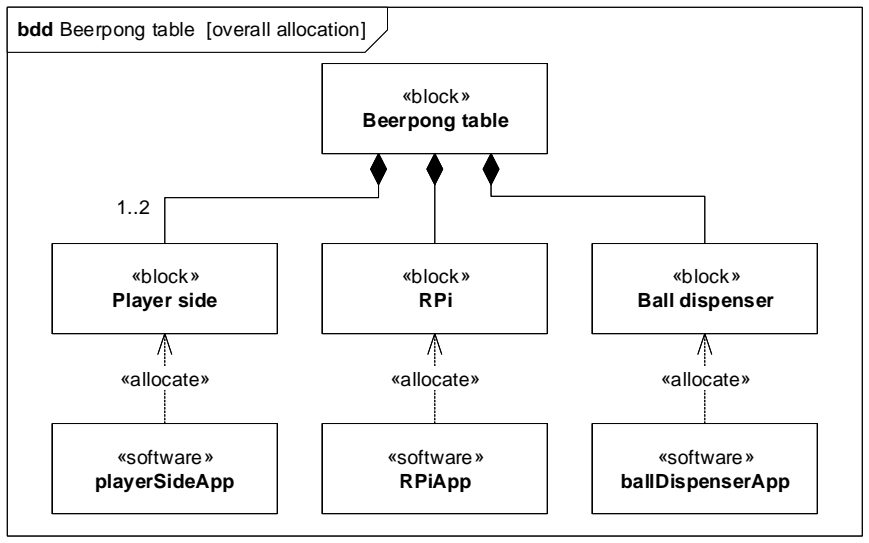
[picture p78: figure]
bdd Beerpong table [overall allocation]; «block» Beerpong table; «block» Player side; «block» RPi; «block» Ball dispenser; «software» playerSideApp; «software» RPiApp; «software» ballDispenserApp; «allocate»

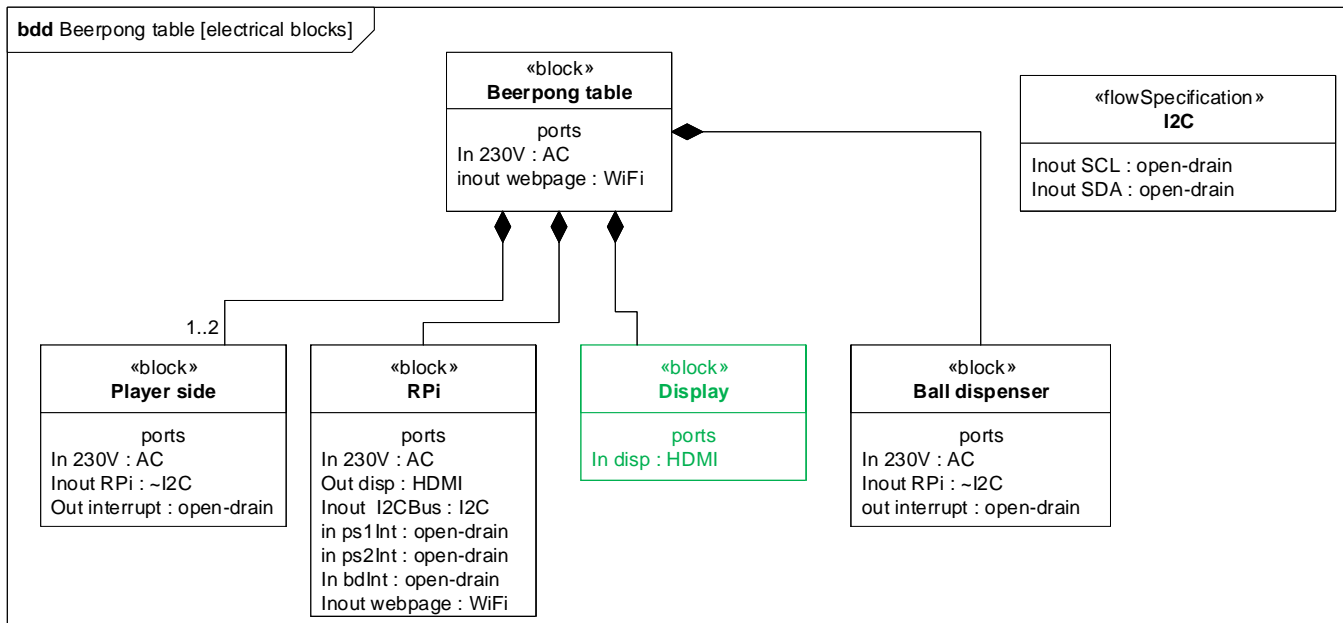
[picture p79: figure]
ports In 230V : AC inout webpage : WiFi; «block» Beerpong table; ports In 230V : AC Out disp : HDMI Inout I2CBus : I2C in ps1Int : open-drain in ps2Int : open-drain In bdInt : open-drain Inout webpage : WiFi; «block» RPi; ports In disp : HDMI; «block» Display; ports In 230V : AC Inout RPi : ~I2C Out interrupt : open-drain; «block» Player side; ports In 230V : AC Inout RPi : ~I2C out interrupt : open-drain; «block» Ball dispenser; bdd Beerpong table [electrical blocks]; Inout SCL : open-drain Inout SDA : open-drain; «flowSpecification» I2C
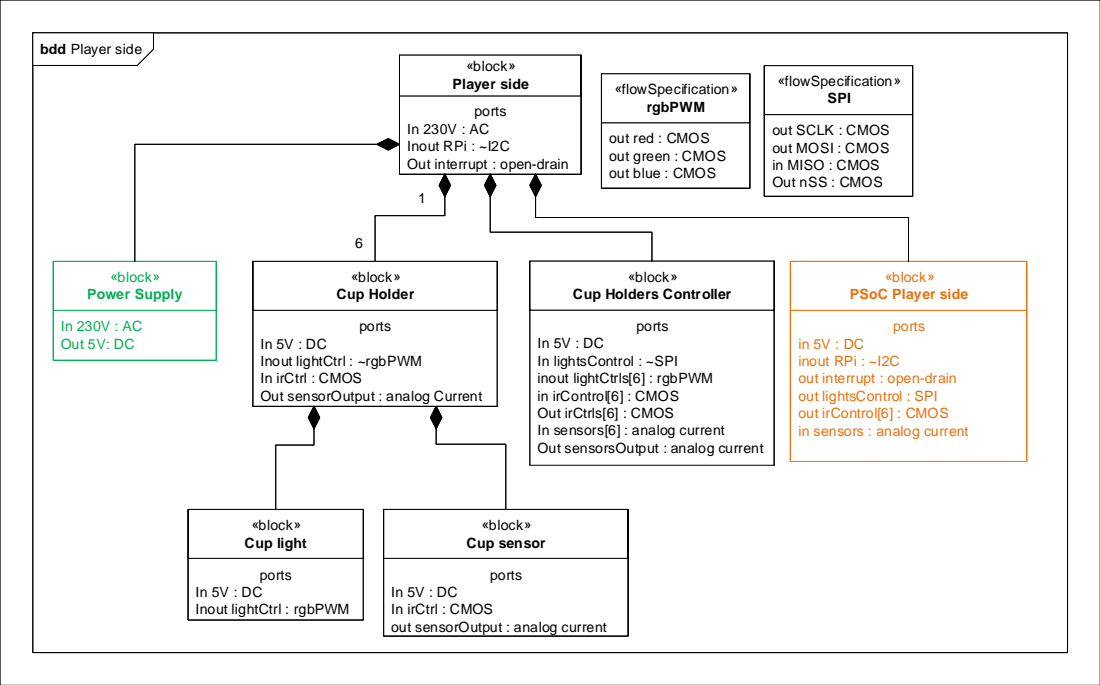
[picture p80: page 3]
ports; «block» Cup light; «block» Cup sensor; «block» Player side; «block» Cup Holder; «flowSpecification» rgbPWM; «block»; «flowSpecification» SPI; In 230V : AC Out 5V: DC; «block» Power Supply

bdd Player side

Inout RPi : ~I2C
Out interrupt : open-drain

out red : CMOS
out green : CMOS
out blue : CMOS

out SCLK : CMOS
out MOSI : CMOS
in MISO : CMOS
Out nSS : CMOS

«block»
PSoC Player side

Cup Holders Controller

Inout lightCtrl : ~rgbPWM
In irCtrl : CMOS
Out sensorOutput : analog Current

In lightsControl : ~SPI
inout lightCtrls[6] : rgbPWM
in irControl[6] : CMOS
Out irCtrls[6] : CMOS
In sensors[6] : analog current
Out sensorsOutput : analog current

inout RPi : ~I2C
out interrupt : open-drain
out lightsControl : SPI
out irControl[6] : CMOS
in sensors : analog current

Inout lightCtrl : rgbPWM

out sensorOutput : analog current

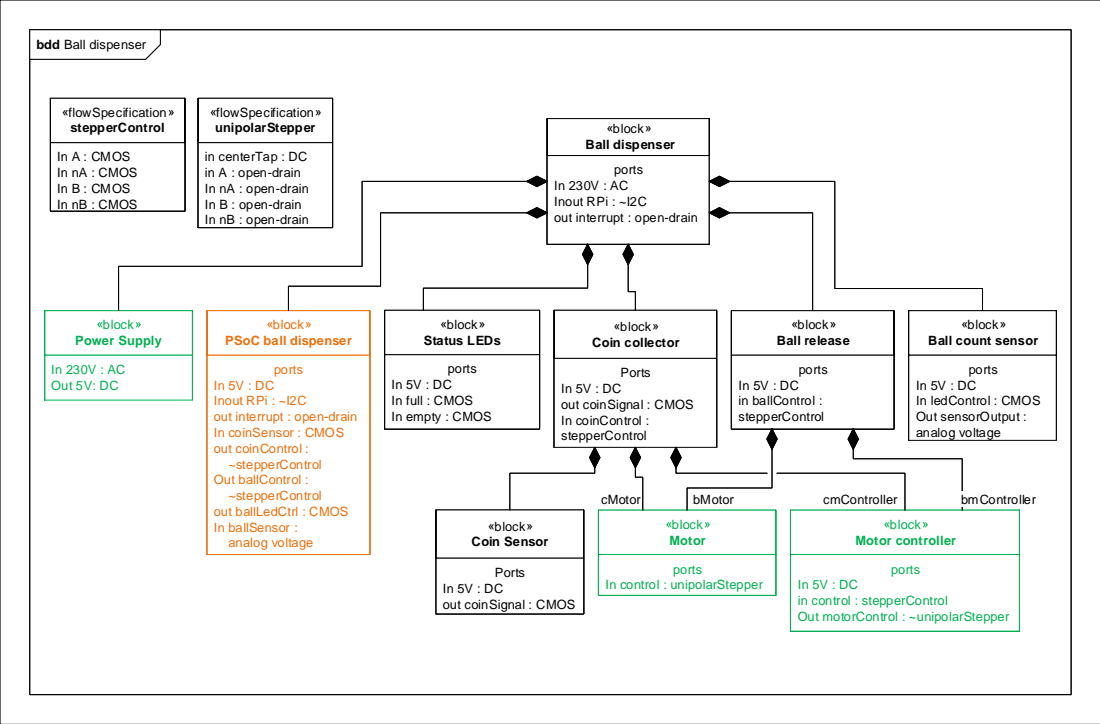
[picture p81: page 4]
Ports; «block» Coin collector; ports; ports In 5V : DC in ballControl : stepperControl; «block» Ball release; «block» Ball dispenser; «block»; «block» Motor; «block» Motor controller; bMotor; bmController; «block» Status LEDs; In 230V : AC Out 5V: DC; «block» Power Supply; «block» Coin Sensor; cMotor; cmController; «flowSpecification» stepperControl; «flowSpecification» unipolarStepper

bdd Ball dispenser

In A : CMOS
In nA : CMOS
In B : CMOS
In nB : CMOS

in centerTap : DC
in A : open-drain
In nA : open-drain
In B : open-drain
In nB : open-drain

Inout RPi : ~I2C
out interrupt : open-drain

«block»
Ball count sensor

PSoC ball dispenser

In coinSensor : CMOS
out coinControl :
~stepperControl
Out ballControl :
out ballLedCtrl : CMOS
In ballSensor :
analog voltage

In full : CMOS
In empty : CMOS

out coinSignal : CMOS
In coinControl :
stepperControl

In ledControl : CMOS
Out sensorOutput :

In control : unipolarStepper

in control : stepperControl
Out motorControl : ~unipolarStepper

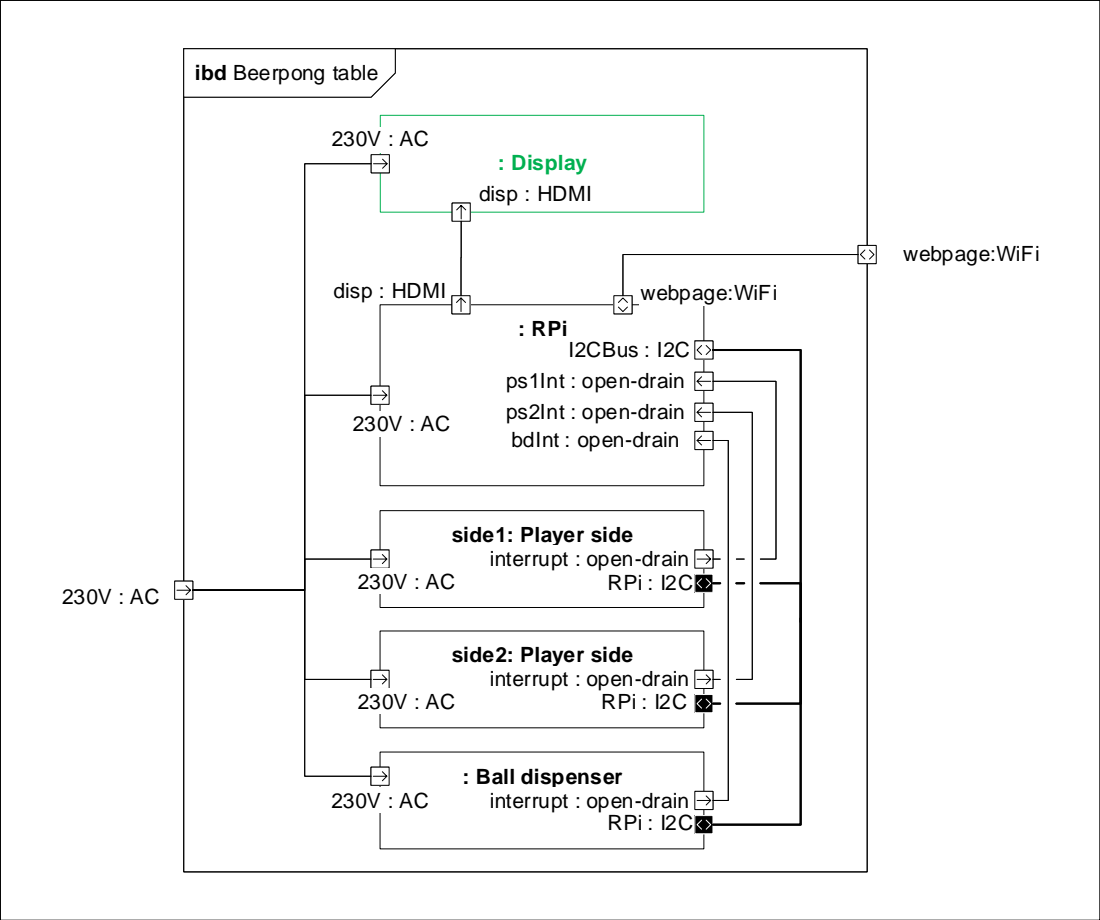
[picture p82: page 5]
: RPi; : Display; I2CBus : I2C; RPi : I2C; disp : HDMI; webpage:WiFi

ibd Beerpong table

ps1Int : open-drain
ps2Int : open-drain
bdInt : open-drain

side1: Player side
interrupt : open-drain

side2: Player side

: Ball dispenser

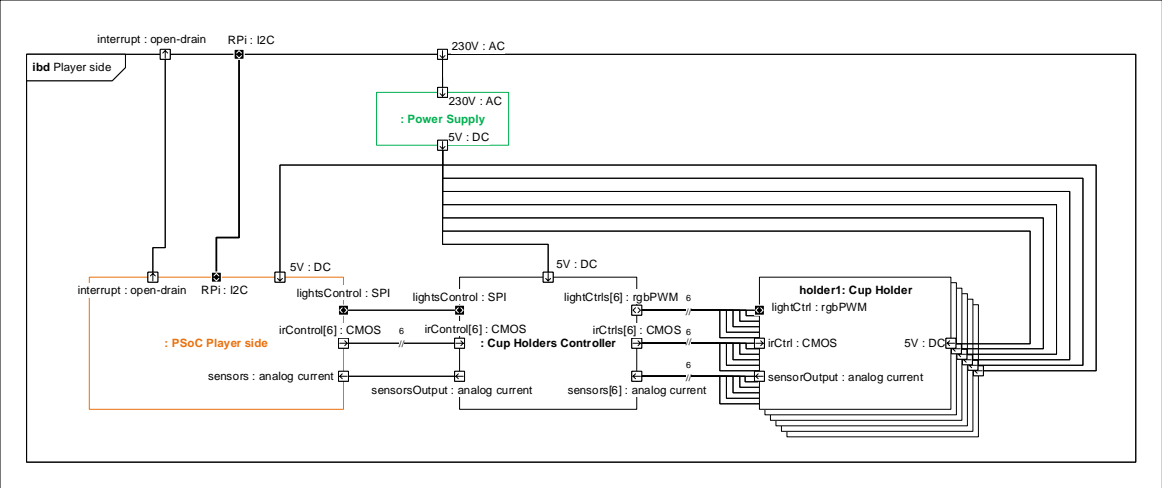
[picture p83: page 6]
lightCtrl : rgbPWM; holder1: Cup Holder; RPi : I2C; lightsControl : SPI; lightCtrl; : rgbPWM; lightCtrls[6] : rgbPWM; irControl[6] : CMOS; irCtrls[6] : CMOS; sensorsOutput :; analog current; sensors[6] : analog current; : Power Supply

interrupt : open-drain

ibd Player side

// | lightCtrl | : rgbPWM holder1: | Cup Holder

: PSoC Player side

: Cup Holders Controller

irCtrl : CMOS | 5V : DC

6 | irCtrl : CMOS | 5V : DC

irCtrl : CMOS
sensorOutput : analog current
out sensorOutput : analog current

sensors : analog current

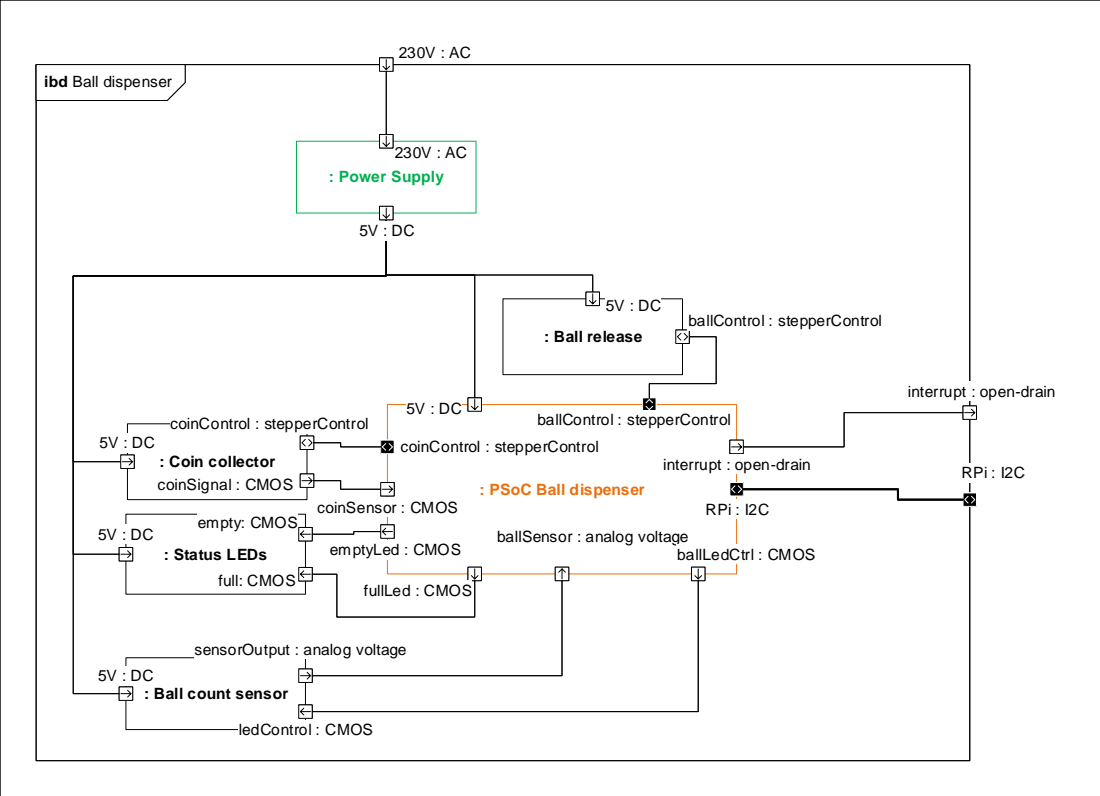
[picture p84: page 7]
: Coin collector; ballControl : stepperControl; coinControl : stepperControl; coinSignal : CMOS; RPi : I2C; : Status LEDs; emptyLed : CMOS; : Ball release; : Power Supply; ledControl : CMOS; ballLedCtrl : CMOS

ibd Ball dispenser

interrupt | : open-drain

interrupt : open-drain

: PSoC Ball dispenser

coinSensor : CMOS | RPi : I2C

empty: CMOS

ballSensor : analog voltage

fullLed : CMOS full: CMOS

sensorOutput : analog voltage

: Ball count sensor

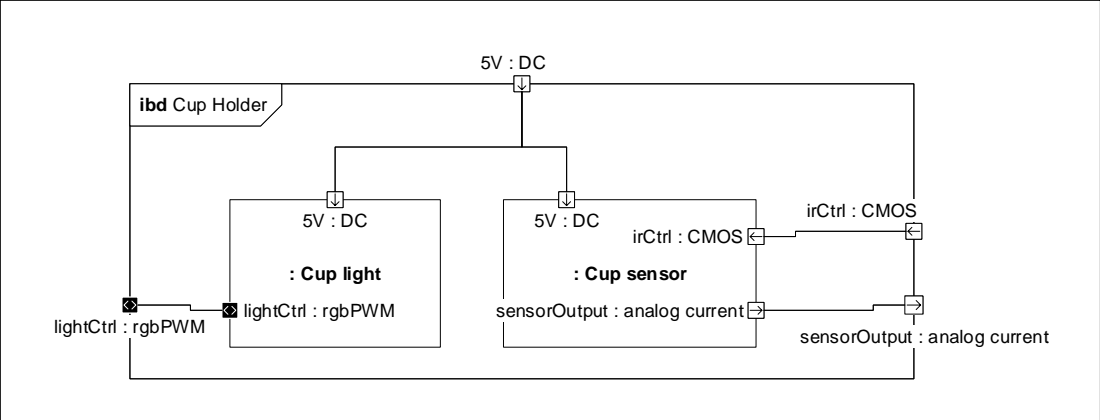
[picture p85: page 8]
: Cup light; : Cup sensor; irCtrl : CMOS; lightCtrl : rgbPWM; sensorOutput; : analog current

ibd Cup Holder

sensorOutput : analog current

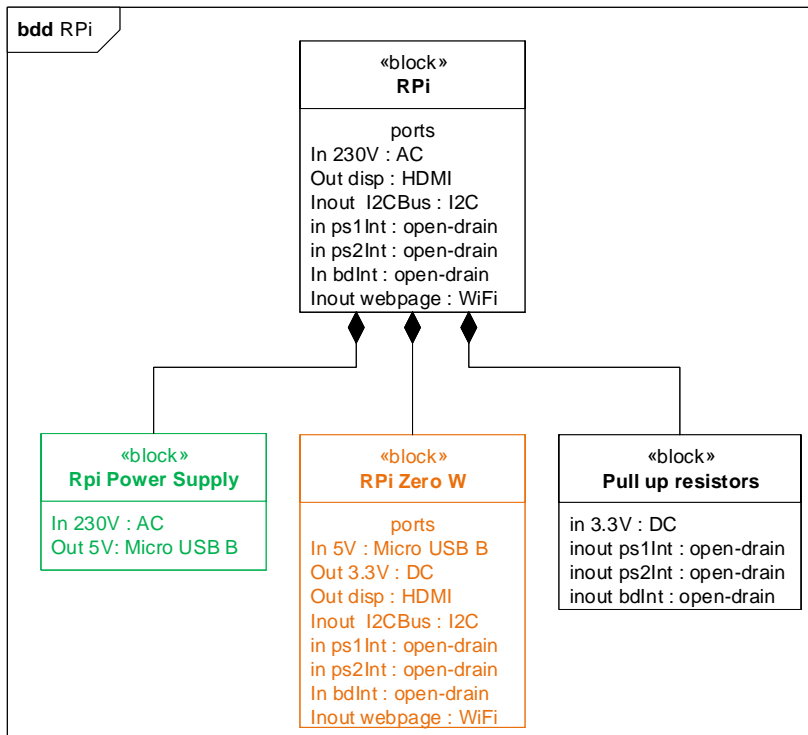
[picture p86: figure]
ports In 5V : Micro USB B Out 3.3V : DC Out disp : HDMI Inout I2CBus : I2C in ps1Int : open-drain in ps2Int : open-drain In bdInt : open-drain Inout webpage : WiFi; «block» RPi Zero W; In 230V : AC Out 5V: Micro USB B; «block» Rpi Power Supply; in 3.3V : DC inout ps1Int : open-drain inout ps2Int : open-drain inout bdInt : open-drain; «block» Pull up resistors; ports In 230V : AC Out disp : HDMI Inout I2CBus : I2C in ps1Int : open-drain in ps2Int : open-drain In bdInt : open-drain Inout webpage : WiFi; «block» RPi; bdd RPi
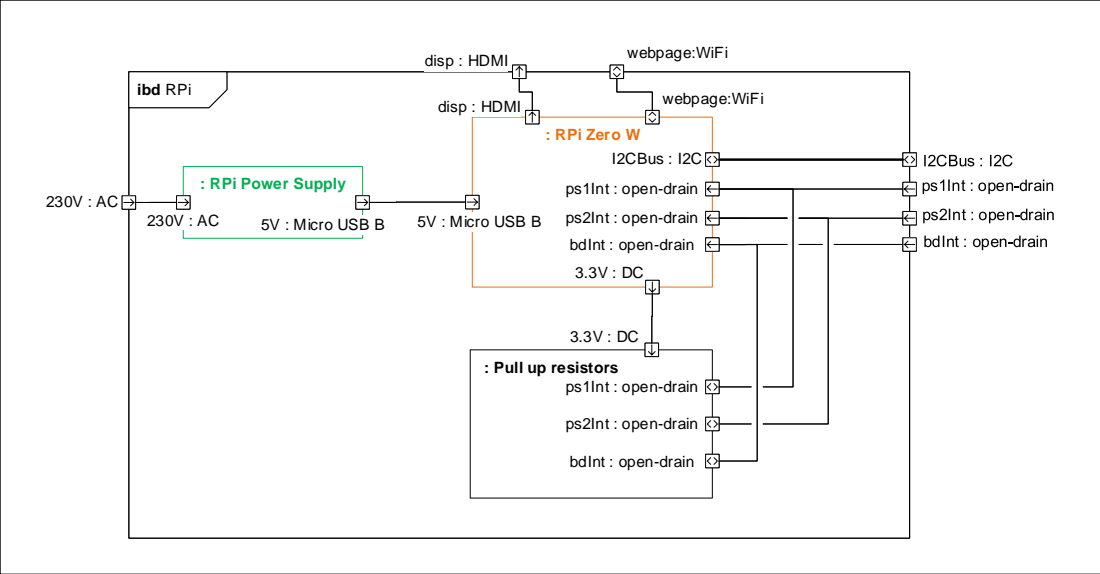
[picture p87: page 10]
: RPi Zero W; disp : HDMI; webpage:WiFi; 5V : Micro USB B; I2CBus : I2C; ps1Int : open-drain; ps2Int : open-drain; ibd RPi

: RPi Power Supply

ps2Int : open-drain
bdInt : open-drain

: Pull up resistors

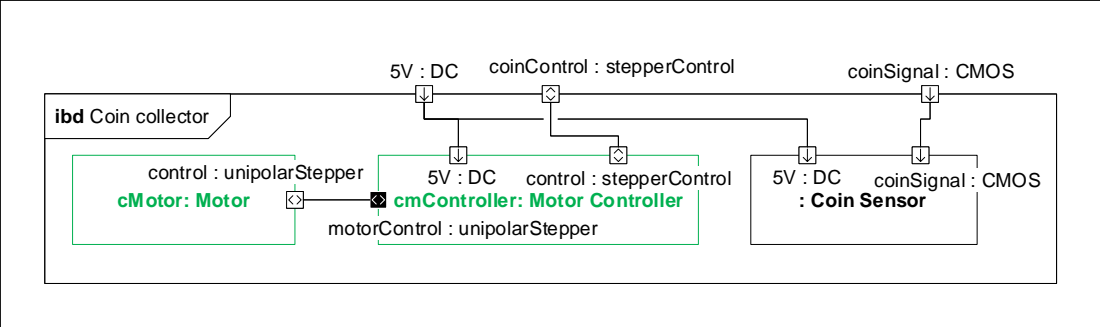
[picture p88: page 11]
control : stepperControl; control : unipolarStepper; coinSignal :; CMOS; coinControl : stepperControl; coinSignal : CMOS

ibd Coin collector

cMotor: Motor | cmController: Motor Controller | : Coin Sensor

motorControl : unipolarStepper

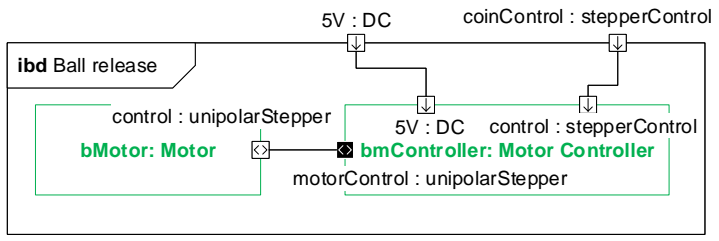
[picture p89: figure]
bMotor: Motor; bmController: Motor Controller; control : stepperControl; motorControl : unipolarStepper; control : unipolarStepper; ibd Ball release; coinControl : stepperControl
