prj3grp7/prj3_projekt_dokumentation/Kravspecifikation/Krav-spec-diagrammer.pdf

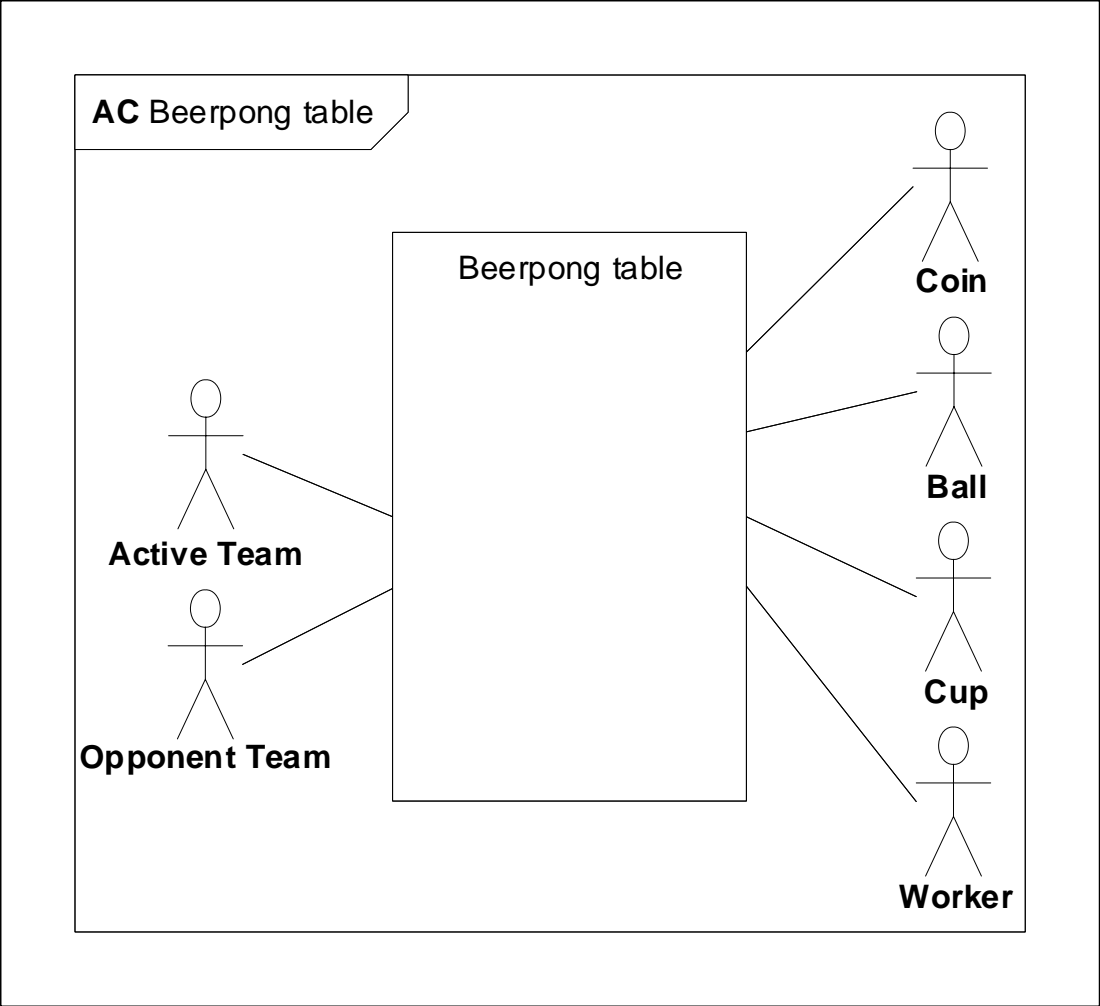
[picture p90: page 1]
Active Team; Opponent Team; Beerpong table; Coin; Ball; Cup; Worker

AC Beerpong table

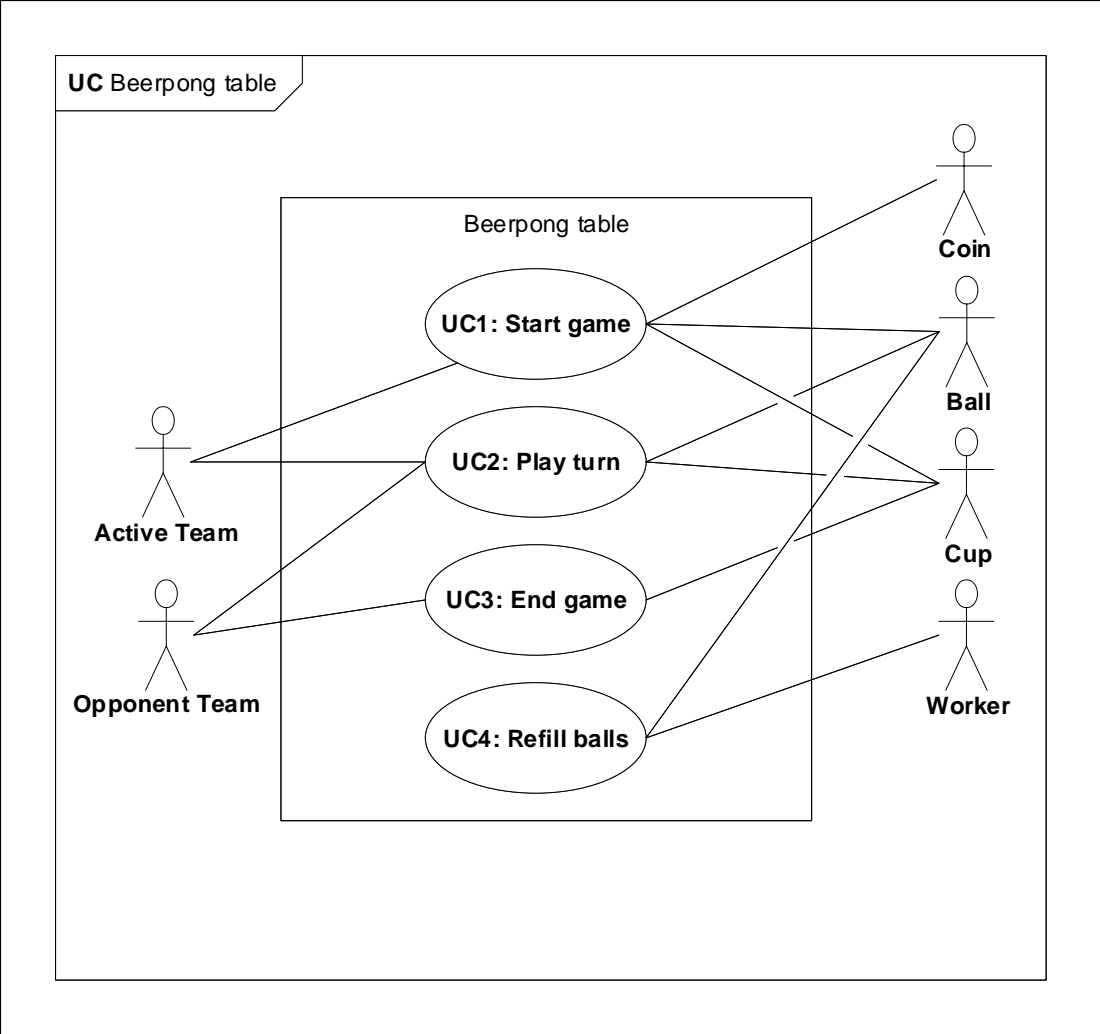
[picture p91: page 2]
Active Team; Beerpong table; UC1: Start game; UC2: Play turn; UC3: End game; UC4: Refill balls; Opponent Team; Coin; Ball; Cup; Worker

UC Beerpong table
