prj3grp7/prj3_projekt_dokumentation/Hardwaredesign/CupSensor/PSoC-design.pdf

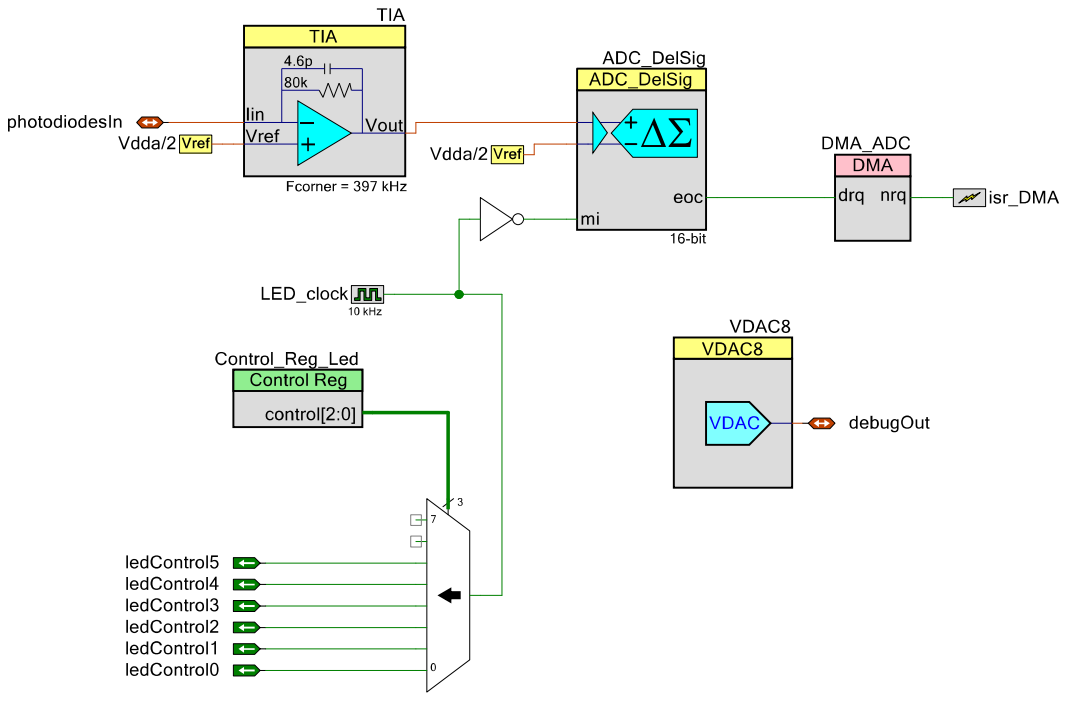
[picture p92: page 1]
