prj3grp7/prj3_projekt_dokumentation/Hardwaredesign/CupSensor/Superposition.pdf

# Fotodiode kredsløb

## PSoC

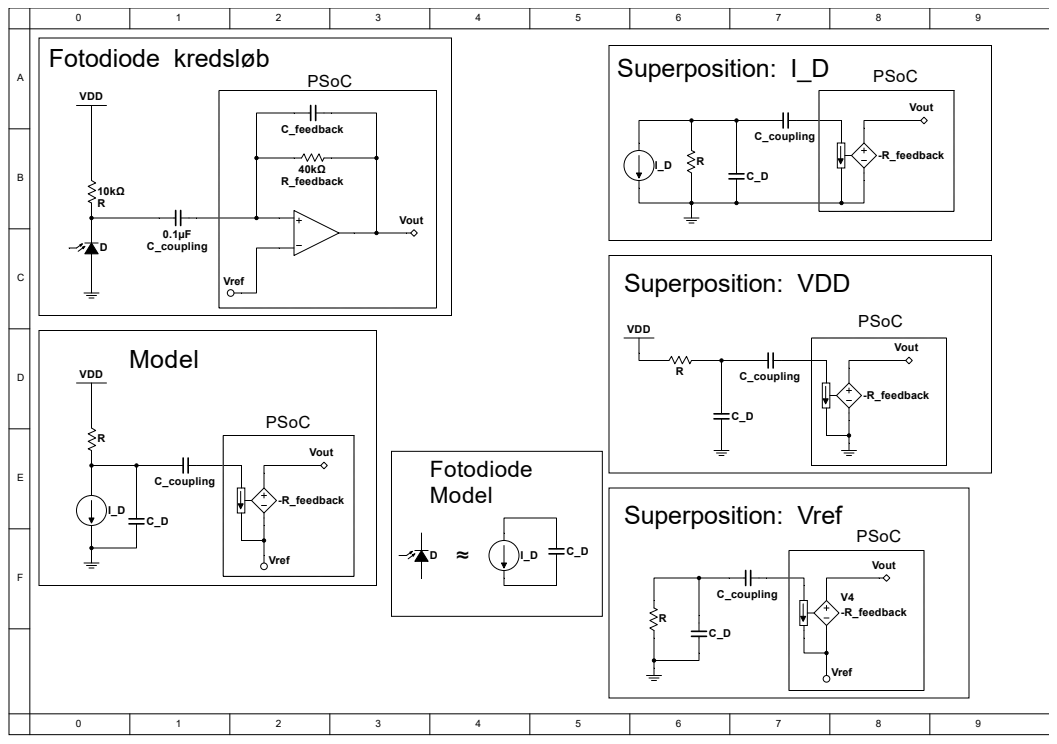
[picture p93: page 1]
VDD; 40kΩ R_feedback; C_feedback; Vref; -R_feedback; Vout; 0.1µF C_coupling; C_coupling; V4 -R_feedback; Model; Superposition: I_D; Superposition: Vref; Superposition: VDD; PSoC; Fotodiode Model

ABCDEF
