prj3grp7/prj3_projekt_dokumentation/Hardwaredesign/CupHolder/Rev2/bund.pdf

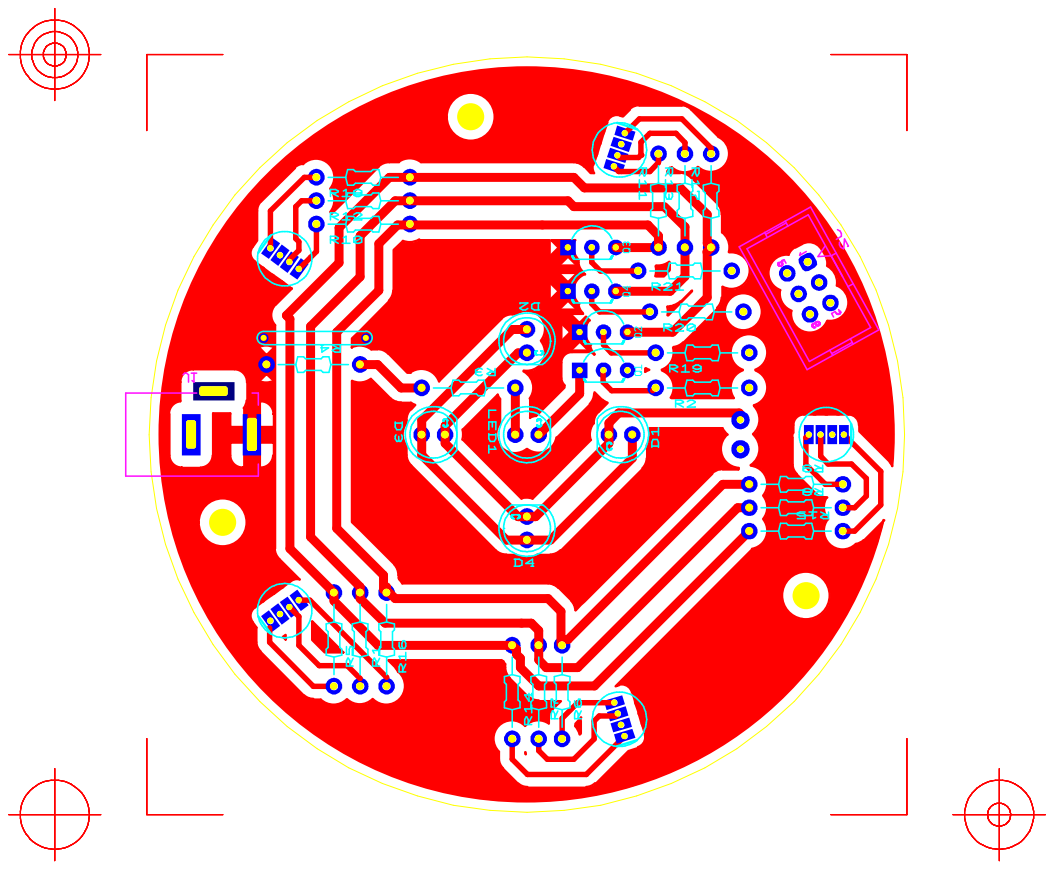
[picture p94: page 1]
