prj3grp7/prj3_projekt_dokumentation/Hardwaredesign/CupHolder/Rev2/CupSensor.pdf

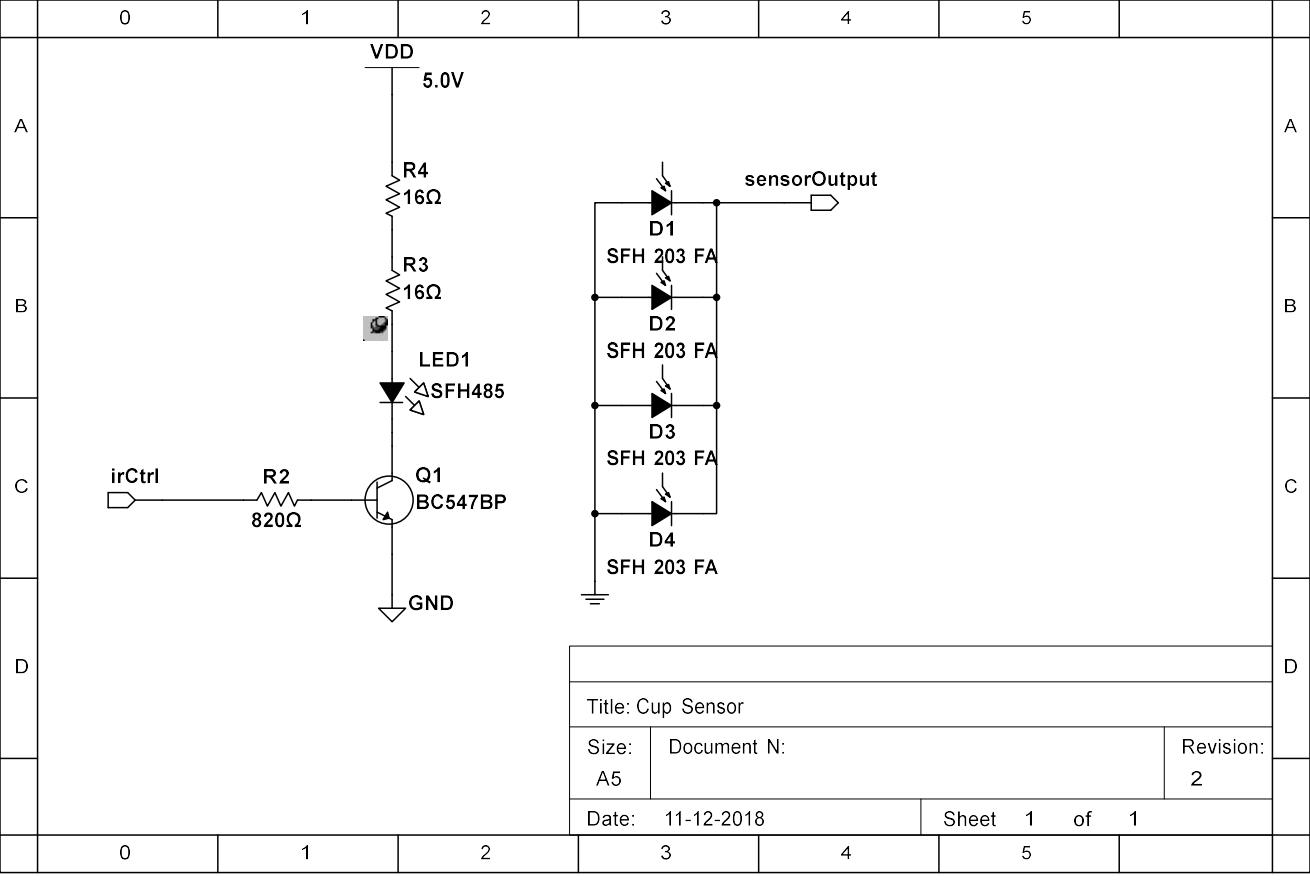
[picture p95: page 1]
