prj3grp7/prj3_projekt_dokumentation/Hardwaredesign/CupHolder/Rev2/top.pdf

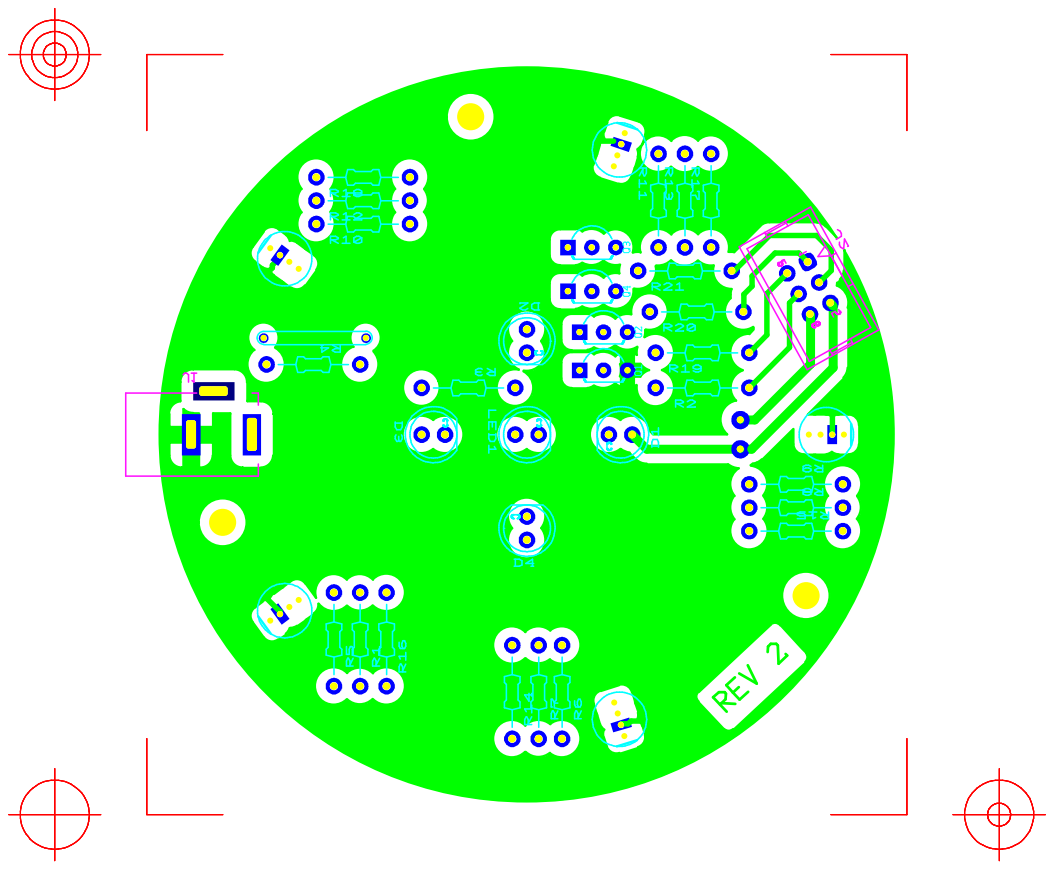
[picture p96: page 1]
