prj3grp7/prj3_projekt_dokumentation/Hardwaredesign/CupSensor/Endelig design/EndeligtDesign.pdf

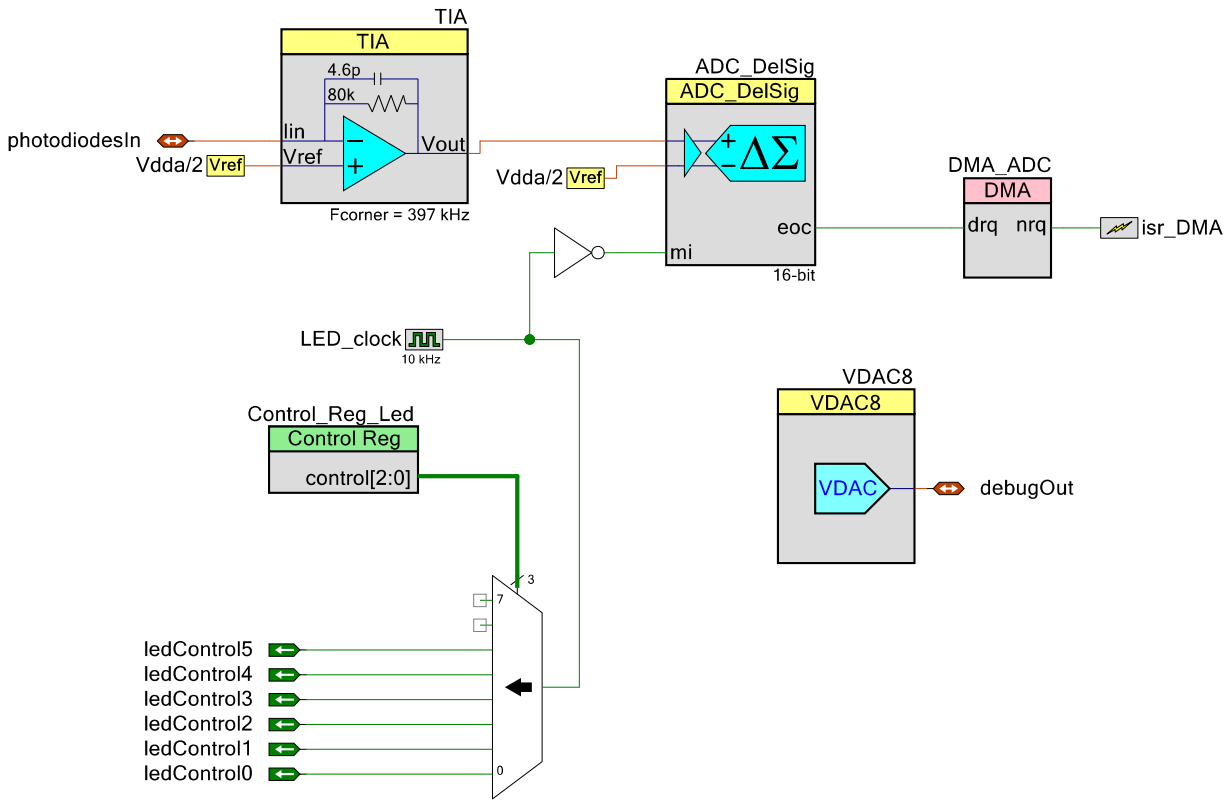
[picture p97: page 1]
