prj3grp7/prj3_projekt_dokumentation/Arkitektur/Beer-pong-flowchart.pdf

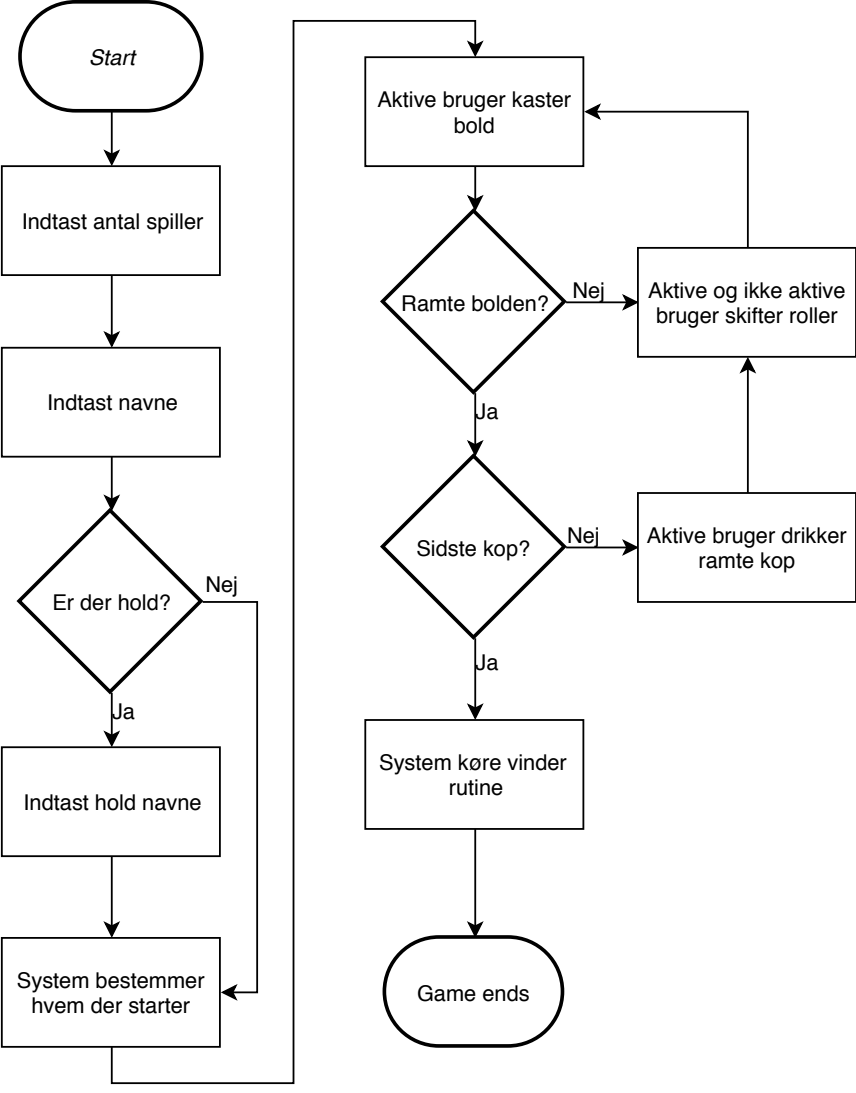
[picture p98: page 1]
Start; Indtast navne; bold; Ramte bolden?; Sidste kop?; rutine; Game ends; Nej

Aktive bruger kaster

Indtast antal spiller

Aktive og ikke aktive
bruger skifter roller

Aktive bruger drikker
ramte kop

Er der hold?

System køre vinder

Indtast hold navne

System bestemmer
hvem der starter
