prj3grp7/prj3_projekt_dokumentation/Kravspecifikation/LEDplacement.pdf

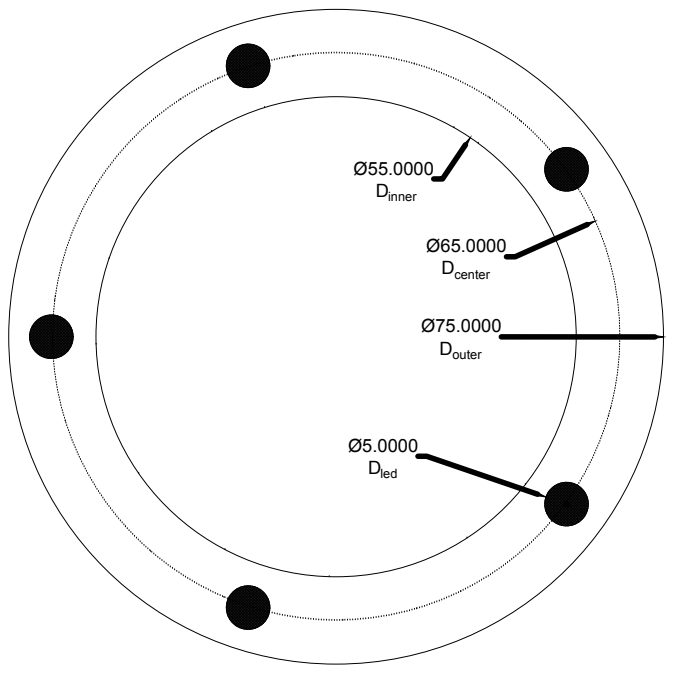
[picture p99: page 1]

Ø55.0000 Dinner Ø65.0000 Dcenter Ø75.0000 Douter Ø5.0000 Dled
