prj3grp7/prj3_projekt_dokumentation/Arkitektur/Softwarearkitektur/RPi/Applikationsmodel_v3/App_v3.pdf

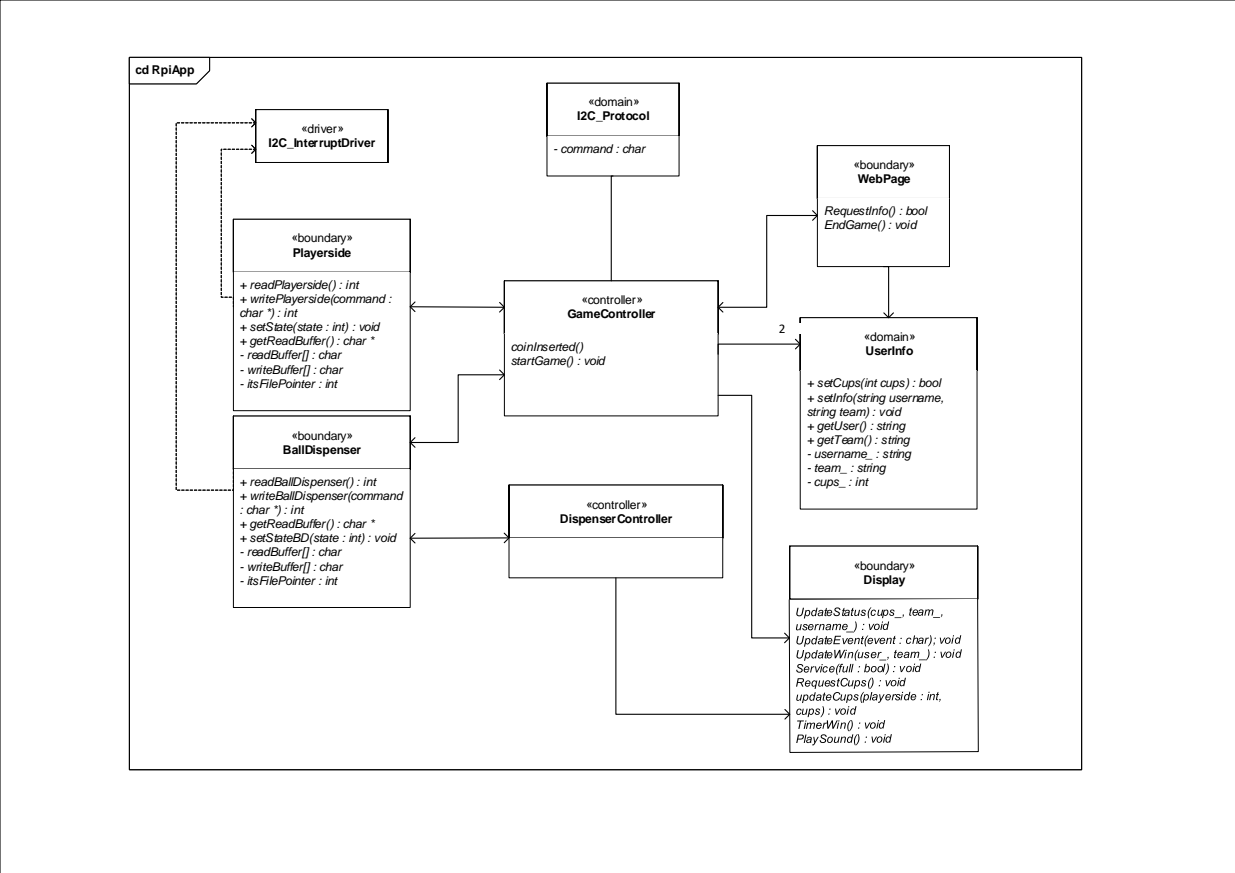
[picture p100: page 1]
«controller» GameController; «boundary» WebPage; coinInserted() startGame() : void; RequestInfo() : bool EndGame() : void; «domain» UserInfo; «driver» I2C_InterruptDriver; «boundary» Playerside; «boundary» BallDispenser; «domain» I2C_Protocol; - command : char; «controller» DispenserController; «boundary» Display; cd RpiApp

+ readPlayerside() : int
+ writePlayerside(command :
char *) : int
+ setState(state : int) : void
+ getReadBuffer() : char * - readBuffer[] : char - writeBuffer[] : char - itsFilePointer : int

+ setCups(int cups) : bool
+ setInfo(string username,
string team) : void
+ getUser() : string
+ getTeam() : string - username_ : string - team_ : string - cups_ : int

+ readBallDispenser() : int
+ writeBallDispenser(command
: char *) : int
+ getReadBuffer() : char *
+ setStateBD(state : int) : void - readBuffer[] : char - writeBuffer[] : char - itsFilePointer : int

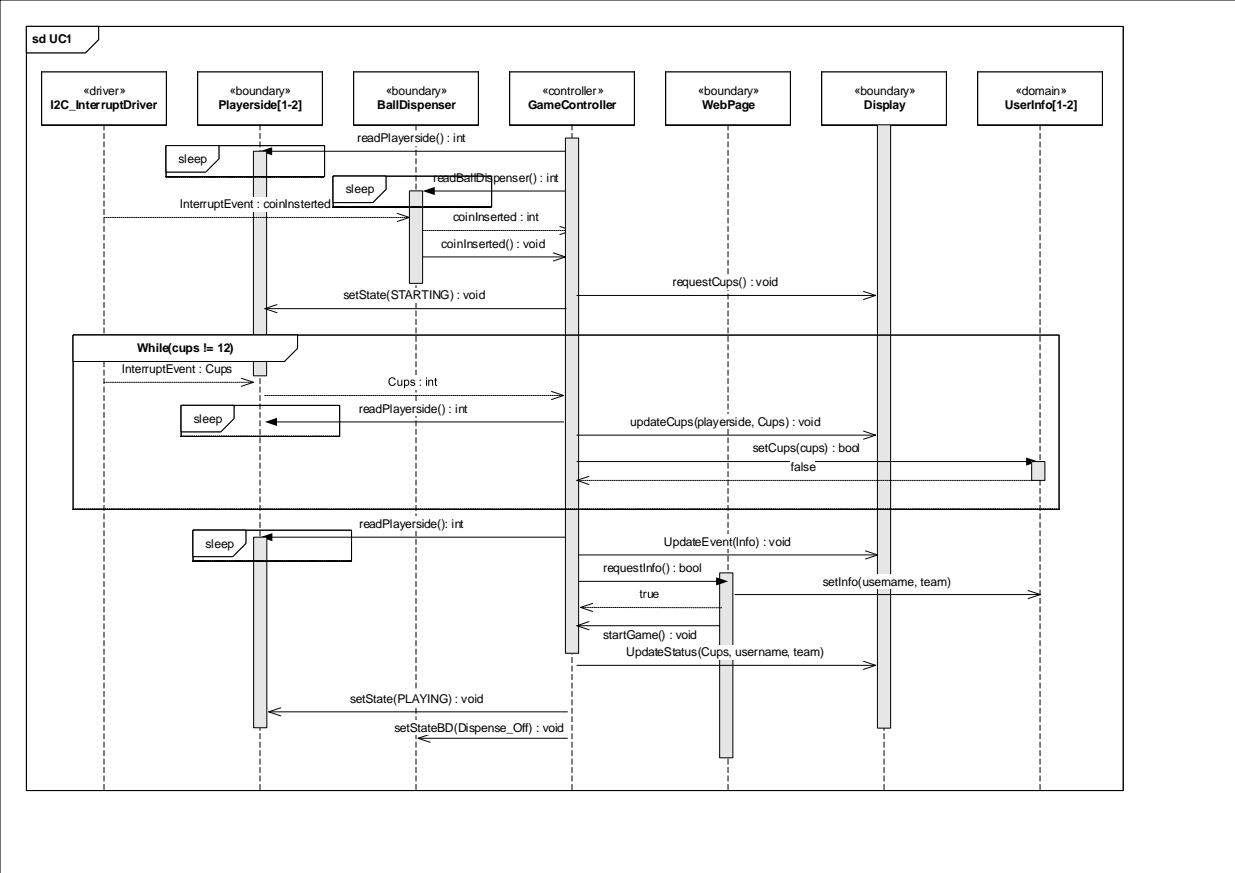
[picture p101: page 2]
«driver» I2C_InterruptDriver; «boundary» Playerside[1-2]; «boundary» BallDispenser; «controller» GameController; «boundary» WebPage; «boundary» Display; «domain» UserInfo[1-2]; readBallDispenser() : int; coinInserted : int; sleep; requestCups() : void; readPlayerside() : int; InterruptEvent : coinInsterted; InterruptEvent : Cups; While(cups != 12); updateCups(playerside, Cups) : void; setStateBD(Dispense_Off) : void; readPlayerside(): int; false; requestInfo() : bool; coinInserted() : void

setState(STARTING) : void

setCups(cups) : bool

UpdateEvent(Info) : void

setInfo(username, team)

startGame() : void
UpdateStatus(Cups, username, team)

setState(PLAYING) : void

«boundary»
WebPage

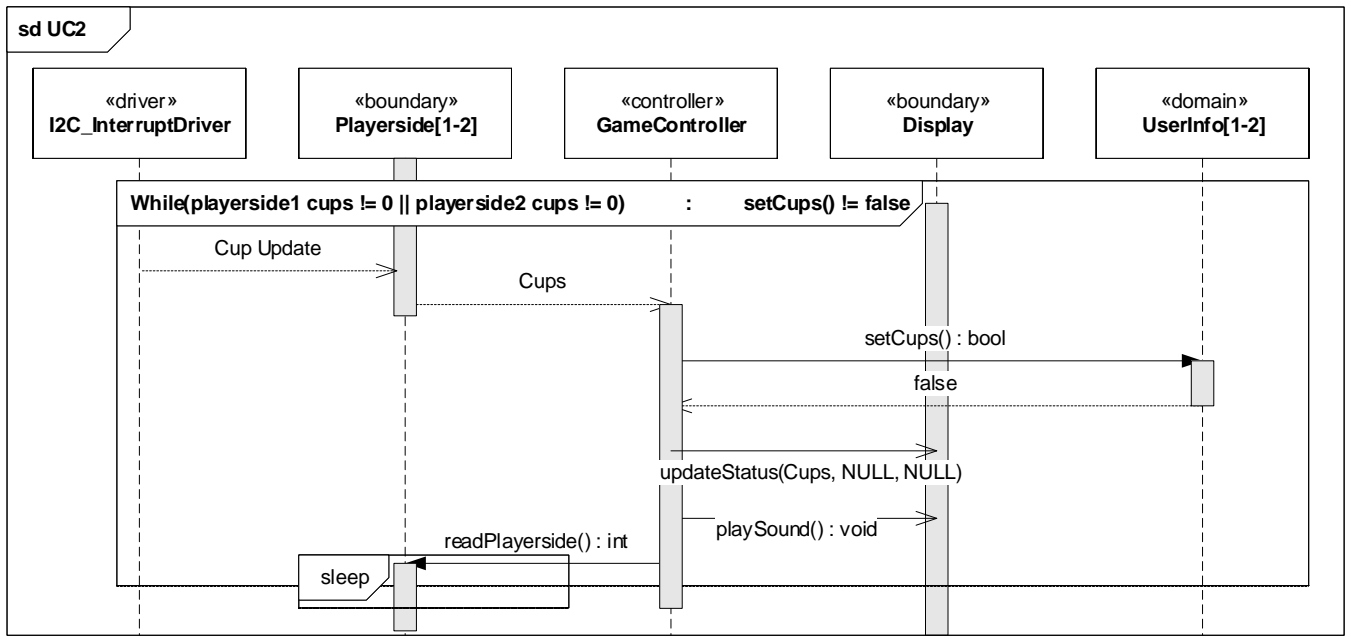
[picture p102: figure]
setCups() : bool; readPlayerside() : int; «driver» I2C_InterruptDriver; «boundary» Playerside[1-2]; «controller» GameController; «boundary» Display; «domain» UserInfo[1-2]; Cup Update; Cups; false; playSound() : void; updateStatus(Cups, NULL, NULL); sleep

While(playerside1 cups != 0 || playerside2 cups != 0) | : | setCups() != false

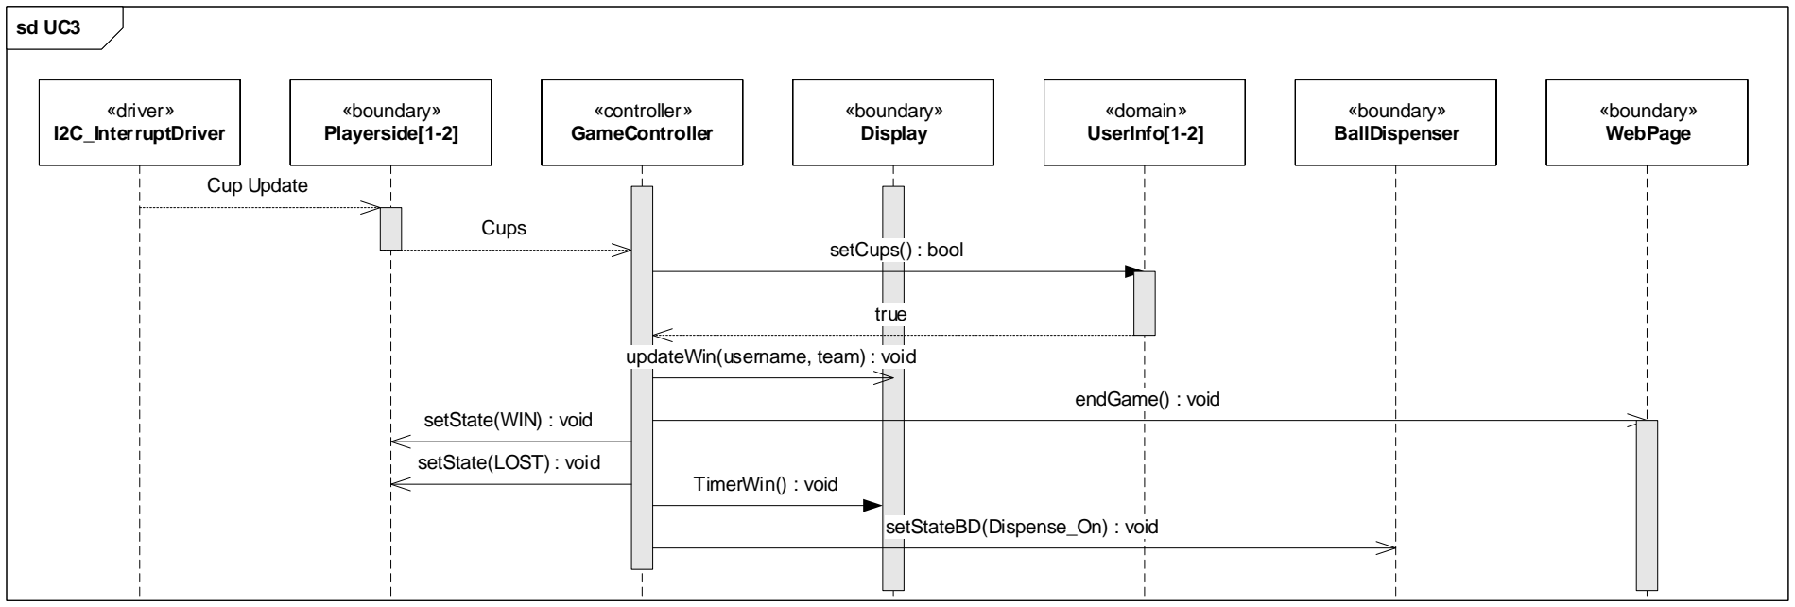
[picture p103: figure]
«driver» I2C_InterruptDriver; «boundary» Playerside[1-2]; «controller» GameController; «boundary» Display; «domain» UserInfo[1-2]; «boundary» BallDispenser; Cup Update; Cups; setCups() : bool; true; updateWin(username, team) : void; «boundary» WebPage; endGame() : void; setState(WIN) : void; setState(LOST) : void; TimerWin() : void; setStateBD(Dispense_On) : void
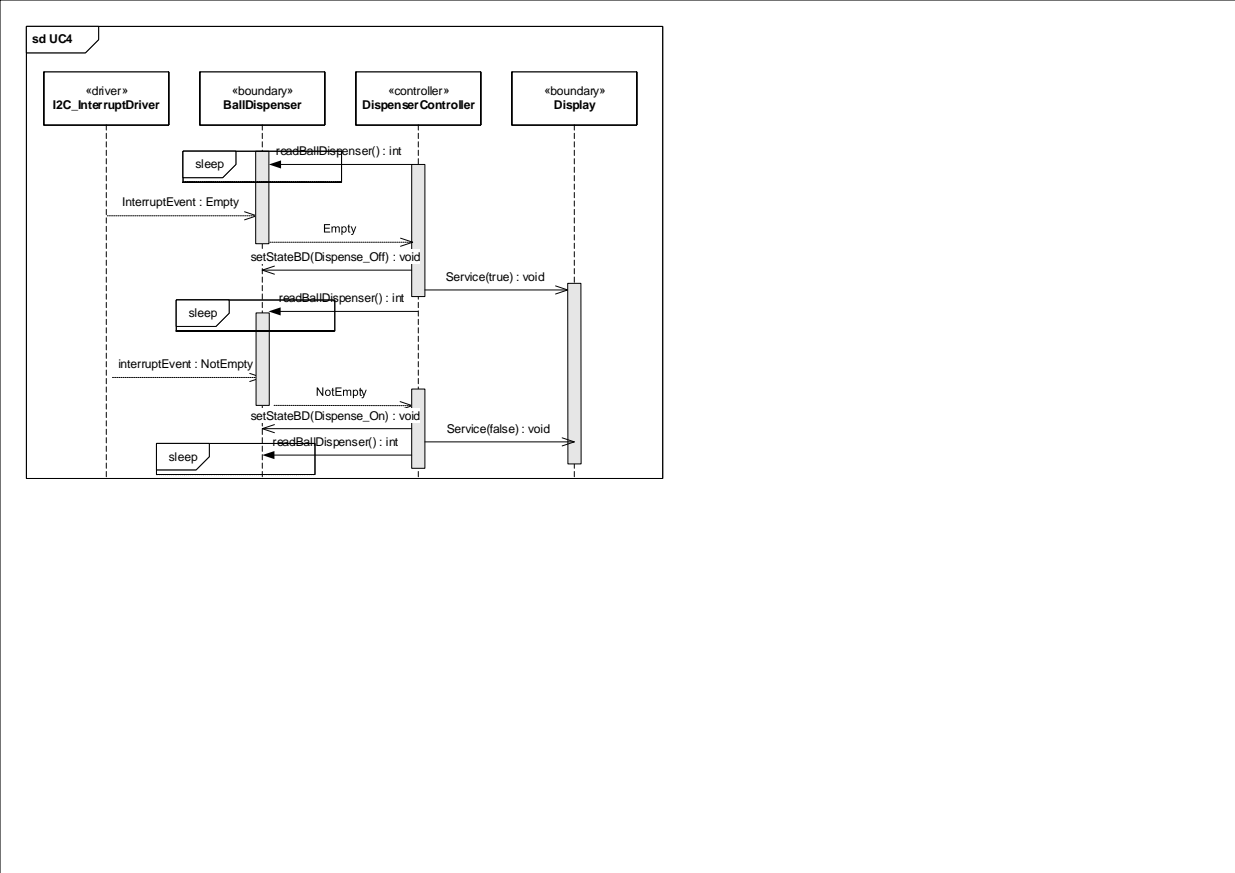
[picture p104: page 5]
«driver» I2C_InterruptDriver; «controller» DispenserController; «boundary» Display; «boundary» BallDispenser; InterruptEvent : Empty; readBallDispenser() : int; interruptEvent : NotEmpty; sleep; setStateBD(Dispense_Off) : void; setStateBD(Dispense_On) : void

Service(true) : void

Service(false) : void

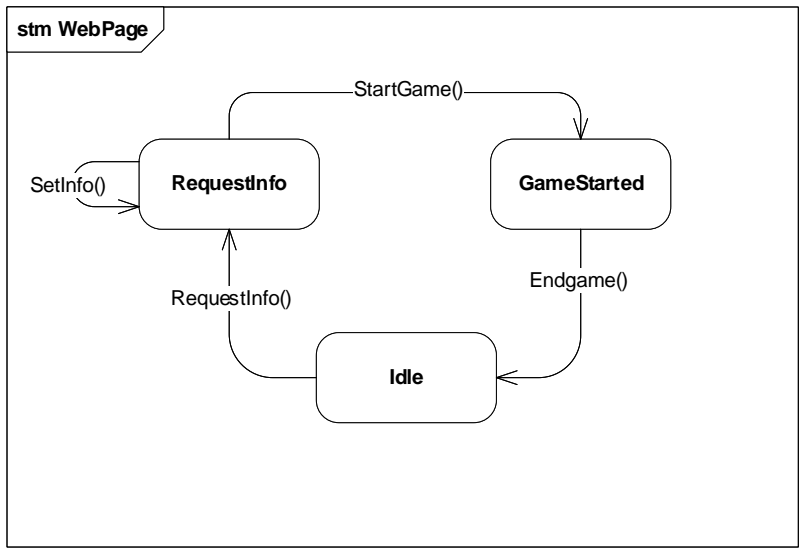
[picture p105: figure]
stm WebPage; RequestInfo; GameStarted; Idle; StartGame(); Endgame(); RequestInfo(); SetInfo()
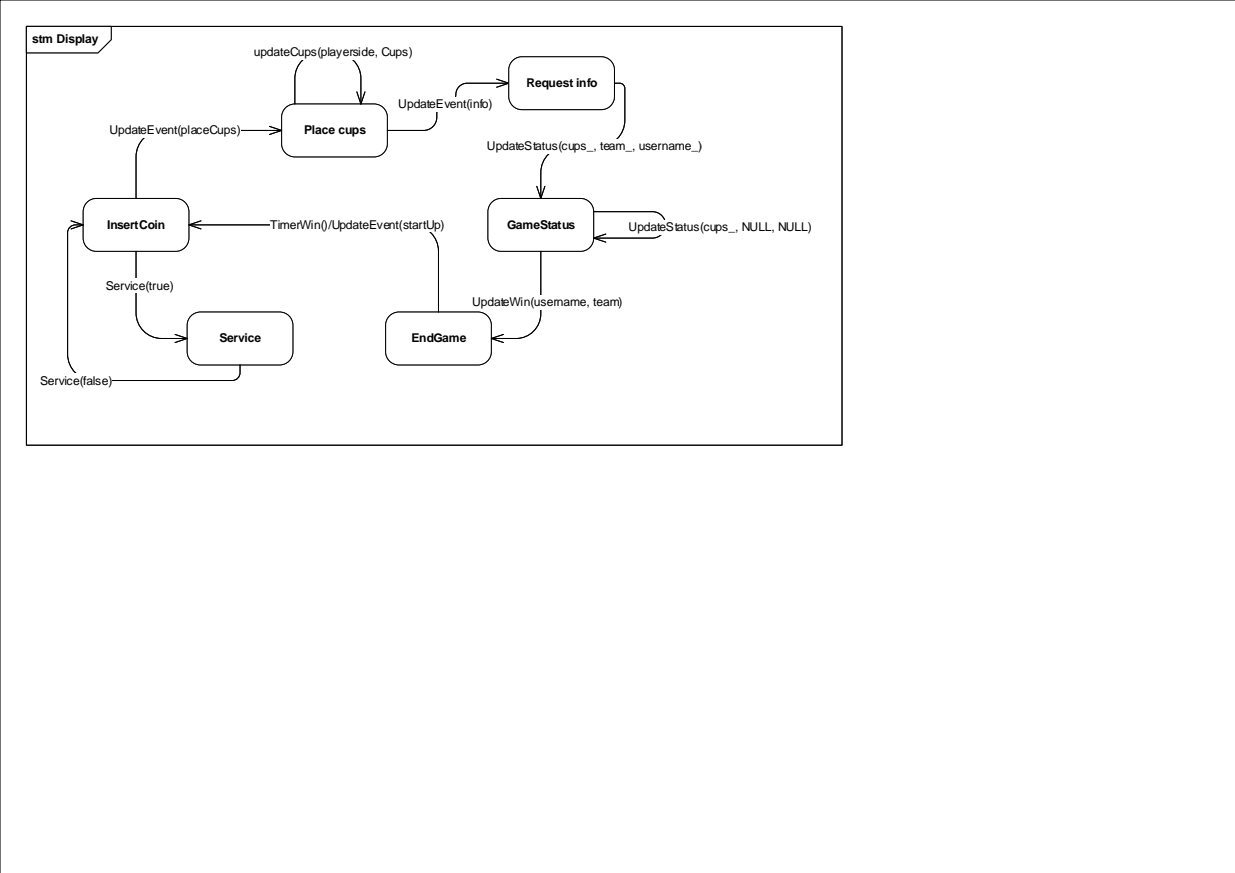
[picture p106: page 7]
stm Display; InsertCoin; Place cups; GameStatus; Service; EndGame; Service(true); UpdateEvent(placeCups); UpdateEvent(info); Service(false); Request info; UpdateStatus(cups_, team_, username_)

updateCups(playerside, Cups)

TimerWin()/UpdateEvent(startUp)

UpdateStatus(cups_, NULL, NULL)

UpdateWin(username, team)

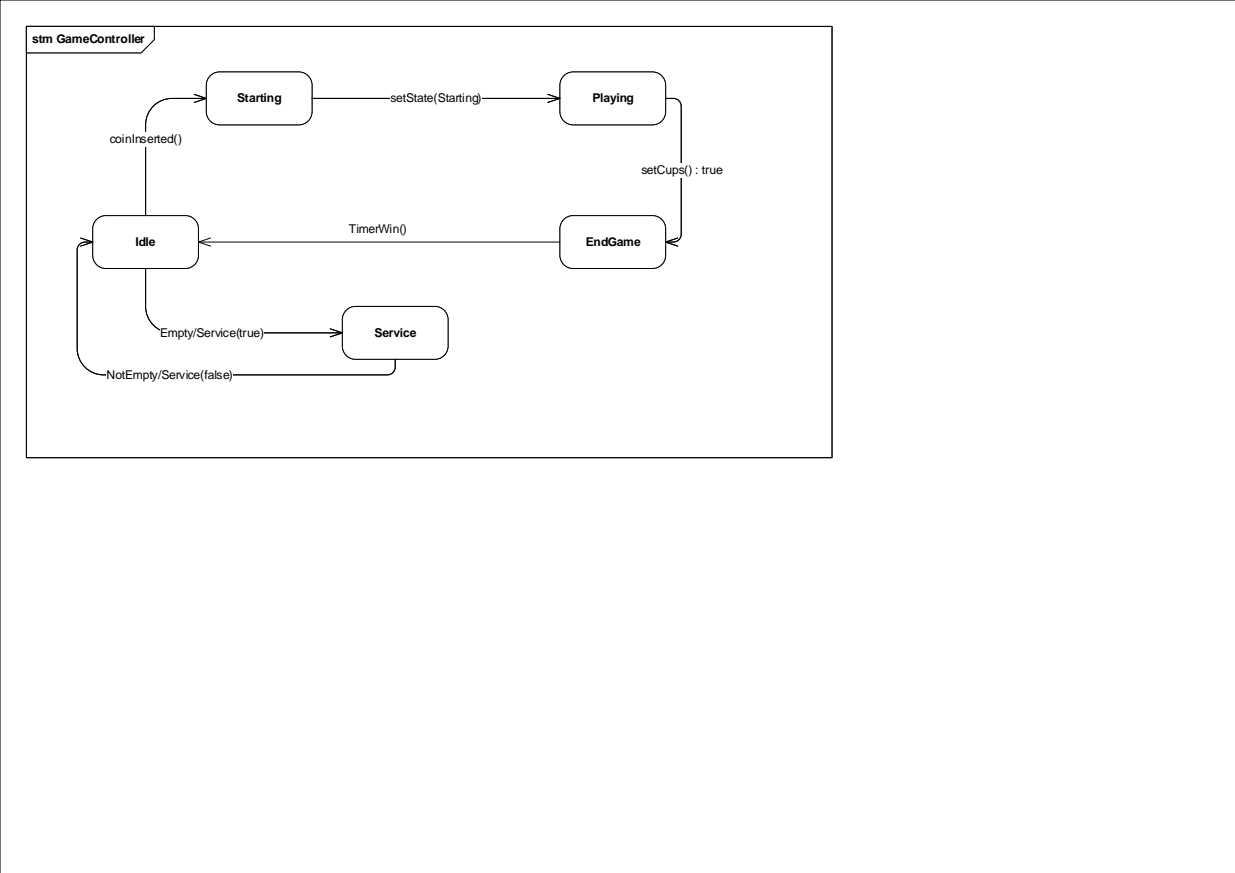
[picture p107: page 8]
stm GameController; Idle; Starting; Playing; EndGame; Service; setCups() : true; setState(Starting); coinInserted(); TimerWin()

Empty/Service(true)

NotEmpty/Service(false)
