prj3grp7/prj3_projekt_dokumentation/Hardwaredesign/CupHolder/Rev1/CupHolderPrintplade.pdf

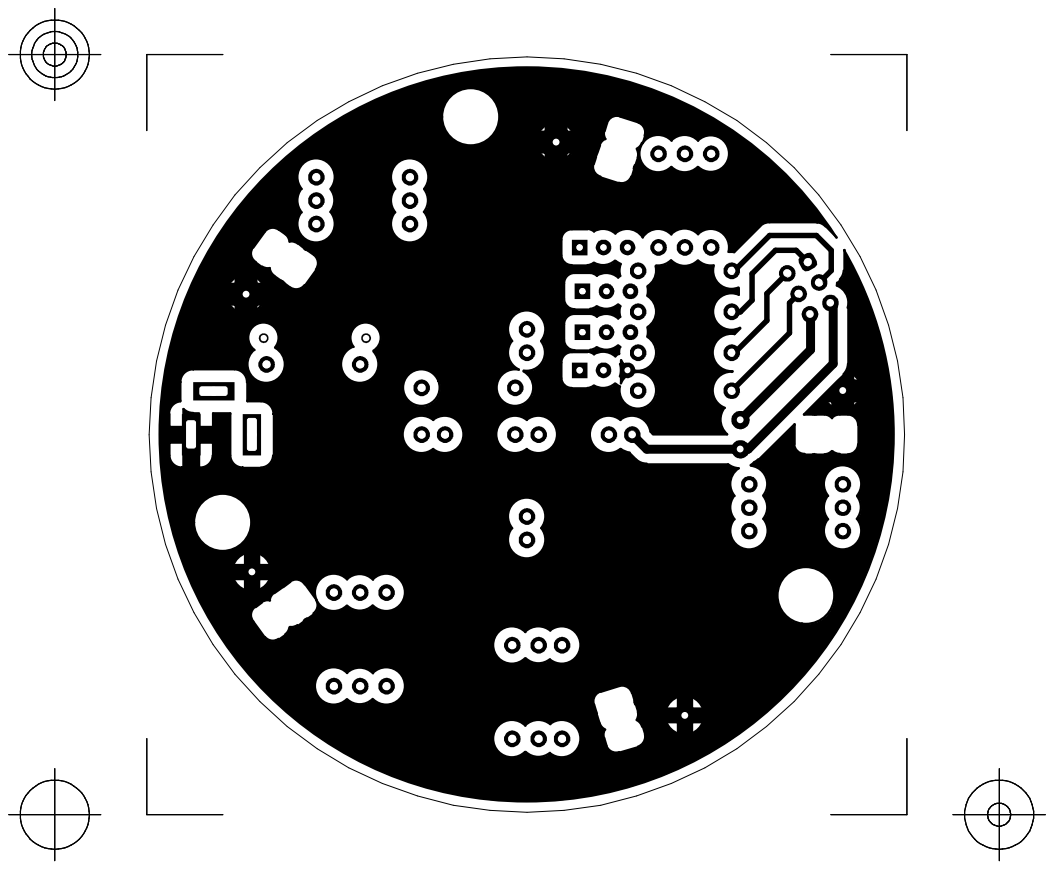
[picture p108: page 1]

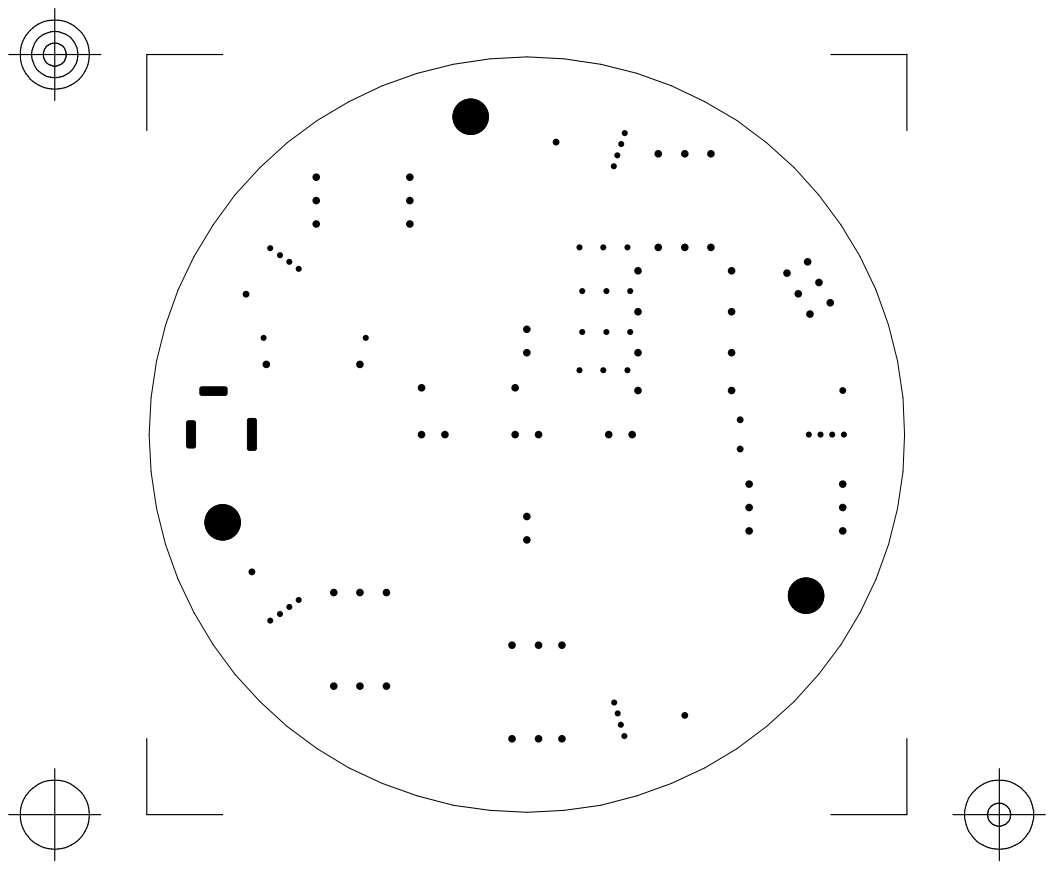
[picture p109: page 2]

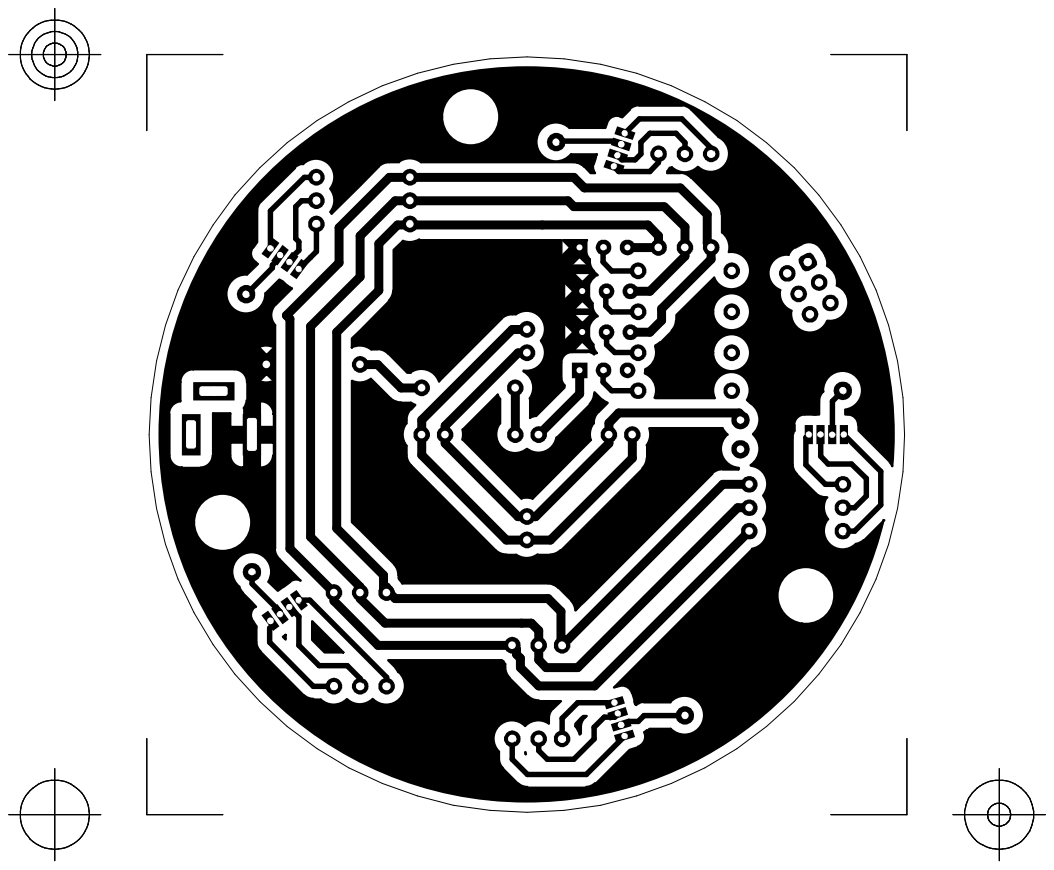
[picture p110: page 3]
