prj3grp7/prj3_projekt_dokumentation/(list of files, drawings)

Other design files:
Hardwaredesign/CupHolder/Rev1/CupHolder.ms14
Hardwaredesign/CupHolder/Rev1/CupLightLedsPart.ms14
Hardwaredesign/CupHolder/Rev1/CupSensorPart.ms14
Hardwaredesign/CupHolder/Rev2/Cup Holder.ms14
Hardwaredesign/CupHolder/Rev2/Cup Light.ms14
Hardwaredesign/CupHolder/Rev2/Cup Sensor.ms14
Hardwaredesign/CupLight_Design/CupLightControlPart.ms14
Hardwaredesign/CupLight_Design/LED_Control.ms14
Hardwaredesign/CupSensor/CupSensor.ms14
Hardwaredesign/CupSensor/Endelig design/Cup Sensor og Cup Holder Controller.ms14
Hardwaredesign/CupSensor/Endelig design/Cup Sensor part.ms14
Hardwaredesign/CupSensor/OptiskSensor.ms14
Hardwaredesign/CupSensor/Superposition.ms14
Hardwaredesign/PlayersidePrint/CupLightControlPart.ms14
Hardwaredesign/PlayersidePrint/CupSensorPart.ms14
Hardwaredesign/PlayersidePrint/PlayersideDesign.ms14
